adrianix360/Proyecto_mecanica_del_solido_2/07_graficos_y_prediccion/README.md

# 07 · Gráficos y predicción con probetas 2018–2019

- `Grafico_1_tension_vs_ancho.png`: resistencia a tensión según el ancho de la barra.
- `Grafico_2_compresion_vs_longitud.png`: resistencia a compresión según la longitud del tubo.
- `Prediccion_colapso_2018-2019.pdf`: predicción de la carga de colapso con las probetas 2018–2019.

Los datos de origen están en `00_enunciado_y_referencias/datos_historicos_probetas`.
