adrianix360/Proyecto_mecanica_del_solido_2/06_revision_de_diseno/README.md

# 06 · Revisión técnica independiente (v01)

Auditoría del diseño hecha antes de cortar las piezas: geometría, fuerzas internas, planos, capacidades de los miembros y verificaciones de las vigas de piso.

- `INFORME_REVISION_v01.md`: veredicto, hallazgos clasificados por gravedad y consultas.
- `Verificacion_v01.xlsx`: hojas de verificación asociadas.

Las observaciones de esta revisión (por ejemplo, H-01 y H-05) se resolvieron en la versión v02 de los planos y del despiece.
