adrianix360/Proyecto_mecanica_del_solido_2/09_informe_final/README.md

# 09 · Informe final

**Pendiente.** Aquí se publicará el informe final: memoria del proceso constructivo, memoria del proceso de falla, análisis y comparación con la predicción, conclusiones y recomendaciones.
