adrianix360/Proyecto_mecanica_del_solido_2/00_enunciado_y_referencias/README.md

# 00 · Enunciado y referencias

Contexto que se tuvo a la mano para desarrollar el proyecto. **Nada de esta carpeta es obra del autor del repositorio ni está cubierto por su licencia**: pertenece a sus respectivos titulares y se incluye solo como contexto académico para quien consulte el trabajo. Si es titular de algún documento y quiere que se retire, escriba al autor (ver el README principal).

| Subcarpeta | Contenido | Origen |
|---|---|---|
| `enunciado/` | Enunciado del proyecto y presentación de la descripción del proyecto | Docente del curso IC-0610, Escuela de Ingeniería Civil, UCR |
| `referencias/` | Ressler, *Designing and Building File-Folder Bridges* (libro y presentación), Ressler, *The Waddell A Truss Bridge*, y el ejemplo 5 del tema 6 (cercha vertical) | S. J. Ressler; material del curso |
| `plano_base_semestre_anterior/` | Planos Warren A0 (láminas de montaje y despiece) de un semestre anterior, usados como punto de partida | Trabajo de un semestre anterior |
| `datos_historicos_probetas/` | Resultados de ensayos de probetas de cartón de 2018–2019, 2022 I, 2022 II y 2023 I (Excel y archivos `.lvm` de LabVIEW) | Ensayos de semestres anteriores del curso |

Notas sobre los datos históricos:

- Los archivos `.lvm` son registros crudos de la máquina de ensayo; algunos corresponden a pruebas repetidas o a respaldos (`backup*.lvm`) y no son utilizables como resultado de una probeta.
- El procesamiento aplicado a estos datos (promedios, exclusiones y curvas) está descrito en el informe de avance y en `07_graficos_y_prediccion`.
