adrianix360/Proyecto_mecanica_del_solido_2/08_falla_del_puente/README.md

# 08 · Falla del puente

**Pendiente.** Aquí se publicará el video de la prueba de carga, el registro fotográfico, la carga máxima alcanzada, el modo de falla y la comparación con la carga predicha (≈ 12,3 kgf).
