adrianix360/Proyecto_mecanica_del_solido_2/01_avance_escrito/README.md

# 01 · Informe de avance

[`Avance_Proyecto_Puente_Warren_IC-0610.pdf`](Avance_Proyecto_Puente_Warren_IC-0610.pdf): informe de avance del proyecto (24 páginas, octubre de 2026).

Contenido: introducción, descripción del proyecto, descripción y justificación de la geometría, propiedades de diseño de los miembros, cálculo de fuerzas internas (método de nodos y CSiBridge), predicción de la carga de colapso (≈ 12,3 kgf con FS = 1,75), referencias y anexos.

El informe fue elaborado en grupo. Esta es una **copia pública**: se omitieron de la portada los nombres, los carnés y el nombre de la docente, y se eliminaron los metadatos de autoría del archivo.
