adrianix360/Proyecto_mecanica_del_solido_2/00_enunciado_y_referencias/referencias/Tema_6_Ejemplo_5_cercha_vertical.pdf

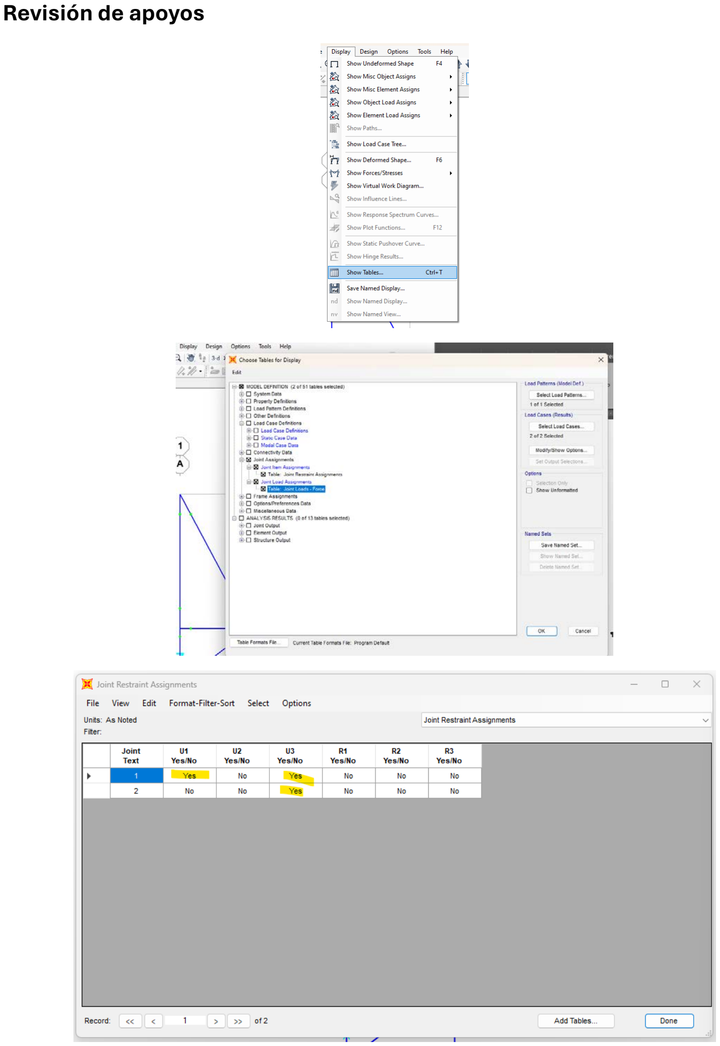
[picture p17: page 1]

Revisión de apoyos

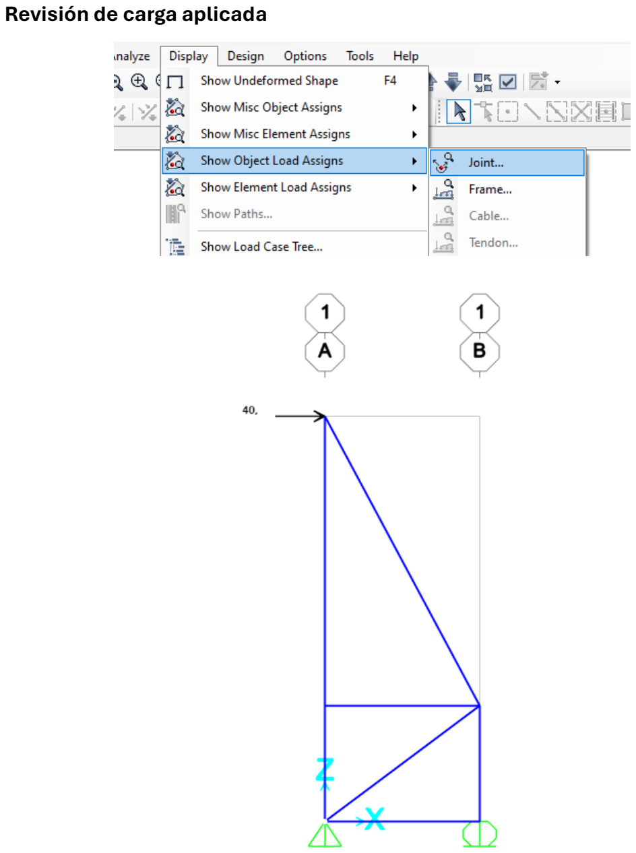
[picture p18: page 2]

Revisión de carga aplicada

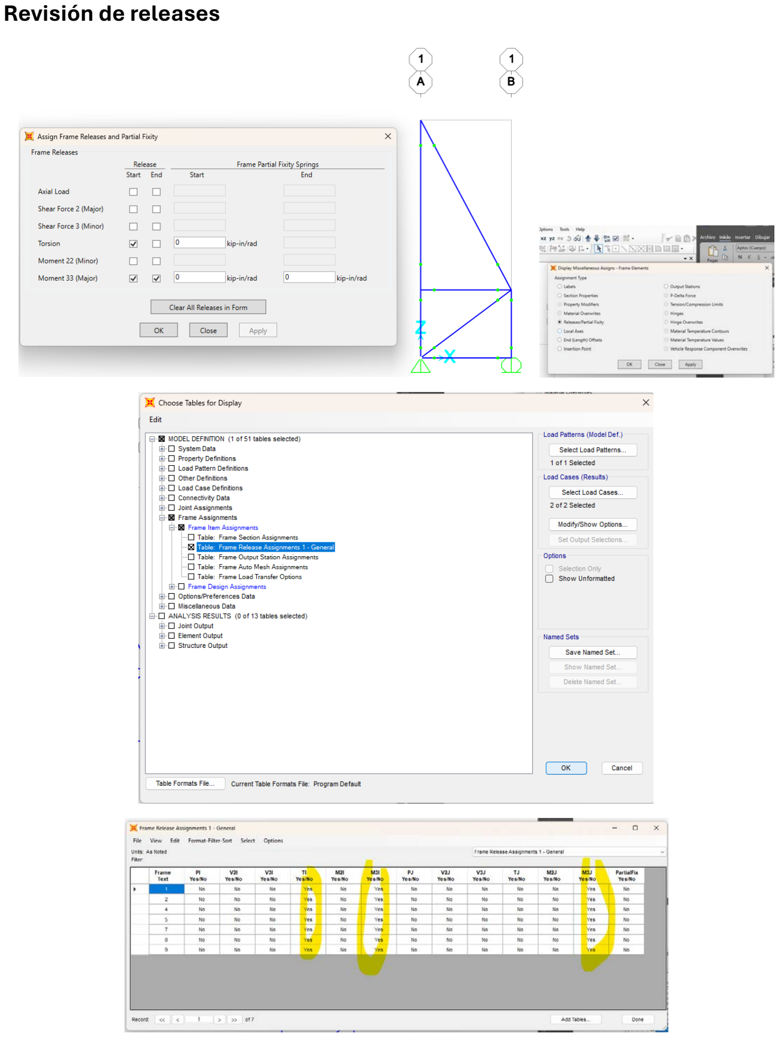
[picture p19: page 3]

Revisión de releases

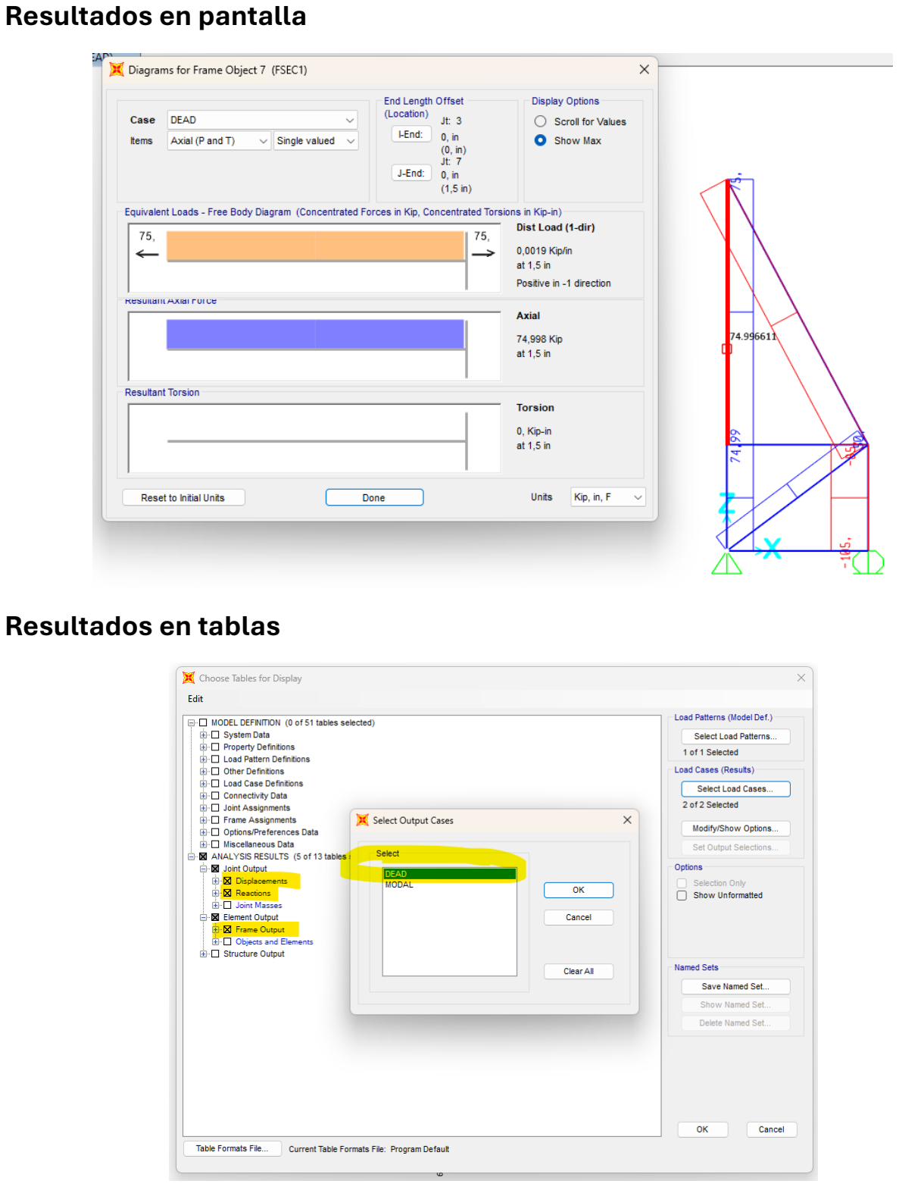
[picture p20: page 4]

Resultados en pantalla

Resultados en tablas

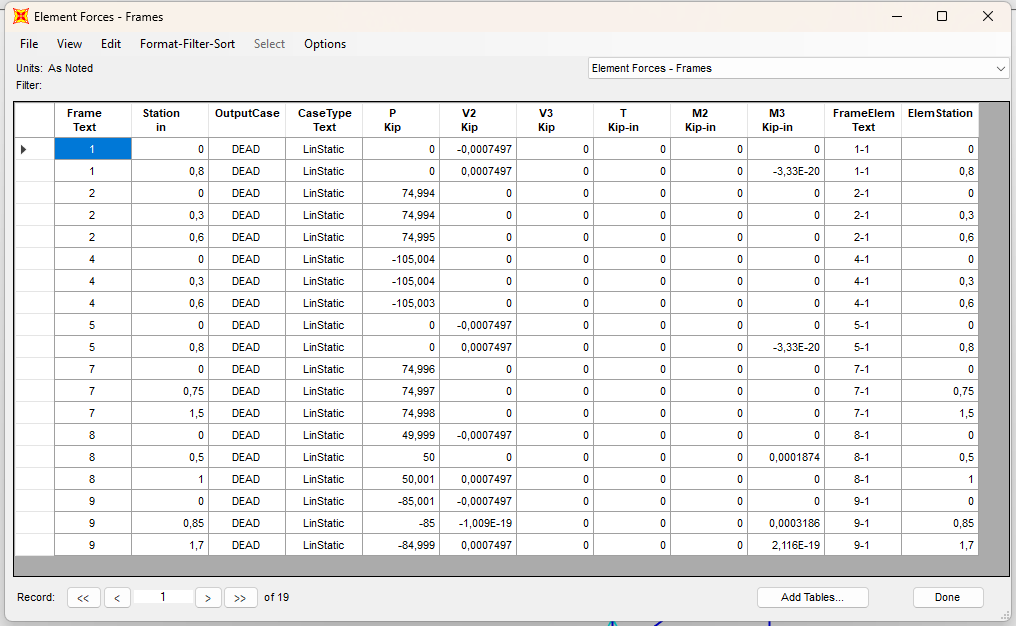
[picture p21: figure]
