adrianix360/Proyecto_mecanica_del_solido_2/04_despiece_corte_cameo/vista_previa/T08_v02.png

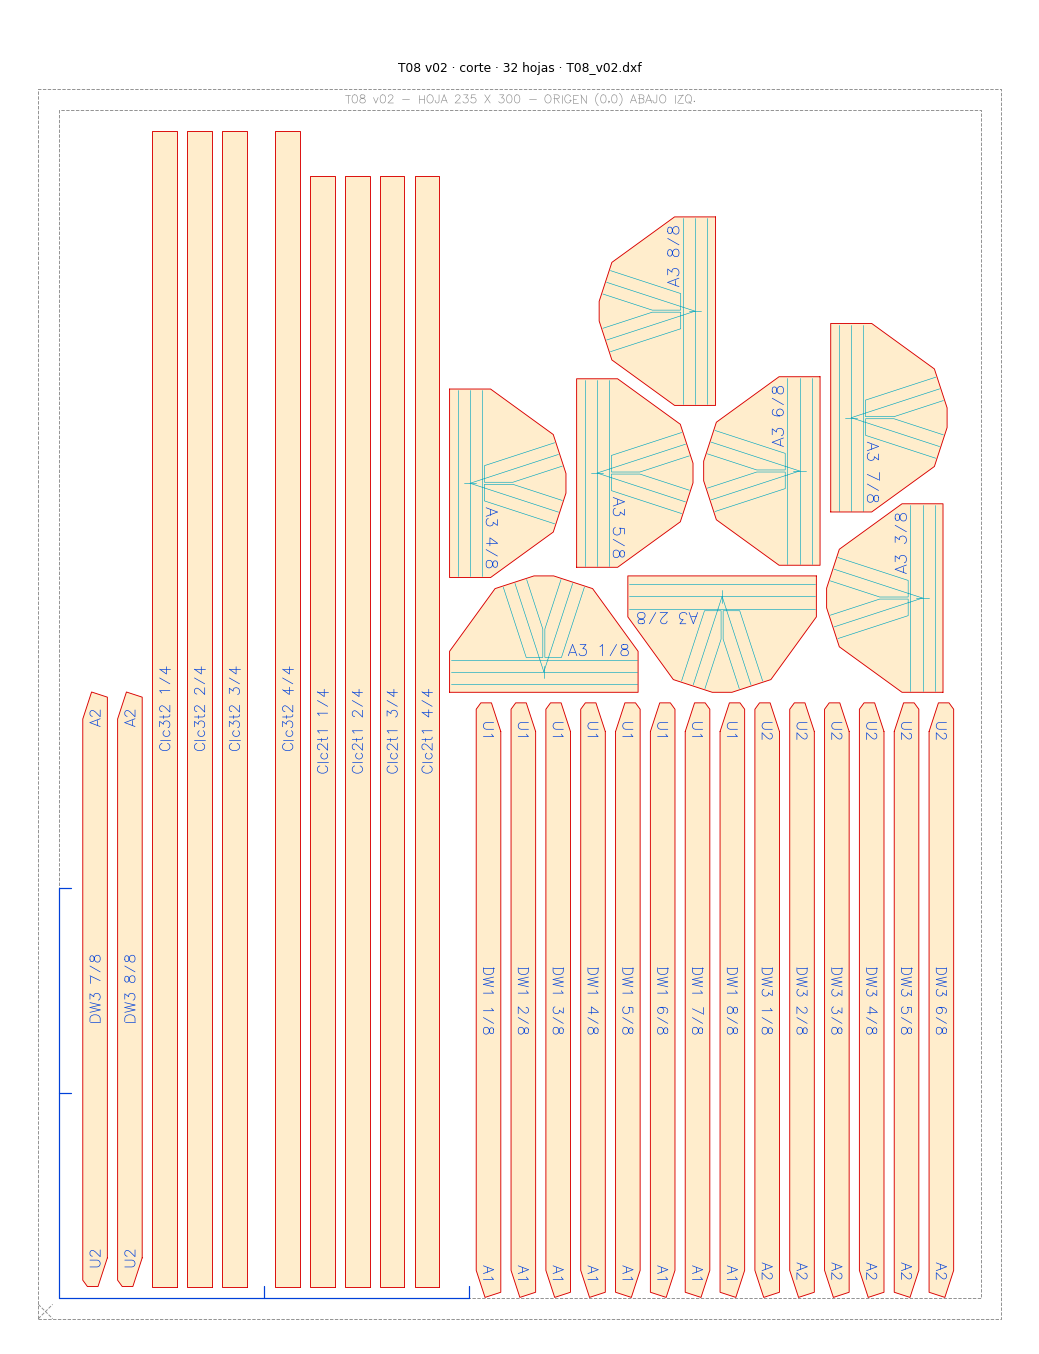
04_despiece_corte_cameo/vista_previa/T08_v02.png
