adrianix360/Proyecto_mecanica_del_solido_2/07_graficos_y_prediccion/Grafico_1_tension_vs_ancho.png

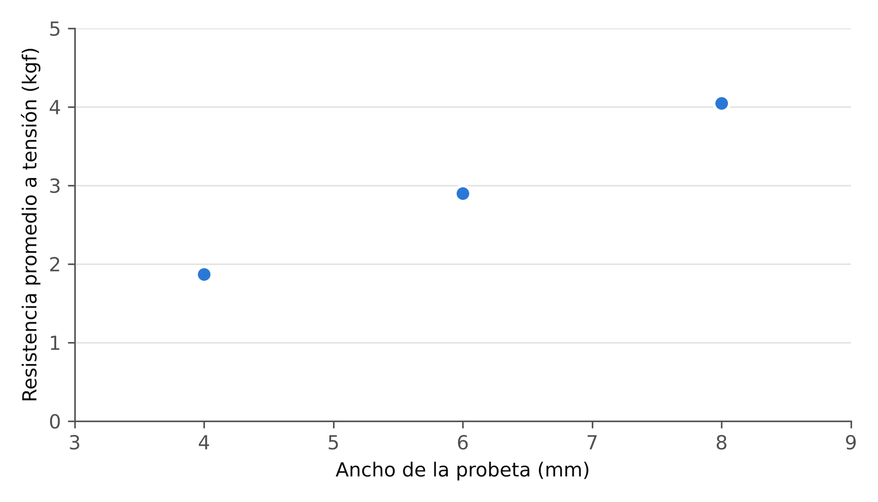
07_graficos_y_prediccion/Grafico_1_tension_vs_ancho.png
