adrianix360/Proyecto_mecanica_del_solido_2/07_graficos_y_prediccion/Grafico_2_compresion_vs_longitud.png

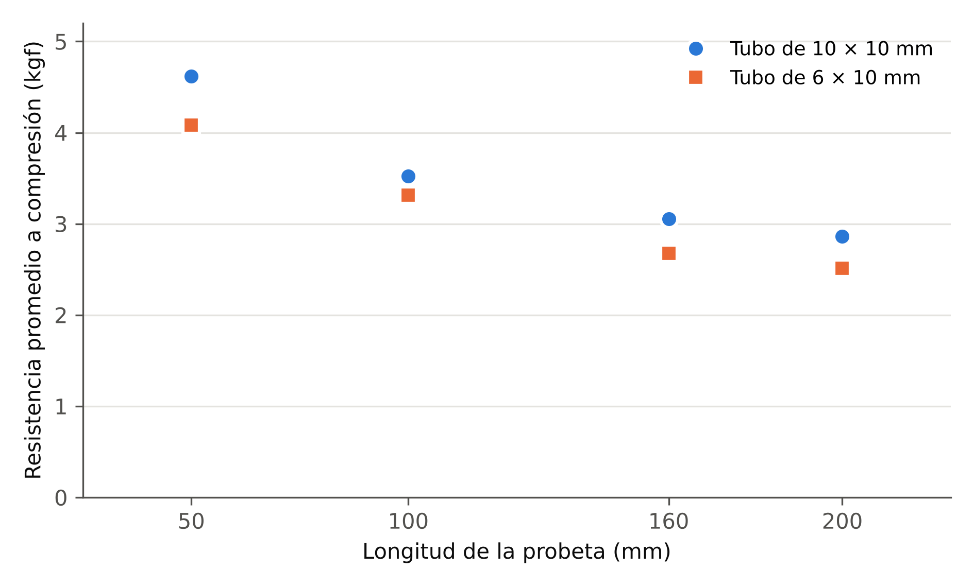
07_graficos_y_prediccion/Grafico_2_compresion_vs_longitud.png
