adrianix360/Proyecto_mecanica_del_solido_2/02_analisis_estructural/Especificacion_Puente_Warren.xlsx

Sheet: Resumen
Puente Warren IC-0610: resumen de la especificación
Todas las cifras de esta hoja salen de las otras hojas. Los supuestos (azul) están en la hoja Supuestos.
Resultado | Valor | Unidad | Nota
Carga de colapso predicha (miembros) | 21.52 | kgf | Mínimo sobre los 27 miembros × 2 armaduras
Miembro que rige | CS2 |  | Cuerda superior CS2 y CS5 en compresión; CI4, postes y diagonales a ≈1 % de distancia
Límite por viga de piso (capas dispuestas) | 23.69 | kgf | Estimación sin ensayos (κ de Supuestos)
Área total de cartón | 500895.7335 | mm²
Masa estimada | 101.9 | g | Gramaje y goma supuestos
Relación resistencia/peso | 211.1122629 | kgf/kg | P de colapso dividido entre la masa
Área de cartón por grupo
Grupo | Área (mm²) | % del total | Masa (g)
Cuerda inferior | 19728 | 3.9% | 4.0
Cuerda superior | 97152 | 19.4% | 19.8
Postes extremos | 53535.19402 | 10.7% | 10.9
Diagonales | 119872.2823 | 23.9% | 24.4
Cartelas | 100047.68 | 20.0% | 20.4
Vigas de piso | 72960 | 14.6% | 14.8
Puntales de techo | 18270 | 3.6% | 3.7
Arriostre de techo | 6246.642618 | 1.2% | 1.3
Pórticos | 2819.134619 | 0.6% | 0.6
Placas de techo | 10264.8 | 2.0% | 2.1
Control: suma de grupos − total | 0
Cumplimiento del enunciado
Dimensión | Valor (mm) | Cumple | Margen (mm)
Longitud exterior | 671.4 | Cumple | 21.4
Altura total con cartelas | 156.0 | Cumple | 4.0
Ancho exterior | 100.0 | Cumple | 10.0
Panel de cuerda inferior | 94.0 | Cumple | 4.0
Hojas: Supuestos · Nudos · Miembros · Cuerda_inferior · Secciones · Cartelas · Cartelas_vertices · Vigas_y_arriostres · Lista_de_corte · Sensibilidad
Advertencia: fuerzas y capas de Miembros son válidas solo para p = 94 y H = 144. Cambiar esas celdas actualiza coordenadas y longitudes, no el dimensionamiento.

Sheet: Supuestos
Supuestos y parámetros de diseño
Celdas en azul = entradas editables. Cambiar p o H actualiza coordenadas y longitudes, pero NO las fuerzas por miembro ni las capas (válidas para p = 94 y H = 144).
Parámetro | Valor | Unidad | Fuente / nota
Longitud de panel p (entre ejes de nudos inferiores) | 94 | mm | Decisión: colchón de 4 mm sobre el límite de 90 mm del enunciado
Altura H entre ejes de cuerdas | 144 | mm | Altura total con cartelas = H + 12 = 156 mm (límite 160 mm, colchón de 4 mm)
Ancho entre planos medios de las armaduras | 90 | mm | Plano base: 90 mm entre planos medios, 100 mm exterior
Sobresaliente longitudinal total con cartelas (largo total − 7p) | 13.4 | mm | Las cartelas de A0 y A7 sobresalen 6,7 mm de cada eje (hoja Cartelas_vertices)
Sobresaliente vertical con cartelas (altura total − H) | 12 | mm | Cartelas: +7 sobre el eje superior (mitad del tubo de 10 más 2 mm) y +5 bajo el eje inferior (mitad de la barra de 6 más 2 mm). Sale de Cartelas_vertices
Holgura de extremo de miembro en nodo e | 3 | mm | Supuesto: largo de corte = largo de eje − 2e. Poner 0 si el plano base no la descuenta
Traslape de empalme de tiras | 30 | mm | Supuesto: 2.4 veces lo requerido por cortante de goma (τ = 0.04 kgf/mm²); probar (P-06)
Anclaje de capas adicionales de la cuerda inferior | 30 | mm | Supuesto: cada capa se prolonga 30 mm más allá del nudo donde ya es necesaria
Largo máximo de una tira de cartón | 300 | mm | Supuesto: ancho útil de carpeta sin cruzar el doblez. Confirmar con una carpeta real
Eficiencia de laminación en compresión η | 0.85 | – | Supuesto propio; sin ensayos de tubos reforzados (ver Sensibilidad)
Gramaje de la carpeta | 185 | g/m² | Supuesto (rango 150–220). Pesar una carpeta para sustituirlo
Goma (porcentaje sobre el peso del cartón) | 0.1 | – | Supuesto
Resistencia de cortante de goma τ | 0.04 | kgf/mm² | Supuesto conservador (≈0.4 MPa); define traslapes de cartelas, validar con prueba de tracción de una unión
Factor κ de flexión de viga de piso | 0.5 | – | Supuesto por pandeo local del ala comprimida; sin ensayos. Ver hoja Vigas_y_arriostres
Ancho exterior del puente | 100 | mm | Plano base
Número de paneles | 7 | – | Única opción simétrica con 4 cargas equidistantes en nudos centrales
Resistencia a tensión de una capa (kgf), promedio ponderado de 2018–19, 2022 I y 2022 II
Ancho de barra (mm) | 4 | 6 | 8
Capacidad C1 (kgf) | 1.82 | 2.96 | 4.40
Nota: se excluye 2023 I (registros de tensión dudosos). n por ancho: 36, 42, 37.
Capacidad de un tubo de una capa según su longitud (kgf), promedio ponderado de los 4 semestres
Longitud (mm) | 50 | 100 | 160 | 200
Tubo 10×10 | 4.44 | 3.71 | 3.00 | 2.78
Tubo 6×10 | 3.75 | 3.45 | 2.59 | 2.49
Límites del enunciado (mm)
Dimensión | Mínimo | Máximo | Nota
Longitud total | 650 | 750 | 700 ± 50
Ancho | 90 | 110 | 100 ± 10
Altura | 140 | 160 | 150 ± 10
Panel de cuerda inferior | 90 | 110 | 100 ± 10

Sheet: Secciones
Catálogo de secciones y desarrollos para el plano de corte
Desarrollo = ancho de la hoja desplegada. Para n capas se laminan n hojas con goma antes de plegar; el desarrollo no cambia.
Código | Descripción | Desarrollo (mm) | Ancho en el plano (mm) | Marcas de pliegue desde un borde (mm) | Uso
B4 | Barra de 4 mm | 4 | 4 | — | Arriostres de techo y pórticos
B6 | Barra de 6 mm | 6 | 6 | — | Cuerda inferior y diagonales en tensión
T10x10 | Tubo 10×10 mm | 46 | 10 | 10 / 20 / 30 / 40; solapa de 6 mm (40→46) | Cuerda superior, postes extremos, diagonales en compresión
T6x10 | Tubo 6×10 mm (lado de 6 mm en el plano) | 38 | 6 | 10 / 16 / 26 / 32; solapa de 6 mm (32→38) | Diagonales centrales sin carga (DW6 y DW7)
T15x6 | Tubo 15×6 mm | 48 | 15 | 15 / 21 / 36 / 42; solapa de 6 mm (42→48); pestañas de 5 mm en cada extremo | Vigas de piso
T6x6 | Tubo 6×6 mm | 29 | 6 | 6 / 12 / 18 / 24; solapa de 5 mm (24→29) | Puntales de techo

Sheet: Nudos
Coordenadas de nudos (origen en el apoyo A0, eje x a lo largo del puente, eje y hacia arriba)
Medidas entre ejes de miembros, en mm. Las armaduras 1 y 2 son idénticas y están separadas por el ancho entre planos medios.
Nudo | x (mm) | y (mm) | Carga | Índice i | Observación
A0 | 0.00 | 0.00 |  | 0 | Apoyo fijo (pin)
A1 | 94.00 | 0.00 |  | 1
A2 | 188.00 | 0.00 | P/4 | 2 | Nudo cargado con P/4 (sobre su viga de piso)
A3 | 282.00 | 0.00 | P/4 | 3 | Nudo cargado con P/4 (sobre su viga de piso)
A4 | 376.00 | 0.00 | P/4 | 4 | Nudo cargado con P/4 (sobre su viga de piso)
A5 | 470.00 | 0.00 | P/4 | 5 | Nudo cargado con P/4 (sobre su viga de piso)
A6 | 564.00 | 0.00 |  | 6
A7 | 658.00 | 0.00 |  | 7 | Apoyo móvil (rodillo)
U1 | 47.00 | 144.00 |  | 1
U2 | 141.00 | 144.00 |  | 2
U3 | 235.00 | 144.00 |  | 3
U4 | 329.00 | 144.00 |  | 4
U5 | 423.00 | 144.00 |  | 5
U6 | 517.00 | 144.00 |  | 6
U7 | 611.00 | 144.00 |  | 7
Verificación contra los límites del enunciado
Dimensión | Valor (mm) | Mínimo | Máximo | Cumple | Margen al límite más cercano (mm)
Longitud exterior | 671.4 | 650 | 750 | Cumple | 21.4
Altura total con cartelas | 156.0 | 140 | 160 | Cumple | 4.0
Ancho exterior | 100.0 | 90 | 110 | Cumple | 10.0
Panel de cuerda inferior | 94.0 | 90 | 110 | Cumple | 4.0

Sheet: Miembros
Miembros de una armadura (27); el puente lleva dos idénticas
Fuerza por kgf aplicado a UNA armadura (tensión +). Calculada con un solver de rigidez en Python para p = 94 y H = 144; recalcular si cambia la geometría.
ID | Grupo | Nudo i | Nudo j | x i | y i | x j | y j | Largo de eje (mm) | Ángulo (°) | Fuerza por kgf | Estado | Sección | Ancho en plano (mm) | Capas n | Desarrollo por hoja (mm) | Largo de corte (mm) | C1 una capa (kgf) | Capacidad (kgf) | P límite puente (kgf) | Área de cartón por armadura (mm²) | Observación | Fila | Índice
CI1 | Cuerda inferior | A0 | A1 | 0.0 | 0.0 | 94.0 | 0.0 | 94.00 | 0.00 | +0.163 | Tensión | B6 | 6 | 1 | 6 | ver Cuerda_inferior | 2.96 | 2.96 | 36.36 | 0 | Capas continuas: ver Cuerda_inferior | 2 | 1
CI2 | Cuerda inferior | A1 | A2 | 94.0 | 0.0 | 188.0 | 0.0 | 94.00 | 0.00 | +0.490 | Tensión | B6 | 6 | 2 | 6 | ver Cuerda_inferior | 2.96 | 5.93 | 24.19 | 0 | Capas continuas: ver Cuerda_inferior | 2 | 1
CI3 | Cuerda inferior | A2 | A3 | 188.0 | 0.0 | 282.0 | 0.0 | 94.00 | 0.00 | +0.734 | Tensión | B6 | 6 | 3 | 6 | ver Cuerda_inferior | 2.96 | 8.89 | 24.22 | 0 | Capas continuas: ver Cuerda_inferior | 2 | 1
CI4 | Cuerda inferior | A3 | A4 | 282.0 | 0.0 | 376.0 | 0.0 | 94.00 | 0.00 | +0.816 | Tensión | B6 | 6 | 3 | 6 | ver Cuerda_inferior | 2.96 | 8.89 | 21.79 | 0 | Capas continuas: ver Cuerda_inferior | 2 | 1
CI5 | Cuerda inferior | A4 | A5 | 376.0 | 0.0 | 470.0 | 0.0 | 94.00 | 0.00 | +0.734 | Tensión | B6 | 6 | 3 | 6 | ver Cuerda_inferior | 2.96 | 8.89 | 24.22 | 0 | Capas continuas: ver Cuerda_inferior | 2 | 1
CI6 | Cuerda inferior | A5 | A6 | 470.0 | 0.0 | 564.0 | 0.0 | 94.00 | 0.00 | +0.490 | Tensión | B6 | 6 | 2 | 6 | ver Cuerda_inferior | 2.96 | 5.93 | 24.19 | 0 | Capas continuas: ver Cuerda_inferior | 2 | 1
CI7 | Cuerda inferior | A6 | A7 | 564.0 | 0.0 | 658.0 | 0.0 | 94.00 | 0.00 | +0.163 | Tensión | B6 | 6 | 1 | 6 | ver Cuerda_inferior | 2.96 | 2.96 | 36.36 | 0 | Capas continuas: ver Cuerda_inferior | 2 | 1
CS1 | Cuerda superior | U1 | U2 | 47.0 | 144.0 | 141.0 | 144.0 | 94.00 | 0.00 | -+0.326 | Compresión | T10x10 | 10 | 1 | 46 | 88.0 | 3.80 | 3.80 | 23.30 | 4048 |  | 1 | 1
CS2 | Cuerda superior | U2 | U3 | 141.0 | 144.0 | 235.0 | 144.0 | 94.00 | 0.00 | -+0.653 | Compresión | T10x10 | 10 | 2 | 46 | 88.0 | 3.80 | 7.03 | 21.52 | 8096 |  | 1 | 1
CS3 | Cuerda superior | U3 | U4 | 235.0 | 144.0 | 329.0 | 144.0 | 94.00 | 0.00 | -+0.816 | Compresión | T10x10 | 10 | 3 | 46 | 88.0 | 3.80 | 10.25 | 25.13 | 12144 |  | 1 | 1
CS4 | Cuerda superior | U4 | U5 | 329.0 | 144.0 | 423.0 | 144.0 | 94.00 | 0.00 | -+0.816 | Compresión | T10x10 | 10 | 3 | 46 | 88.0 | 3.80 | 10.25 | 25.13 | 12144 |  | 1 | 1
CS5 | Cuerda superior | U5 | U6 | 423.0 | 144.0 | 517.0 | 144.0 | 94.00 | 0.00 | -+0.653 | Compresión | T10x10 | 10 | 2 | 46 | 88.0 | 3.80 | 7.03 | 21.52 | 8096 |  | 1 | 1
CS6 | Cuerda superior | U6 | U7 | 517.0 | 144.0 | 611.0 | 144.0 | 94.00 | 0.00 | -+0.326 | Compresión | T10x10 | 10 | 1 | 46 | 88.0 | 3.80 | 3.80 | 23.30 | 4048 |  | 1 | 1
PE1 | Poste extremo | A0 | U1 | 0.0 | 0.0 | 47.0 | 144.0 | 151.48 | 71.92 | -+0.526 | Compresión | T10x10 | 10 | 2 | 46 | 145.5 | 3.10 | 5.73 | 21.80 | 13383.79851 |  | 1 | 2
PE2 | Poste extremo | A7 | U7 | 658.0 | 0.0 | 611.0 | 144.0 | 151.48 | 108.08 | -+0.526 | Compresión | T10x10 | 10 | 2 | 46 | 145.5 | 3.10 | 5.73 | 21.80 | 13383.79851 |  | 1 | 2
DW1 | Diagonal | U1 | A1 | 47.0 | 144.0 | 94.0 | 0.0 | 151.48 | -71.92 | +0.526 | Tensión | B6 | 6 | 2 | 6 | 145.5 | 2.96 | 5.93 | 22.53 | 1745.712849 |  | 2 | 2
DW2 | Diagonal | A1 | U2 | 94.0 | 0.0 | 141.0 | 144.0 | 151.48 | 71.92 | -+0.526 | Compresión | T10x10 | 10 | 2 | 46 | 145.5 | 3.10 | 5.73 | 21.80 | 13383.79851 |  | 1 | 2
DW3 | Diagonal | U2 | A2 | 141.0 | 144.0 | 188.0 | 0.0 | 151.48 | -71.92 | +0.526 | Tensión | B6 | 6 | 2 | 6 | 145.5 | 2.96 | 5.93 | 22.53 | 1745.712849 |  | 2 | 2
DW4 | Diagonal | A2 | U3 | 188.0 | 0.0 | 235.0 | 144.0 | 151.48 | 71.92 | -+0.263 | Compresión | T10x10 | 10 | 1 | 46 | 145.5 | 3.10 | 3.10 | 23.57 | 6691.899253 |  | 1 | 2
DW5 | Diagonal | U3 | A3 | 235.0 | 144.0 | 282.0 | 0.0 | 151.48 | -71.92 | +0.263 | Tensión | B6 | 6 | 1 | 6 | 145.5 | 2.96 | 2.96 | 22.53 | 872.8564243 |  | 2 | 2
DW6 | Diagonal | A3 | U4 | 282.0 | 0.0 | 329.0 | 144.0 | 151.48 | 71.92 | +0.000 | Sin carga (estabiliza) | T6x10 | 6 | 1 | 38 | 145.5 | 2.71 | 2.71 |  | 5528.090687 |  | 2 | 2
DW7 | Diagonal | U4 | A4 | 329.0 | 144.0 | 376.0 | 0.0 | 151.48 | -71.92 | +0.000 | Sin carga (estabiliza) | T6x10 | 6 | 1 | 38 | 145.5 | 2.71 | 2.71 |  | 5528.090687 |  | 2 | 2
DW8 | Diagonal | A4 | U5 | 376.0 | 0.0 | 423.0 | 144.0 | 151.48 | 71.92 | +0.263 | Tensión | B6 | 6 | 1 | 6 | 145.5 | 2.96 | 2.96 | 22.53 | 872.8564243 |  | 2 | 2
DW9 | Diagonal | U5 | A5 | 423.0 | 144.0 | 470.0 | 0.0 | 151.48 | -71.92 | -+0.263 | Compresión | T10x10 | 10 | 1 | 46 | 145.5 | 3.10 | 3.10 | 23.57 | 6691.899253 |  | 1 | 2
DW10 | Diagonal | A5 | U6 | 470.0 | 0.0 | 517.0 | 144.0 | 151.48 | 71.92 | +0.526 | Tensión | B6 | 6 | 2 | 6 | 145.5 | 2.96 | 5.93 | 22.53 | 1745.712849 |  | 2 | 2
DW11 | Diagonal | U6 | A6 | 517.0 | 144.0 | 564.0 | 0.0 | 151.48 | -71.92 | -+0.526 | Compresión | T10x10 | 10 | 2 | 46 | 145.5 | 3.10 | 5.73 | 21.80 | 13383.79851 |  | 1 | 2
DW12 | Diagonal | A6 | U7 | 564.0 | 0.0 | 611.0 | 144.0 | 151.48 | 71.92 | +0.526 | Tensión | B6 | 6 | 2 | 6 | 145.5 | 2.96 | 5.93 | 22.53 | 1745.712849 |  | 2 | 2
Resultado
P de colapso por miembros (kgf, puente) |  |  |  |  |  |  |  | 21.52
Miembro que rige |  |  |  |  |  |  |  | CS2
Capacidades: barras = n × C1(ancho); tubos = C1(largo, interpolado) × (1 + η × (n − 1)). Factor de seguridad 1.0.

Sheet: Cuerda_inferior
Cuerda inferior: tiras apiladas con traslapes escalonados (por armadura)
Cada capa es una serie de tiras de 6 mm pegadas entre sí en el plano medio, entre las cartelas. La capa k cubre los miembros que necesitan al menos k capas. Posiciones x medidas desde A0; válidas para p = 94.
Capa | Tira | Ancho (mm) | Desde x (mm) | Hasta x (mm) | Largo (mm) | Largo ≤ máximo | Inicio del traslape que cierra la tira (mm) | Miembro del traslape | Tiras en el puente
1 | 1 | 6 | 3.0 | 165.0 | 162.0 | Sí | 135.0 | CI2 | 2
1 | 2 | 6 | 135.0 | 430.0 | 295.0 | Sí | 400.0 | CI5 | 2
1 | 3 | 6 | 400.0 | 655.0 | 255.0 | Sí |  |  | 2
2 | 1 | 6 | 64.0 | 335.0 | 271.0 | Sí | 305.0 | CI4 | 2
2 | 2 | 6 | 305.0 | 594.0 | 289.0 | Sí |  |  | 2
3 | 1 | 6 | 158.0 | 248.0 | 90.0 | Sí | 218.0 | CI3 | 2
3 | 2 | 6 | 218.0 | 500.0 | 282.0 | Sí |  |  | 2
Tramo que cubre cada capa
Capa | Desde x (mm) | Hasta x (mm) |  |  |  |  | Descripción
1 | 3.0 | 655.0 |  |  |  |  | A0–A7 (CI1 a CI7)
2 | 64.0 | 594.0 |  |  |  |  | A1–A6 (CI2 a CI6) más anclaje de 30 mm
3 | 158.0 | 500.0 |  |  |  |  | A2–A5 (CI3 a CI5) más anclaje de 30 mm
Verificación de capas por miembro
Miembro | Capas según Miembros | Capas que aporta el apilado | Coincide
CI1 | 1 | 1 | Sí
CI2 | 2 | 2 | Sí
CI3 | 3 | 3 | Sí
CI4 | 3 | 3 | Sí
CI5 | 3 | 3 | Sí
CI6 | 2 | 2 | Sí
CI7 | 1 | 1 | Sí
Reglas de empalme
Cada traslape cae en un miembro distinto y a ≥ 50 mm de los traslapes de otras capas; todos quedan a ≥ 20 mm del eje de los nudos.
Traslape de 30 mm pegado en el plano medio; ninguna tira supera el largo máximo de Supuestos.
El traslape de la capa 2 cae en CI4: con tiras de hasta 300 mm, la capa 2 (530 mm) solo se divide en dos tiras y estas se unen en el centro. No hay otra posición posible.
El traslape de la capa 1 en CI2 y CI5 y el de la capa 3 en CI3 evitan que dos capas se empalmen en el mismo miembro.

Sheet: Cartelas_vertices
Vértices de las cartelas por nudo
Contorno = casco convexo de los traslapes de cada miembro (ancho del miembro + 2 mm por lado). x, y relativos al centro del nudo; x, y absolutos en el sistema de la hoja Nudos.
Nudo | Vértice | x relativo (mm) | y relativo (mm) | x absoluto (mm) | y absoluto (mm)
A0 | 1 | -6.7 | 2.2 | -6.7 | 2.2
A0 | 2 | 0.0 | -5.0 | 0.0 | -5.0
A0 | 3 | 23.0 | -5.0 | 23.0 | -5.0
A0 | 4 | 23.0 | 5.0 | 23.0 | 5.0
A0 | 5 | 13.8 | 19.7 | 13.8 | 19.7
A0 | 6 | 0.5 | 24.0 | 0.5 | 24.0
A1 | 1 | -23.0 | -5.0 | 71.0 | -5.0
A1 | 2 | 23.0 | -5.0 | 117.0 | -5.0
A1 | 3 | 23.0 | 5.0 | 117.0 | 5.0
A1 | 4 | 13.8 | 19.7 | 107.8 | 19.7
A1 | 5 | 0.5 | 24.0 | 94.5 | 24.0
A1 | 6 | -2.4 | 23.4 | 91.6 | 23.4
A1 | 7 | -11.9 | 20.3 | 82.1 | 20.3
A1 | 8 | -23.0 | 5.0 | 71.0 | 5.0
A2 | 1 | -23.0 | -5.0 | 165.0 | -5.0
A2 | 2 | 23.0 | -5.0 | 211.0 | -5.0
A2 | 3 | 23.0 | 5.0 | 211.0 | 5.0
A2 | 4 | 13.8 | 19.7 | 201.8 | 19.7
A2 | 5 | 0.5 | 24.0 | 188.5 | 24.0
A2 | 6 | -2.4 | 23.4 | 185.6 | 23.4
A2 | 7 | -11.9 | 20.3 | 176.1 | 20.3
A2 | 8 | -23.0 | 5.0 | 165.0 | 5.0
A3 | 1 | -23.0 | -5.0 | 259.0 | -5.0
A3 | 2 | 23.0 | -5.0 | 305.0 | -5.0
A3 | 3 | 23.0 | 5.0 | 305.0 | 5.0
A3 | 4 | 11.9 | 20.3 | 293.9 | 20.3
A3 | 5 | 2.4 | 23.4 | 284.4 | 23.4
A3 | 6 | -2.4 | 23.4 | 279.6 | 23.4
A3 | 7 | -11.9 | 20.3 | 270.1 | 20.3
A3 | 8 | -23.0 | 5.0 | 259.0 | 5.0
A4 | 1 | -23.0 | -5.0 | 353.0 | -5.0
A4 | 2 | 23.0 | -5.0 | 399.0 | -5.0
A4 | 3 | 23.0 | 5.0 | 399.0 | 5.0
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
U7 | 1 | -23.0 | -7.0 | 588.0 | 137.0
U7 | 2 | -11.9 | -20.3 | 599.1 | 123.7
U7 | 3 | -2.4 | -23.4 | 608.6 | 120.6
U7 | 4 | 0.5 | -24.0 | 611.5 | 120.0
U7 | 5 | 13.8 | -19.7 | 624.8 | 124.3
U7 | 6 | 6.7 | 2.2 | 617.7 | 146.2
U7 | 7 | 0.0 | 7.0 | 611.0 | 151.0
U7 | 8 | -23.0 | 7.0 | 588.0 | 151.0

Sheet: Cartelas
Cartelas por nudo (misma silueta en las 4 caras: 2 armaduras × 2 caras)
Capas por cara g según la fuerza máxima del nudo (regla provisional). Traslape medido desde el extremo del miembro.
Nudo | x nudo | y nudo | Capas por cara | Área de una hoja (mm²) | Hojas en el puente | Área total (mm²) | Traslape por miembro (mm) | Fuerza máx. de miembro (kgf)
A0 | 0.0 | 0.0 | 1 | 622.925 | 4 | 2491.7 | CI1 20; PE1 20 | 5.73
A1 | 94.0 | 0.0 | 1 | 1050.945 | 4 | 4203.78 | CI1 20; CI2 20; DW1 20; DW2 20 | 5.93
A2 | 188.0 | 0.0 | 2 | 1050.945 | 8 | 8407.56 | CI2 20; CI3 20; DW3 20; DW4 20 | 8.89
A3 | 282.0 | 0.0 | 2 | 1038.3 | 8 | 8306.4 | CI3 20; CI4 20; DW5 20; DW6 20 | 8.89
A4 | 376.0 | 0.0 | 2 | 1038.3 | 8 | 8306.4 | CI4 20; CI5 20; DW7 20; DW8 20 | 8.89
A5 | 470.0 | 0.0 | 2 | 1050.945 | 8 | 8407.56 | CI5 20; CI6 20; DW9 20; DW10 20 | 8.89
A6 | 564.0 | 0.0 | 1 | 1050.945 | 4 | 4203.78 | CI6 20; CI7 20; DW11 20; DW12 20 | 5.93
A7 | 658.0 | 0.0 | 1 | 622.925 | 4 | 2491.7 | CI7 20; PE2 20 | 5.73
U1 | 47.0 | 144.0 | 1 | 848.12 | 4 | 3392.48 | CS1 20; PE1 20; DW1 20 | 5.93
U2 | 141.0 | 144.0 | 2 | 1163.245 | 8 | 9305.96 | CS1 20; CS2 20; DW2 20; DW3 20 | 7.03
U3 | 235.0 | 144.0 | 2 | 1163.245 | 8 | 9305.96 | CS2 20; CS3 20; DW4 20; DW5 20 | 10.25
U4 | 329.0 | 144.0 | 2 | 1152.5 | 8 | 9220 | CS3 20; CS4 20; DW6 20; DW7 20 | 10.25
U5 | 423.0 | 144.0 | 2 | 1163.245 | 8 | 9305.96 | CS4 20; CS5 20; DW8 20; DW9 20 | 10.25
U6 | 517.0 | 144.0 | 2 | 1163.245 | 8 | 9305.96 | CS5 20; CS6 20; DW10 20; DW11 20 | 7.03
U7 | 611.0 | 144.0 | 1 | 848.12 | 4 | 3392.48 | CS6 20; PE2 20; DW12 20 | 5.93
Total de hojas de cartela y área |  |  |  |  | 96 | 100047.68

Sheet: Vigas_y_arriostres
Vigas de piso, puntales, arriostramiento y pórticos
Vigas de piso 15×6 (obligatorias): hoja base con pestañas de 5 mm y cubrejuntas centradas, laminadas antes de plegar.
Capacidad estimada de flexión de la viga de piso (supuesto; sin ensayos)
M1 una capa (kgf·mm) | 37.5 |  | Se calcula como 0.455 kgf/mm (resistencia por ancho en tensión, barra de 4 mm) × S/t = 165 mm² (tubo 15×6, pared delgada) × κ
M con n capas | 37.5 | 69.4 | 101.4 | 133.3
P límite del puente por viga (kgf) | 6.7 | 12.3 | 18.0 | 23.7
Fórmula: M = (P/4) × luz / 4 con luz = ancho entre planos medios; P límite = Mn / (luz/16).
Viga | x (mm) | Cargada | Hoja base: desarrollo × largo | Cubrejunta 1 (largo) | Cubrejunta 2 (largo) | Cubrejunta 3 (largo) | Hojas por viga | Área por viga (mm²) | Nota
VP0 | 0.0 | No | 48 × 100 | 0 | 0 | 0 | 1 | 4800 | Una capa
VP1 | 94.0 | No | 48 × 100 | 0 | 0 | 0 | 1 | 4800 | Una capa
VP2 | 188.0 | Sí | 48 × 100 | 85 | 60 | 35 | 4 | 13440 | Reforzada con cubrejuntas centradas
VP3 | 282.0 | Sí | 48 × 100 | 85 | 60 | 35 | 4 | 13440 | Reforzada con cubrejuntas centradas
VP4 | 376.0 | Sí | 48 × 100 | 85 | 60 | 35 | 4 | 13440 | Reforzada con cubrejuntas centradas
VP5 | 470.0 | Sí | 48 × 100 | 85 | 60 | 35 | 4 | 13440 | Reforzada con cubrejuntas centradas
VP6 | 564.0 | No | 48 × 100 | 0 | 0 | 0 | 1 | 4800 | Una capa
VP7 | 658.0 | No | 48 × 100 | 0 | 0 | 0 | 1 | 4800 | Una capa
Total vigas de piso (mm²) |  |  |  |  |  |  |  | 72960
Elemento | Cantidad | Sección | Desarrollo (mm) | Largo (mm) | Capas | Hojas | Área total (mm²) |  | Nota
Puntales de techo PS | 7 | T6x6 | 29 | 90.0 | 1 | 7 | 18270 |  | Entre planos medios, uno por nudo superior U1–U7
Arriostre de techo en X | 12 | B4 | 4 | 130.1 | 1 | 12 | 6246.642618 |  | Dos tiras por panel superior, 6 paneles
Pórticos de extremo en X | 4 | B4 | 4 | 176.2 | 1 | 4 | 2819.134619 |  | Dos X (una por extremo), en el plano inclinado del poste
Placas de techo GT | 14 | PLACA | 30 | 24.44 | 1 | 14 | 10264.8 |  | 30 × 24.44 mm, igual que el plano base

Sheet: Lista_de_corte
Lista de corte del puente completo (2 armaduras)
Largos en mm. Hojas = capas × piezas. Para tubos, cada hoja se corta del desarrollo indicado y se lamina antes de plegar.
Grupo | Pieza | Sección | Desarrollo / ancho (mm) | Largo (mm) | Capas por pieza | Piezas | Hojas totales | Área total (mm²) | Nota
Cuerda superior | CS1 | T10x10 | 46.0 | 88.0 | 1 | 2 | 2 | 8096 | Una pieza por armadura
Cuerda superior | CS2 | T10x10 | 46.0 | 88.0 | 2 | 2 | 4 | 16192 | Una pieza por armadura
Cuerda superior | CS3 | T10x10 | 46.0 | 88.0 | 3 | 2 | 6 | 24288 | Una pieza por armadura
Cuerda superior | CS4 | T10x10 | 46.0 | 88.0 | 3 | 2 | 6 | 24288 | Una pieza por armadura
Cuerda superior | CS5 | T10x10 | 46.0 | 88.0 | 2 | 2 | 4 | 16192 | Una pieza por armadura
Cuerda superior | CS6 | T10x10 | 46.0 | 88.0 | 1 | 2 | 2 | 8096 | Una pieza por armadura
Postes extremos | PE1 | T10x10 | 46.0 | 145.5 | 2 | 2 | 4 | 26767.59701 | Una pieza por armadura
Postes extremos | PE2 | T10x10 | 46.0 | 145.5 | 2 | 2 | 4 | 26767.59701 | Una pieza por armadura
Diagonales | DW1 | B6 | 6.0 | 145.5 | 2 | 2 | 4 | 3491.425697 | Una pieza por armadura
Diagonales | DW2 | T10x10 | 46.0 | 145.5 | 2 | 2 | 4 | 26767.59701 | Una pieza por armadura
Diagonales | DW3 | B6 | 6.0 | 145.5 | 2 | 2 | 4 | 3491.425697 | Una pieza por armadura
Diagonales | DW4 | T10x10 | 46.0 | 145.5 | 1 | 2 | 2 | 13383.79851 | Una pieza por armadura
Diagonales | DW5 | B6 | 6.0 | 145.5 | 1 | 2 | 2 | 1745.712849 | Una pieza por armadura
Diagonales | DW6 | T6x10 | 38.0 | 145.5 | 1 | 2 | 2 | 11056.18137 | Una pieza por armadura
Diagonales | DW7 | T6x10 | 38.0 | 145.5 | 1 | 2 | 2 | 11056.18137 | Una pieza por armadura
Diagonales | DW8 | B6 | 6.0 | 145.5 | 1 | 2 | 2 | 1745.712849 | Una pieza por armadura
Diagonales | DW9 | T10x10 | 46.0 | 145.5 | 1 | 2 | 2 | 13383.79851 | Una pieza por armadura
Diagonales | DW10 | B6 | 6.0 | 145.5 | 2 | 2 | 4 | 3491.425697 | Una pieza por armadura
Diagonales | DW11 | T10x10 | 46.0 | 145.5 | 2 | 2 | 4 | 26767.59701 | Una pieza por armadura
Diagonales | DW12 | B6 | 6.0 | 145.5 | 2 | 2 | 4 | 3491.425697 | Una pieza por armadura
Cuerda inferior | Capa 1 tira 1 | B6 | 6.0 | 162.0 | 1 | 2 | 2 | 1944 | Traslape de 30 mm; ver hoja Cuerda_inferior
Cuerda inferior | Capa 1 tira 2 | B6 | 6.0 | 295.0 | 1 | 2 | 2 | 3540 | Traslape de 30 mm; ver hoja Cuerda_inferior
Cuerda inferior | Capa 1 tira 3 | B6 | 6.0 | 255.0 | 1 | 2 | 2 | 3060 | Traslape de 30 mm; ver hoja Cuerda_inferior
Cuerda inferior | Capa 2 tira 1 | B6 | 6.0 | 271.0 | 1 | 2 | 2 | 3252 | Traslape de 30 mm; ver hoja Cuerda_inferior
Cuerda inferior | Capa 2 tira 2 | B6 | 6.0 | 289.0 | 1 | 2 | 2 | 3468 | Traslape de 30 mm; ver hoja Cuerda_inferior
Cuerda inferior | Capa 3 tira 1 | B6 | 6.0 | 90.0 | 1 | 2 | 2 | 1080 | Traslape de 30 mm; ver hoja Cuerda_inferior
Cuerda inferior | Capa 3 tira 2 | B6 | 6.0 | 282.0 | 1 | 2 | 2 | 3384 | Traslape de 30 mm; ver hoja Cuerda_inferior
Cartelas | Cartela A0 | Placa | polígono | ver vértices | 1 | 4 | 4 | 2491.7 | 4 caras × capas por cara
Cartelas | Cartela A1 | Placa | polígono | ver vértices | 1 | 4 | 4 | 4203.78 | 4 caras × capas por cara
Cartelas | Cartela A2 | Placa | polígono | ver vértices | 1 | 8 | 8 | 8407.56 | 4 caras × capas por cara
Cartelas | Cartela A3 | Placa | polígono | ver vértices | 1 | 8 | 8 | 8306.4 | 4 caras × capas por cara
Cartelas | Cartela A4 | Placa | polígono | ver vértices | 1 | 8 | 8 | 8306.4 | 4 caras × capas por cara
Cartelas | Cartela A5 | Placa | polígono | ver vértices | 1 | 8 | 8 | 8407.56 | 4 caras × capas por cara
Cartelas | Cartela A6 | Placa | polígono | ver vértices | 1 | 4 | 4 | 4203.78 | 4 caras × capas por cara
Cartelas | Cartela A7 | Placa | polígono | ver vértices | 1 | 4 | 4 | 2491.7 | 4 caras × capas por cara
Cartelas | Cartela U1 | Placa | polígono | ver vértices | 1 | 4 | 4 | 3392.48 | 4 caras × capas por cara
Cartelas | Cartela U2 | Placa | polígono | ver vértices | 1 | 8 | 8 | 9305.96 | 4 caras × capas por cara
Cartelas | Cartela U3 | Placa | polígono | ver vértices | 1 | 8 | 8 | 9305.96 | 4 caras × capas por cara
Cartelas | Cartela U4 | Placa | polígono | ver vértices | 1 | 8 | 8 | 9220 | 4 caras × capas por cara
Cartelas | Cartela U5 | Placa | polígono | ver vértices | 1 | 8 | 8 | 9305.96 | 4 caras × capas por cara
Cartelas | Cartela U6 | Placa | polígono | ver vértices | 1 | 8 | 8 | 9305.96 | 4 caras × capas por cara
Cartelas | Cartela U7 | Placa | polígono | ver vértices | 1 | 4 | 4 | 3392.48 | 4 caras × capas por cara
Vigas de piso | VP0 base | T15x6 | 48.0 | 100.0 | 1 | 1 | 1 | 4800
Vigas de piso | VP1 base | T15x6 | 48.0 | 100.0 | 1 | 1 | 1 | 4800
Vigas de piso | VP2 base | T15x6 | 48.0 | 100.0 | 1 | 1 | 1 | 4800
Vigas de piso | VP2 cubrejunta 1 | T15x6 | 48.0 | 85.0 | 1 | 1 | 1 | 4080 | Centrada sobre la base; laminar antes de plegar
Vigas de piso | VP2 cubrejunta 2 | T15x6 | 48.0 | 60.0 | 1 | 1 | 1 | 2880 | Centrada sobre la base; laminar antes de plegar
Vigas de piso | VP2 cubrejunta 3 | T15x6 | 48.0 | 35.0 | 1 | 1 | 1 | 1680 | Centrada sobre la base; laminar antes de plegar
Vigas de piso | VP3 base | T15x6 | 48.0 | 100.0 | 1 | 1 | 1 | 4800
Vigas de piso | VP3 cubrejunta 1 | T15x6 | 48.0 | 85.0 | 1 | 1 | 1 | 4080 | Centrada sobre la base; laminar antes de plegar
Vigas de piso | VP3 cubrejunta 2 | T15x6 | 48.0 | 60.0 | 1 | 1 | 1 | 2880 | Centrada sobre la base; laminar antes de plegar
Vigas de piso | VP3 cubrejunta 3 | T15x6 | 48.0 | 35.0 | 1 | 1 | 1 | 1680 | Centrada sobre la base; laminar antes de plegar
Vigas de piso | VP4 base | T15x6 | 48.0 | 100.0 | 1 | 1 | 1 | 4800
Vigas de piso | VP4 cubrejunta 1 | T15x6 | 48.0 | 85.0 | 1 | 1 | 1 | 4080 | Centrada sobre la base; laminar antes de plegar
Vigas de piso | VP4 cubrejunta 2 | T15x6 | 48.0 | 60.0 | 1 | 1 | 1 | 2880 | Centrada sobre la base; laminar antes de plegar
Vigas de piso | VP4 cubrejunta 3 | T15x6 | 48.0 | 35.0 | 1 | 1 | 1 | 1680 | Centrada sobre la base; laminar antes de plegar
Vigas de piso | VP5 base | T15x6 | 48.0 | 100.0 | 1 | 1 | 1 | 4800
Vigas de piso | VP5 cubrejunta 1 | T15x6 | 48.0 | 85.0 | 1 | 1 | 1 | 4080 | Centrada sobre la base; laminar antes de plegar
Vigas de piso | VP5 cubrejunta 2 | T15x6 | 48.0 | 60.0 | 1 | 1 | 1 | 2880 | Centrada sobre la base; laminar antes de plegar
Vigas de piso | VP5 cubrejunta 3 | T15x6 | 48.0 | 35.0 | 1 | 1 | 1 | 1680 | Centrada sobre la base; laminar antes de plegar
Vigas de piso | VP6 base | T15x6 | 48.0 | 100.0 | 1 | 1 | 1 | 4800
Vigas de piso | VP7 base | T15x6 | 48.0 | 100.0 | 1 | 1 | 1 | 4800
Puntales de techo | Puntales PS1–PS7 | T6x6 | 29.0 | 90.0 | 1 | 7 | 7 | 18270
Arriostre de techo | Tiras en X de techo | B4 | 4.0 | 130.1 | 1 | 12 | 12 | 6246.642618
Pórticos | Tiras en X de pórticos | B4 | 4.0 | 176.2 | 1 | 4 | 4 | 2819.134619
Placas de techo | Placas GT | PLACA | 30.0 | 24.4 | 1 | 14 | 14 | 10264.8
Área total de cartón (mm²) |  |  |  |  |  |  |  | 500895.7335

Sheet: Sensibilidad
Sensibilidad de la carga de colapso predicha (mismo diseño)
Calculada en Python con el modelo de Supuestos; valores fijos. Relación resistencia/peso = P / masa de Resumen.
Escenario | P colapso (kgf) | Rige | Resistencia/peso (kgf/kg) | Nota
η = 0.60 | 18.62 | CS2 | 182.6702952 | Laminación mala en compresión
η = 0.70 | 19.78 | CS5 | 194.0503995
η = 0.85 (base) | 21.53 | CS5 | 211.2186603 | Caso de diseño
η = 1.00 | 21.79 | CI4 | 213.7693734
Solo 2018-19 | 20.07 | CS5 | 196.8954256
Solo 2022 I | 21.71 | DW2 | 212.9845386
Solo 2022 II | 15.66 | CI4 | 153.6314083 | Semestre más débil: tensión 1.4–2.7 kgf
Dimensionamiento para distintas cargas objetivo (misma geometría; resultado de optimización en Python)
Carga objetivo (kgf) | P real (kgf) | Masa (g) | Resistencia/peso (kgf/kg) | Lectura
10 | 10.77 | 71.9 | 149.7913769 | Ligero
14 | 14.86 | 94.2 | 157.7494692
17 | 17.83 | 100.8 | 176.8849206 | Rige la cuerda inferior (tensión)
19 | 21.53 | 104.8 | 205.4389313 | Elegido: máximo local de resistencia/peso (rige la cuerda superior en compresión)
23 | 24.21 | 140.8 | 171.9460227 | Más masa y menor relación
28 | 29.05 | 141.2 | 205.7365439 | Relación parecida a la de 19, con piezas de 3–4 capas y poca confianza
Masas de esta tabla usan vigas de piso con 4 capas completas y cartelas de la regla provisional; la masa de Resumen usa cubrejuntas escalonadas.
