adrianix360/Proyecto_mecanica_del_solido_2/04_despiece_corte_cameo/dxf/T04_v02.dxf

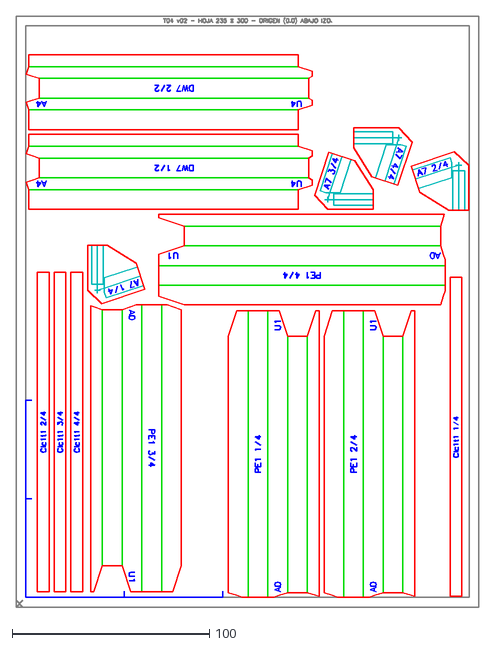
[picture p40: CAD file, 2026-11-03]
04_despiece_corte_cameo/dxf/T04_v02.dxf
235.0 x 300.0
