adrianix360/Proyecto_mecanica_del_solido_2/(list of files, cad)

Other CAD files:
03_planos_de_montaje/dxf/WA-04_v02.dxf
03_planos_de_montaje/dxf/WA-03_v02.dxf
03_planos_de_montaje/dxf/WA-05_v02.dxf
03_planos_de_montaje/dxf/WA-01_v02.dxf
03_planos_de_montaje/dxf/WA-02_v02.dxf
