adrianix360/Proyecto_mecanica_del_solido_2/03_planos_de_montaje/pdf/WA-02_v02.pdf

# WARREN - DESPIECE PARA CAMEO (1 de 2) - TAPETES A 1:1

## 01 LEYENDA (colores del DXF de la Cameo)

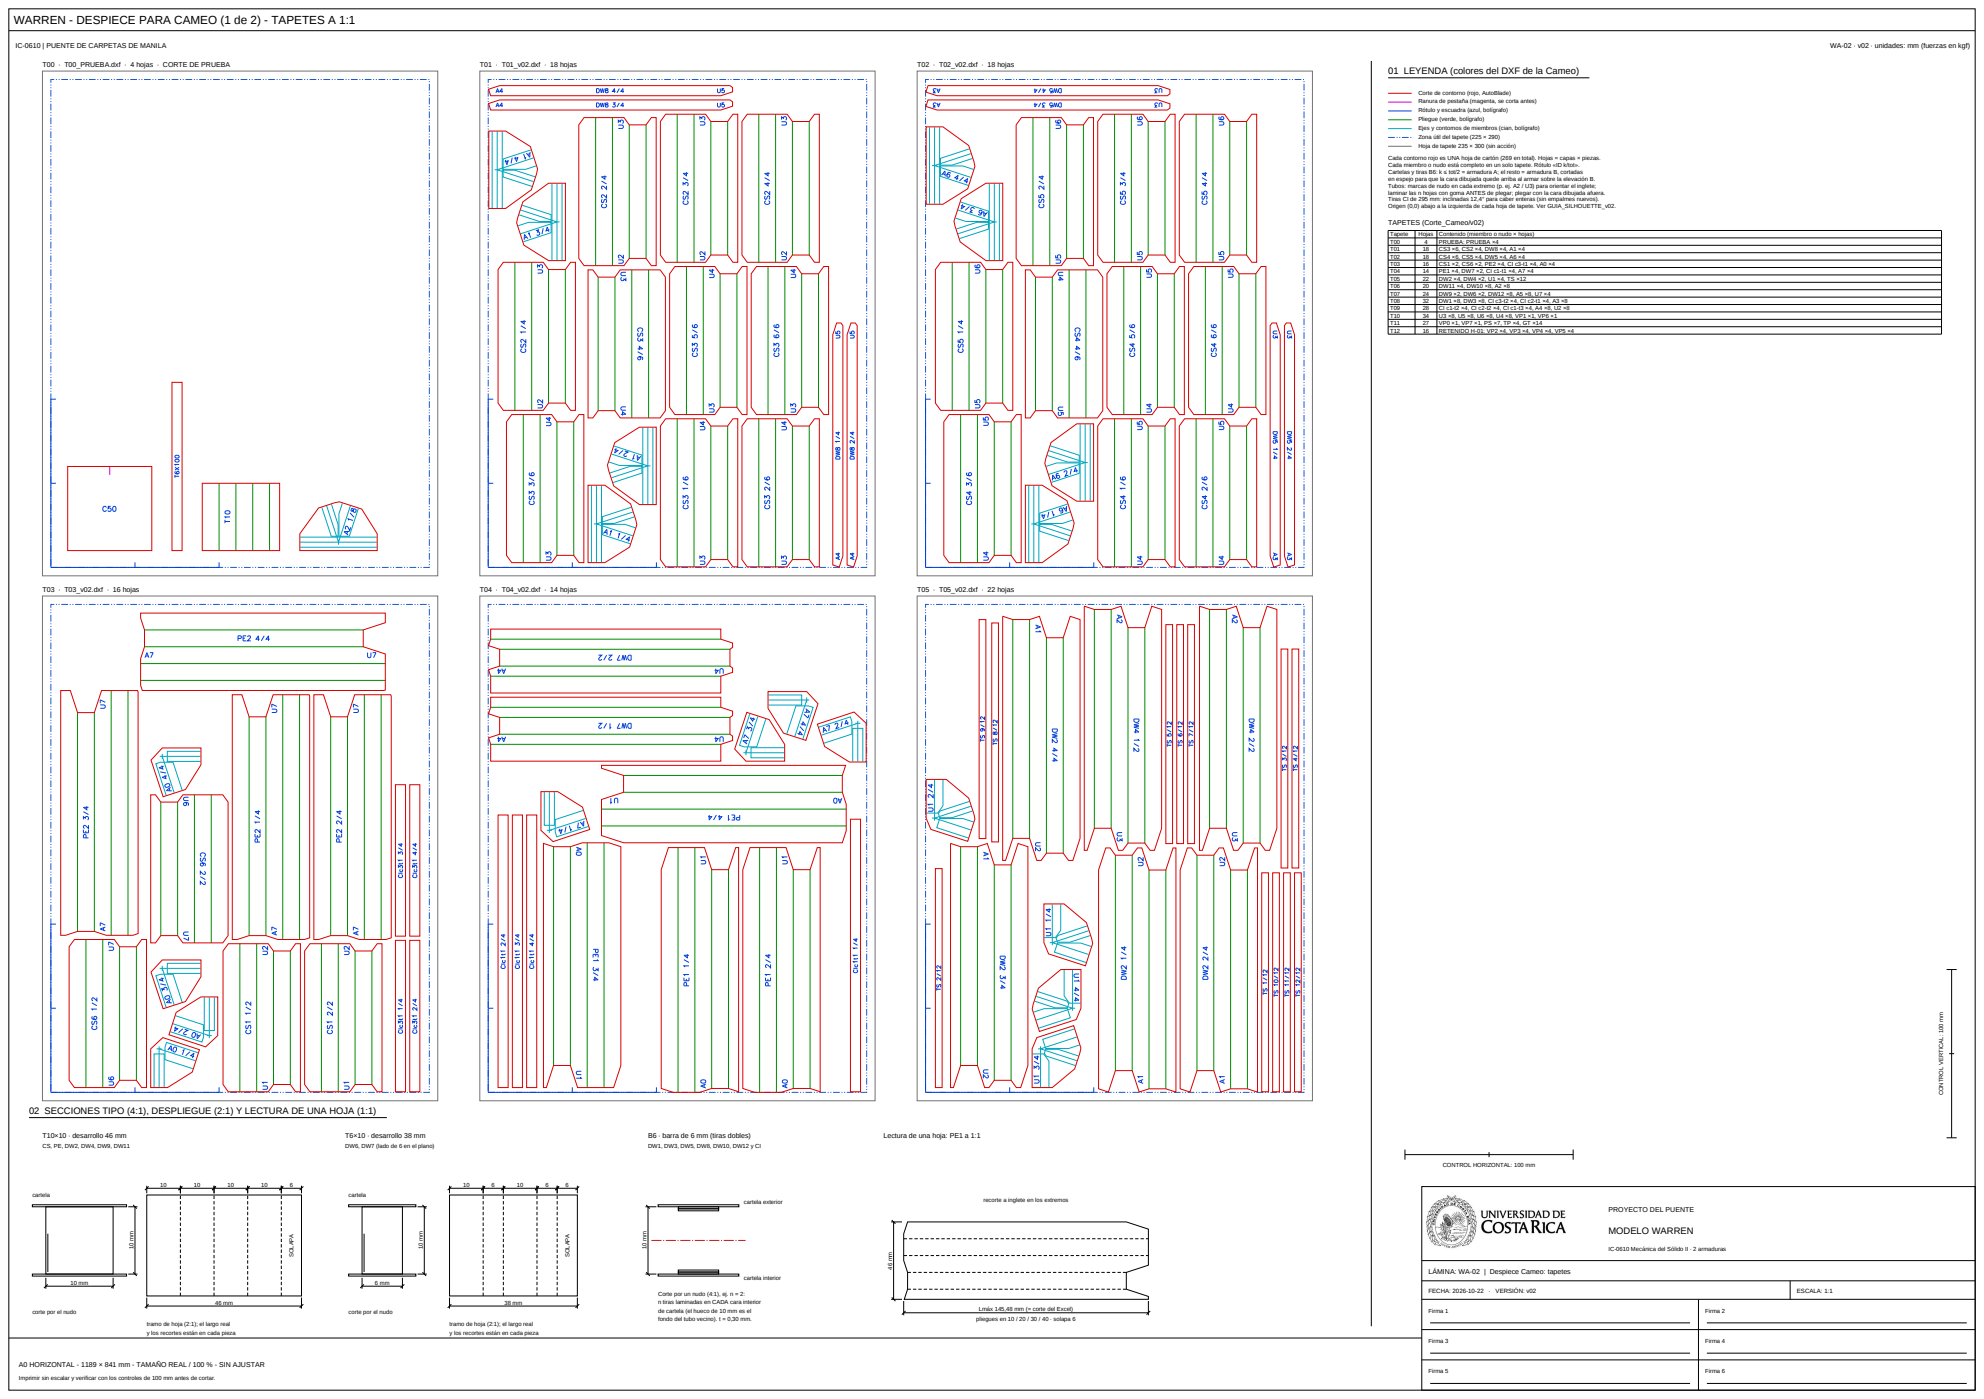
[picture p51: page 1]
IC-0610 | PUENTE DE CARPETAS DE MANILA; WA-02 · v02 · unidades: mm (fuerzas en kgf); MODELO WARREN; FECHA: 2026-10-22 · VERSIÓN: v02; ESCALA: 1:1; Firma 1; Firma 2; Firma 3; Firma 4; Firma 5; Firma 6; T00 · T00_PRUEBA.dxf · 4 hojas · CORTE DE PRUEBA; T01 · T01_v02.dxf · 18 hojas; T02 · T02_v02.dxf · 18 hojas; T03 · T03_v02.dxf · 16 hojas; T04 · T04_v02.dxf · 14 hojas; T05 · T05_v02.dxf · 22 hojas; T10×10 · desarrollo 46 mm; cartela; SOLAPA; T6×10 · desarrollo 38 mm; cartela exterior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

Corte de contorno (rojo, AutoBlade)
Ranura de pestaña (magenta, se corta antes)
Rótulo y escuadra (azul, bolígrafo)
Pliegue (verde, bolígrafo)
Ejes y contornos de miembros (cian, bolígrafo)
Zona útil del tapete (225 × 290)
Hoja de tapete 235 × 300 (sin acción)

Cada contorno rojo es UNA hoja de cartón (269 en total). Hojas = capas × piezas.
Cada miembro o nudo está completo en un solo tapete. Rótulo «ID k/tot».
Cartelas y tiras B6: k ≤ tot/2 = armadura A; el resto = armadura B, cortadas
en espejo para que la cara dibujada quede arriba al armar sobre la elevación B.
Tubos: marcas de nudo en cada extremo (p. ej. A2 / U3) para orientar el inglete;
laminar las n hojas con goma ANTES de plegar; plegar con la cara dibujada afuera.
Tiras CI de 295 mm: inclinadas 12,4° para caber enteras (sin empalmes nuevos).
Origen (0,0) abajo a la izquierda de cada hoja de tapete. Ver GUIA_SILHOUETTE_v02.

Tapete | Hojas | Contenido (miembro o nudo × hojas)
T00 | 4 | PRUEBA: PRUEBA ×4
T01 | 18 | CS3 ×6, CS2 ×4, DW8 ×4, A1 ×4
T02 | 18 | CS4 ×6, CS5 ×4, DW5 ×4, A6 ×4
T03 | 16 | CS1 ×2, CS6 ×2, PE2 ×4, CI c3-t1 ×4, A0 ×4
T04 | 14 | PE1 ×4, DW7 ×2, CI c1-t1 ×4, A7 ×4
T05 | 22 | DW2 ×4, DW4 ×2, U1 ×4, TS ×12
T06 | 20 | DW11 ×4, DW10 ×8, A2 ×8
T07 | 24 | DW9 ×2, DW6 ×2, DW12 ×8, A5 ×8, U7 ×4
T08 | 32 | DW1 ×8, DW3 ×8, CI c3-t2 ×4, CI c2-t1 ×4, A3 ×8
T09 | 28 | CI c1-t2 ×4, CI c2-t2 ×4, CI c1-t3 ×4, A4 ×8, U2 ×8
T10 | 34 | U3 ×8, U5 ×8, U6 ×8, U4 ×8, VP1 ×1, VP6 ×1
T11 | 27 | VP0 ×1, VP7 ×1, PS ×7, TP ×4, GT ×14
T12 | 16 | RETENIDO H-01: VP2 ×4, VP3 ×4, VP4 ×4, VP5 ×4

CONTROL VERTICAL: 100 mm

02 SECCIONES TIPO (4:1), DESPLIEGUE (2:1) Y LECTURA DE UNA HOJA (1:1)

B6 · barra de 6 mm (tiras dobles)

Lectura de una hoja: PE1 a 1:1

DW6, DW7 (lado de 6 en el plano)

CONTROL HORIZONTAL: 100 mm

recorte a inglete en los extremos

PROYECTO DEL PUENTE

IC-0610 Mecánica del Sólido II · 2 armaduras

LÁMINA: WA-02 | Despiece Cameo: tapetes

Corte por un nudo (4:1), ej. n = 2:
n tiras laminadas en CADA cara interior
de cartela (el hueco de 10 mm es el
fondo del tubo vecino). t = 0,30 mm.

Lmáx 145,48 mm (= corte del Excel)
pliegues en 10 / 20 / 30 / 40 · solapa 6

corte por el nudo

tramo de hoja (2:1); el largo real
y los recortes están en cada pieza

A0 HORIZONTAL - 1189 × 841 mm - TAMAÑO REAL / 100 % - SIN AJUSTAR

Imprimir sin escalar y verificar con los controles de 100 mm antes de cortar.
