adrianix360/Proyecto_mecanica_del_solido_2/05_guia_montaje_3d/README.md

# 05 · Guía de montaje 3D

La guía interactiva está publicada en **https://adrianix360.github.io/Proyecto_mecanica_del_solido_2/** y su archivo es [`../docs/index.html`](../docs/index.html).

- `QA_guia_v02.md`: informe de verificación (15 de 15 comprobaciones de consistencia y pruebas automáticas de navegador).
- `capturas/`: imágenes de pantalla de las distintas secciones.
