adrianix360/Proyecto_mecanica_del_solido_2/03_planos_de_montaje/vista_previa/WA-03_v02.png

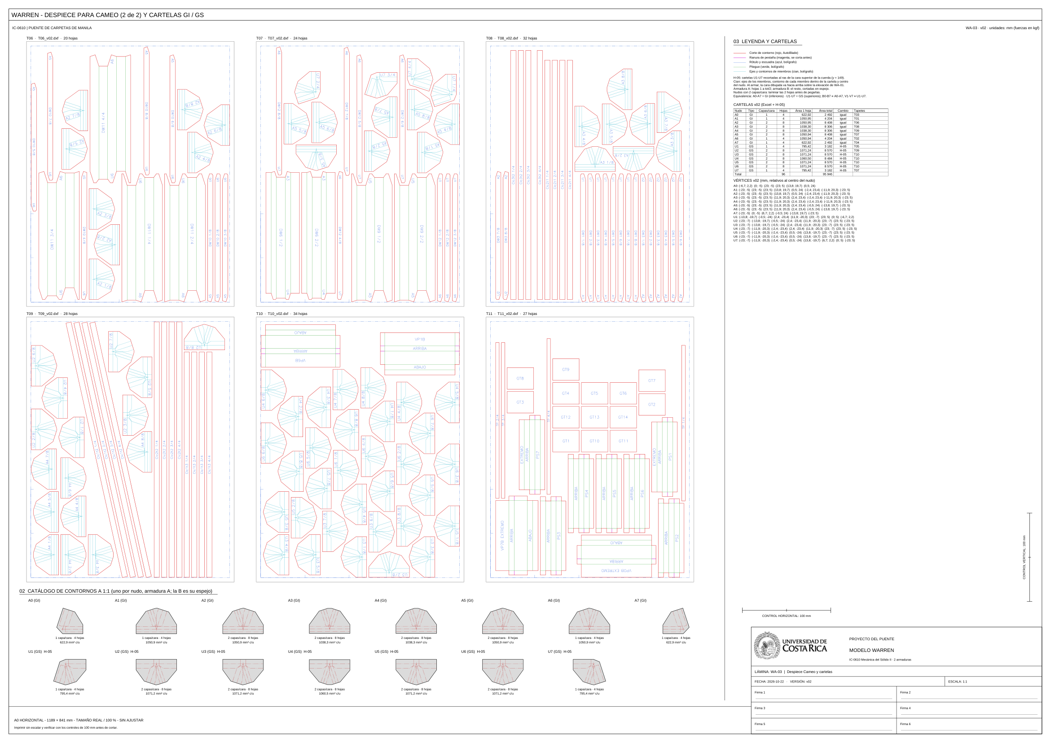
03_planos_de_montaje/vista_previa/WA-03_v02.png
