adrianix360/Proyecto_mecanica_del_solido_2/05_guia_montaje_3d/capturas/02_mis_bolsas.png

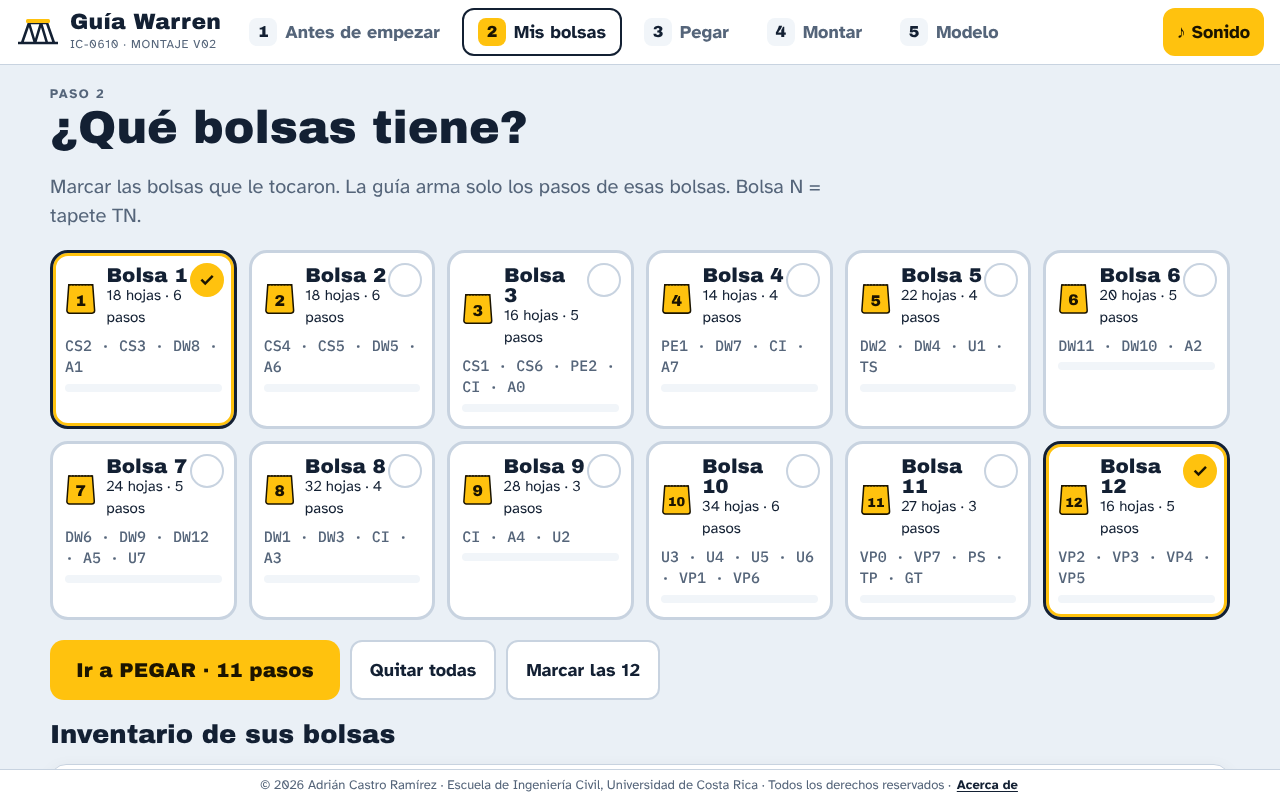
05_guia_montaje_3d/capturas/02_mis_bolsas.png
