adrianix360/Proyecto_mecanica_del_solido_2/05_guia_montaje_3d/capturas/15_pegar_revisar_bolsa5.png

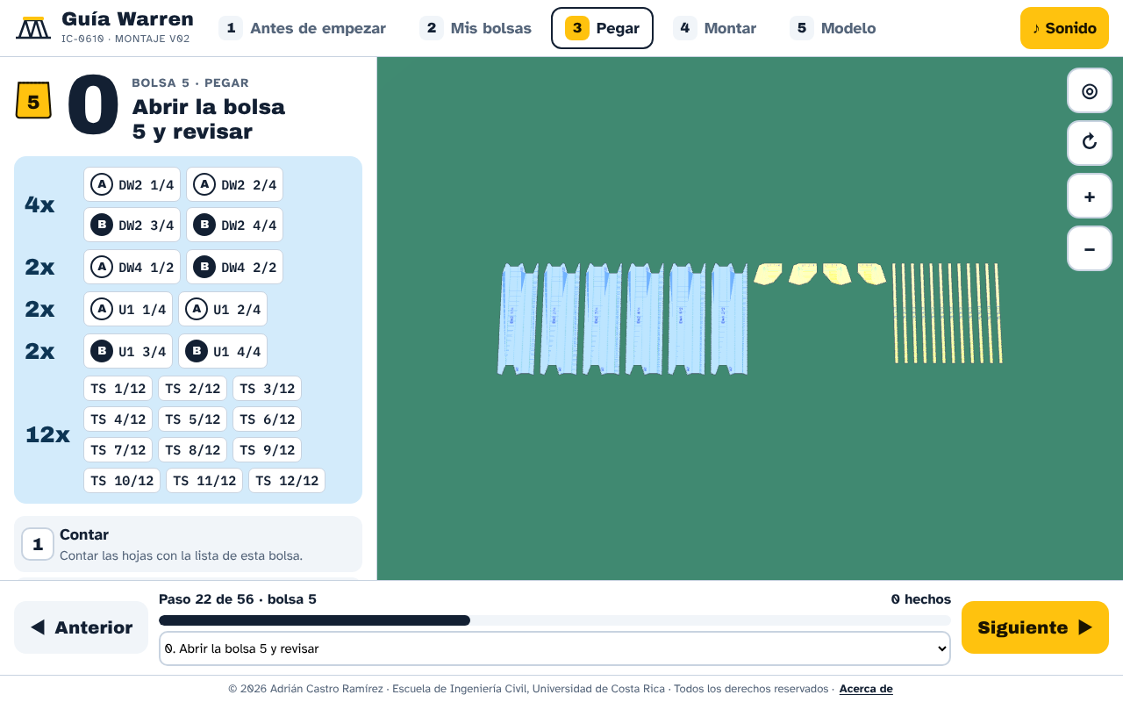
05_guia_montaje_3d/capturas/15_pegar_revisar_bolsa5.png
