adrianix360/Proyecto_mecanica_del_solido_2/05_guia_montaje_3d/capturas/24_montar_M15_volteo.png

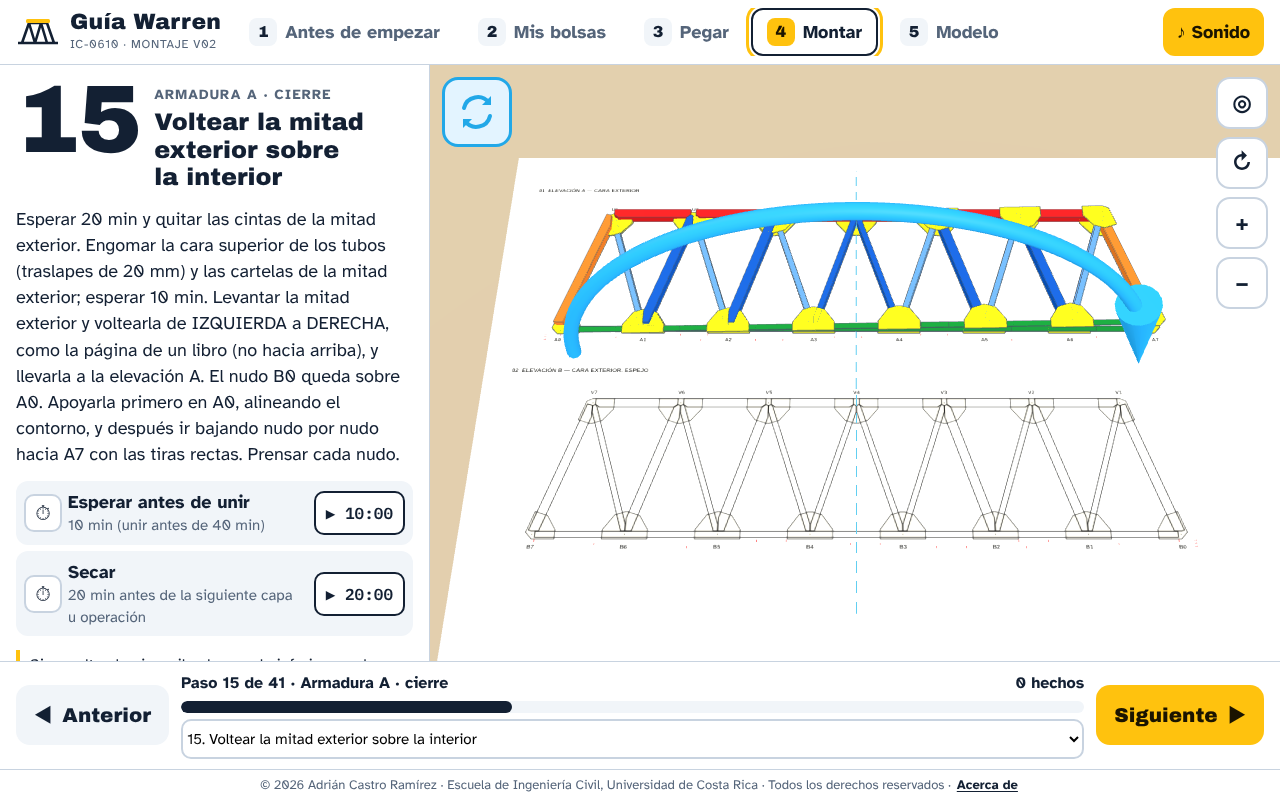
05_guia_montaje_3d/capturas/24_montar_M15_volteo.png
