adrianix360/Proyecto_mecanica_del_solido_2/05_guia_montaje_3d/capturas/32_montar_M41_final.png

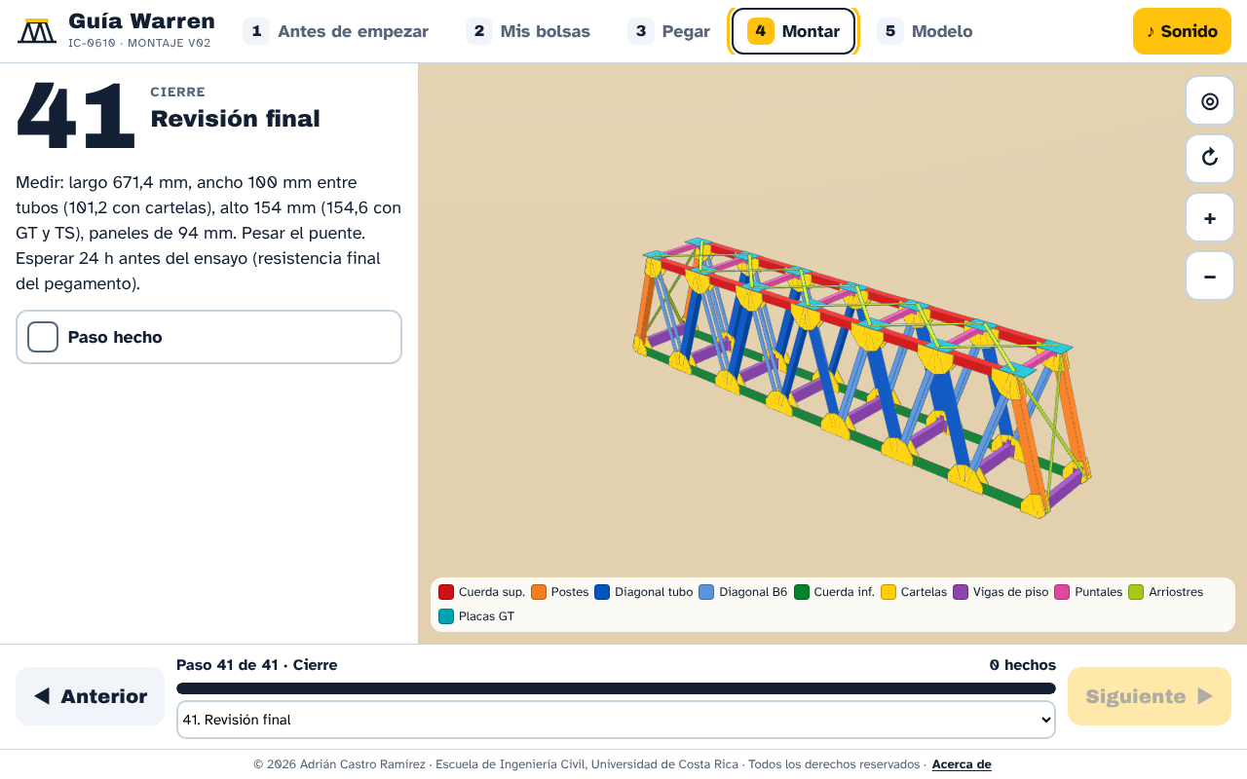
05_guia_montaje_3d/capturas/32_montar_M41_final.png
