adrianix360/Proyecto_mecanica_del_solido_2/05_guia_montaje_3d/capturas/58_telefono_modelo_ficha.png

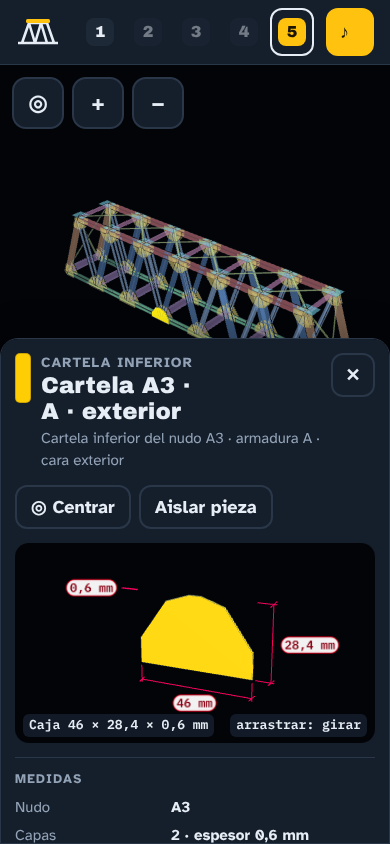
05_guia_montaje_3d/capturas/58_telefono_modelo_ficha.png
