adrianix360/Proyecto_mecanica_del_solido_2/06_revision_de_diseno/Verificacion_v01.xlsx

Sheet: Leeme
Verificación independiente del diseño del puente Warren (IC-0610) - revisión v01, 20-oct-2026
Revisor: Claude (instancia independiente del autor). Solo reporta; no modifica archivos originales.
Fuentes: Especificacion_Puente_Warren.xlsx (mtime 2026-10-19 18:38), enunciado 2026 I, datos de probetas (Datos/), Planos_montaje/v01, Claude Doc, diagrama de montaje y Cronograma.
Convención de colores: azul = dato de entrada (copiado de una fuente o de una salida de script, con su origen); negro = fórmula; verde = enlace a otra hoja.
Los valores de entrada que vienen de cálculos propios salen de los scripts en Revision_diseno/v01/scripts (r01 a r10), con sus salidas en /salidas.
Hojas: Requisitos · Hallazgos · Conocidos · Consultas · Parametros · Fuerzas · Capacidades · P_miembros · Verif_locales · MonteCarlo · Fuentes · Planos_QA · Probetas

Sheet: Requisitos
Requisitos del enunciado (2026 I - Proyecto del Puente IC-0610) vs diseño
ID | Requisito (cita literal) | Dato del diseño | Estado | Margen | Evidencia
REQ-01 | «Los estudiantes podrán construir un puente utilizando cualquiera de los tipos de armadura que se describen en la página 1-4 de la Referencia» (§3.4) | Warren trapezoidal sin montantes (Ressler p. 1-4: «Warren») | Cumple | — | Excel Resumen; WA-01
REQ-02 | «…modelo de puente tipo armadura elaborado con cartón de carpetas de manila para archivo y goma blanca» (§1) | Carpeta de manila + goma para madera/blanca en todas las uniones y laminados | Cumple | — | WA-02 leyenda; WA-05 secuencia
REQ-03 | «Se recomienda limitarse a los materiales listados» (§3.2: carpetas, tijera, martillo, alfileres, regla, cuchilla, bolígrafo, papel mantequilla, tabla, goma para madera, prensas) | WA-02 pide «marcar con punzón»; MEMORIA §4.3 cita «cemento de contacto» (Ressler) | Cumple con observación | — | WA-02 leyenda; MEMORIA línea 108 (ver H-14)
REQ-04 | «Longitud: 700 ± 50 mm» (§3.4) | 671,4 mm total con cartelas (658 entre ejes de apoyo) | Cumple | 21,4 mm al mínimo (8 mm si se mide entre apoyos) | Excel Nudos!B23; r07 dimensiones
REQ-05 | «Ancho: 100 ± 10 mm» (§3.4) | 100 mm entre caras exteriores de tubos; 101,2 mm con cartelas de 2 capas | Cumple | 8,8 mm al máximo | Excel Supuestos!B18; r07
REQ-06 | «Altura: 150 ± 10 mm» (§3.4) | 156 mm con cartelas; 156,6 con GT y TS; 144 entre ejes de cuerdas | Cumple | 3,4 mm al máximo (156,6); 4 mm al mínimo si se mide entre ejes | Excel Nudos!B24; WA-01 vista 05
REQ-07 | «Paneles de la cuerda inferior: 100 mm ± 10 mm de longitud» (§3.4) | p = 94 mm, fijado por la plantilla 1:1 (no por medición en obra) | Cumple con margen menor a 5 mm | 4 mm al mínimo | Excel Supuestos!B4
REQ-08 | «Vigas de piso: secciones tipo tubo de 15 mm × 6 mm (vigas transversales a nivel de cuerda inferior…)» (§3.4) | 8 VP T15×6, cara inferior en y = −3 (al ras de la cuerda inferior) | Cumple | — | Excel Secciones; WA-04; WA-05 det. 04
REQ-09 | «La condición de carga… se describe en la siguiente figura» (Figura 2: cuatro cargas P/4) | P/4 en VP2–VP5 (A2–A5). Ensayo real (dato de Adrián): tabla apoyada en las 4 vigas y cargada al centro | Cumple el esquema; el modelo de reparto no | — | Excel Nudos D7:D10; ver H-01
REQ-10 | «Los y las estudiantes deben buscar predecir la carga P de colapso» (§3.4) | P = 21,5 kgf (media de ensayos, FS = 1) | Cumple (calidad en duda) | — | Excel Resumen!B5; ver H-03
REQ-11 | «Se recomienda enfáticamente la confección de las uniones entre elementos tal como se describe en los ejemplos de la referencia» (§3.4) | Cartelas en las dos caras de cada nudo (96 hojas) | Cumple | — | Excel Cartelas; WA-03
REQ-12 | «…la inclusión de elementos estabilizadores para cargas fuera del plano tales como diafragmas u otros refuerzos» (§3.4) | 7 puntales PS, 12 tiras TS en X, 2 pórticos TP, 14 placas GT | Cumple con observación | — | WA-01 vistas 04-05; ver H-05
REQ-13 | «La capacidad de los elementos… podrá estimarse a partir de los datos recopilados en el laboratorio y de los datos obtenidos en semestres anteriores» (§3.4) | Medias ponderadas de 2018-19, 2022 I, 2022 II y 2023 I | Cumple con observación | — | Excel Supuestos B22:E29; ver H-04
REQ-14 | «Los elementos en tensión y en compresión… consistirán respectivamente de secciones tipo barra y tipo cajón» (§3.3) | Tensión: barras B6; compresión: tubos T10×10/T6×10; DW6-DW7 (fuerza 0) en cajón | Cumple | — | Excel Miembros M5:M31
REQ-15 | «Cálculo de las fuerzas internas… Mediante cálculos manuales y software sugeridos en clase» (§3.5, nota ***) | Solver Python; SAP2000 (A-08) y verificación manual (A-09) pendientes | No verificable | — | Cronograma A-08, A-09
REQ-16 | «El trabajo se hará en grupos de 4 o 5 estudiantes» (§3.1) | Grupo de 6 (Cronograma D-11) | No cumple (administrativo) | 1 integrante | Cronograma D-11; ver H-15
REQ-17 | «Calidad constructiva del puente (10pts)» (§3.5) | Depende de la fabricación | No verificable | — | —
REQ-18 | «(10 %) Si la diferencia entre la resistencia calculada y la experimental es menor a 20%» (§3.5) | Probabilidad estimada de quedar dentro de ±20 % con 21,5 kgf: 0–24 % | En riesgo | — | r06_montecarlo; ver H-03

Sheet: Hallazgos
Hallazgos de la revisión (ordenados por severidad)
ID | Severidad | Confianza | Dónde | Qué dice | Qué debería decir y por qué | Evidencia numérica | Impacto | Corrección sugerida (no aplicada)
H-01 | Alta | Probable | Excel Vigas_y_arriostres!B4:E6 y Resumen!B7; documento §Elementos transversales; WA-04 | El límite de la viga de piso (23,69 kgf) supone P/4 puntual en el centro de cada una de las 4 vigas y luz de 90 mm. | Con el método real de carga (tabla apoyada en VP2-VP5 y cargada al centro), la tabla es mucho más rígida que el puente: al flexionarse la armadura, la tabla se queda apoyada en VP2 y VP5, que reciben cada una P/2. | Solver propio con tabla rígida (r08): reacciones A2 = A5 = 0,575, A3 = A4 = −0,075 (despegue). Viga con 4 capas (M = 133,26 kgf·mm): carga puntual P/2 → P_lím = 8·M/L = 11,8 kgf (L = 90) o 13,5 kgf (L = 78,8). Repartida en un ancho de tabla b (con L = 78,8): P_lím = 4·M/(L/2 − b/4) = 18,1 (b = 40), 21,9 (b = 60), 24,3 kgf (b = 70). | La viga de piso VP2/VP5 puede pasar a regir entre 12 y 24 kgf, según el ancho de la tabla. Los miembros que rigen la armadura (CS2/5, PE, DW1-3, DW10-12) no cambian su fuerza: CS3/CS4 y CI4 bajan 26 %. Pegado de las pestañas de VP2/VP5: cortante P/4 = 5,4 kgf frente a 7,2 kgf (uso 0,75). | Pedir a la profesora el ancho, el espesor y la longitud de la tabla (C-08). Rehacer el chequeo de vigas con P/2 en VP2 y VP5, carga repartida en el ancho real. Reforzar VP2 y VP5 (más capas en el centro o cubrejuntas más largas) hasta que su P_lím ≥ 1,2 × P de la armadura. Comprobar en P-06 una viga reforzada a flexión.
H-02 | Alta | Confirmado (geometría) / Probable (falla) | Excel Cartelas_vertices A0 y A7 (y = −5); WA-05 det. 03; WA-01 | El puente apoya en placas planas (dato de Adrián: unos 7 cm a cada lado). Los puntos más bajos son los cantos de las cartelas A0/A7 (y = −5); la cuerda inferior y VP0 quedan 2 mm más arriba (y = −3). | La reacción entra por un canto de cartón de 0,3 mm, sin respaldo en esos 2 mm, y su centro queda 11,5 mm hacia adentro del eje de A0. Ninguna fuente lo verifica ni lo detalla. | A P = 21,5: reacción por armadura 5,38 kgf sobre 2 × 0,3 × 23 = 13,8 mm² → 0,39 kgf/mm² (3,8 MPa), es decir 24 % de la resistencia a tensión por área de una tira (1,66 kgf/mm²). El aplastamiento de un canto suelto no está ensayado. Con una placa de 70 mm desde el extremo (borde ≈ x = 63), la cartela A1 (desde x = 71) queda a 7,7 mm de tocarla. | Riesgo de aplastamiento local o de rotación en el apoyo antes de la carga predicha. Si el puente se coloca 8 mm más adentro, la reacción se reparte entre A0 y A1 y cambian las fuerzas de PE y DW1-DW2. | Agregar un apoyo propio en cada extremo: un taco o zapata laminada bajo la cuerda inferior entre x ≈ −6,7 y 60, al nivel y = −5, o una viga de extremo en L como la AA' de Ressler (28 × 13 mm). Marcar en el plano la posición del puente sobre la placa. Confirmar con la profesora las placas y la condición fijo/móvil (C-09).
H-03 | Alta | Probable | Excel Resumen!B5 (21,52 kgf); documento §Predicción; Cronograma A-20 | La predicción usa la media de los ensayos y FS = 1, y el diseño está «balanceado»: con barras dobles, 10 miembros por armadura (20 en el puente) fallan entre 21,5 y 23,9 kgf; con la regla del Excel (n tiras) son 17 por armadura (hoja P_miembros, filas «dentro de +10 %»). | El puente falla en el miembro más débil de muchos con resistencia dispersa (CV ≈ 30-40 %), así que su colapso esperado queda claramente por debajo del valor calculado con medias. La rúbrica da 10 puntos solo si el error es < 20 %. | Montecarlo con remuestreo de 502 ensayos válidos (r06, η = 0,85): miembros independientes → mediana 12,4 kgf (P10 8,0; P90 13,8); correlación por semestre → mediana 15,1 kgf (P10 10,2; P90 22,3). Probabilidad de quedar dentro de ±20 % con 21,5: 0 % y 24 %. En el ejemplo del curso: predicción 5,06 y falla real 6,77 kgf (diseño no balanceado). | Error de predicción probable de 30-45 % (pierde 5 de 10 puntos) aunque el puente esté bien hecho. | En el Informe de Avance, presentar la predicción con corrección por eslabón débil (por ejemplo, la mediana del Montecarlo correlado, ≈ 15 kgf) y un rango, o calibrarla con ensayos propios (P-06). Mantener 21,5 kgf como «resistencia media de miembros» y no como predicción.
H-04 | Media | Confirmado | MEMORIA_PROYECTO_PUENTE.md §5.1-5.2; Excel Supuestos!B23:D23 y B28:E29 (medias ponderadas) | MEMORIA toma el máximo bruto de cada .lvm: cuenta t4-1 (2022 II) como 1,582 kgf y no descuenta la línea base en t6-1 (1,49 kgf), c10x10x6-2 (−1,50), C2-10-10-10-3 (−0,78), c6x10x20-2 (−0,88) ni C8-6-10-20-1 (−0,39). | t4-1 es una señal plana (1,5804 a 1,5821 kgf en todo el archivo): no hubo ensayo y debe excluirse. Los picos deben medirse respecto a la línea base. t6-1 y c6x10x20-2 son ambiguos y conviene excluirlos con su motivo (criterio D-04). | r01 (picos con tara) y r02 (re-cálculo): C1 de 6 mm = 2,985 kgf (Excel 2,963); de 8 mm = 4,216 (Excel 4,396); 10×10 de 100 mm = 3,747 (Excel 3,710); 10×10 de 160 mm = 3,032 (Excel 2,998). Con las capacidades re-calculadas, P = 21,78 kgf (rigen CS2/CS5). | Bajo en P (< 2 %), pero la sección «Propiedades de diseño de miembros» (9 puntos) y la lista de exclusiones D-04 quedarían con datos incorrectos. | Re-procesar los .lvm con tara (script r01) y excluir t4-1, t6-1 y c6x10x20-2 con su motivo. Actualizar las medias en Supuestos y en la MEMORIA, y citar el procedimiento en el informe.
H-05 | Alta | Confirmado (geometría) / Probable (efecto) | Excel Cartelas_vertices U1-U7 (y relativo = +7); WA-01 vista 04; WA-04 det. GT; WA-05 | En los nudos superiores, la cartela sobresale 2 mm por encima de la cara superior de la cuerda (y = 151 frente a 149). Por eso la GT queda en y = 151 y solo se apoya en los cantos de 0,3-0,6 mm de las cartelas y en la tapa del puntal. | El arriostre de techo (TS → GT → armadura) es lo que justifica tomar la cuerda superior como arriostrada en cada nudo (L = 94 fuera del plano). La unión GT-cuerda debe pegarse en una cara, no en cantos. | Área de pegado GT-armadura: unos 2 × 30 × 0,6 = 36 mm² de canto más ≈ 80 mm² de tapa de PS (6 × 13,2), frente a 30 × 10 = 300 mm² si la GT apoyara en la cara de la cuerda. Si las cartelas U se recortan al ras (y rel. = +5), la altura total pasa a 154 mm (154,6 con GT y TS), todavía dentro de 140-160. | Arriostramiento fuera del plano poco confiable: puede provocar pandeo lateral de la cuerda superior (no modelado) antes de 21,5 kgf. | Recortar las cartelas U1-U7 al ras de la cara superior de la cuerda (cambiar +7 por +5 en Cartelas_vertices). Pegar la GT sobre la cuerda y el puntal, y regenerar WA-01, WA-03 y WA-04. Revisar con el grupo si la altura de 154 sigue siendo la deseada (D-19).
H-06 | Media | Probable | WA-02 (tubos de 2 y 3 capas: CS2-CS5, PE, DW2, DW11); Excel Secciones (desarrollo único 46/38 mm) | Todas las capas de un tubo se cortan con el mismo desarrollo (46 mm) y las mismas marcas, se laminan planas y luego se pliegan. | Al plegar un laminado de 0,6-0,9 mm, cada capa exterior necesita más desarrollo que la interior (≈ +4 × π/2 × t ≈ +1,9 mm por capa con t = 0,30). Con capas iguales, las interiores se arrugan en las esquinas, la solapa se acorta y la sección exterior pasa de 10 mm. El factor η = 0,85 supone un laminado sano. | CS3/CS4: 3 capas = 0,9 mm de pared en un tubo de 10 mm. Ningún ensayo de los datos históricos tiene más de 1 capa. | Riesgo de piezas mal plegadas y de menor capacidad en los miembros que rigen (CS2/CS5). | Antes de cortar en serie, fabricar en P-06 un CS3 de 3 capas y un PE de 2 capas. Si se arrugan, usar desarrollos por capa (46 / 47,9 / 49,8 mm, de adentro hacia afuera) o tubos anidados. Medir su sección y ensayarlos si es posible.
H-07 | Media | Confirmado | Documento «Especificación final del puente Warren» (Claude Doc): §Cuerda inferior, §Elementos transversales, §Decisiones por confirmar | Dice que las tiras de la cuerda inferior van «apiladas y pegadas entre sí en el plano medio, entre las cartelas», que la VP sale de una «hoja base de 48 × 100 mm», que el PS mide «29 × 90… entre los planos medios», que la capacidad de las barras es C = n × C1 y que siguen «por confirmar» la tira máxima, la posición de la VP y las GT. | Los planos v01 usan barras dobles (n tiras en cada cara interior de cartela), VP de 88,8/89,4 mm y PS de 88,8/89,4 mm con pestañas, extremos a inglete y GT ubicadas (D-16 a D-19). | Comparación entre fuentes (hoja «Fuentes» de Verificacion_v01.xlsx). | Quien corte o redacte con el documento obtendrá piezas o textos distintos de los planos. | Actualizar el documento con D-14 a D-19 o marcarlo como «superado por Planos_montaje v01» en las secciones afectadas.
H-08 | Media | Confirmado | Cronograma §5, P-06 («solape de 24 mm»), y §9, R-09 | La prueba de fabricación P-06 propone ensayar un empalme de la cuerda inferior con solape de 24 mm (del plano base, tiras de 4 mm). | El diseño usa tiras de 6 mm con traslape de 30 mm, laminadas en pilas por cara. Además, el documento recomienda ensayar tubos de 2-3 capas, un nudo con cartela y una viga de piso reforzada, y esos ensayos no están en el Cronograma. | Excel Supuestos!B10 = 30; Cuerda_inferior; documento §Ensayos recomendados. | P-06 validaría un detalle que no se va a construir y dejaría sin probar los supuestos que rigen (η, τ, κ). | Reescribir P-06: empalme de tiras de 6 mm con traslape de 30 mm, CS3 de 3 capas a compresión, nudo con cartela a tracción, VP2 reforzada a flexión y apoyo A0 (H-02).
H-09 | Media | Confirmado | Planos v01 (WA-02, WA-04) frente a Excel Miembros!O5:O31, Lista_de_corte y Resumen | Las barras dobles suman 37 184 mm² (≈ 7,6 g) sin aumentar P: rige la compresión (21,5-21,8 kgf) y las barras en tensión pasan a P ≥ 43 kgf. | Es una decisión discutible (Observación): el grupo prioriza el bono de resistencia/peso (D-05). La alternativa es poner n tiras en total, repartidas entre las dos caras (⌈n/2⌉ y ⌊n/2⌋), o una sola tira por cara en los miembros de n = 1, con P de tensión ≈ 22 kgf (igual que el Excel). | Masa 101,9 → 105,5 g; resistencia/peso 211 → 204 (con P = 21,5). | −3,5 % en la relación resistencia/peso, sin ganancia de resistencia. | Decidirlo en grupo. Si se mantiene, documentar que la cuerda inferior queda con reserva ≥ 2×.
H-10 | Baja | Confirmado | Excel Cartelas!I4:I18 («Fuerza máx. de miembro»), D4:D18; documento §Cartelas (regla g) | La columna «Fuerza máx. de miembro (kgf)» contiene las capacidades de los miembros (Miembros!S), no fuerzas. Las capas por cara (D) están escritas a mano y la regla g = ⌈1,25·F/(2·0,49·8)⌉ no explica sus constantes. | Rotular «Capacidad máx. de miembro que llega al nudo (kgf)» y calcular g con una fórmula enlazada a S y a τ, para que se actualice si cambian las capas. | Por ejemplo, U3: 10,25 kgf = Miembros!S14 (capacidad de CS3). | Confusión al redactar; las cartelas no se actualizan solas. | Corregir el rótulo y enlazar D con una fórmula. Documentar el origen de 0,49 y de 8.
H-11 | Baja | Confirmado | Excel Vigas_y_arriostres!B6:E6 (luz = Supuestos!B6 = 90) | El límite de la viga usa la luz entre planos medios (90 mm) y una carga puntual. | La luz libre de los planos es 78,8 mm; con la misma hipótesis de carga, P_lím = 27,1 kgf (+14 %). Queda superado por H-01. | r07 viga_piso. | Conservador; sin efecto si se corrige H-01. | Usar la luz libre y la carga real (H-01).
H-12 | Baja | Confirmado | Excel Miembros!R5:R31 (interpolación con la columna I = largo de eje) | La capacidad a compresión se interpola con el largo de eje (94 / 151,48 mm). | La longitud libre entre cartelas es menor (≈ 48 / 105 mm) y los extremos están restringidos por las cartelas, así que el criterio es conservador. Conviene declararlo en el informe. | Cartelas de 46 mm de ancho en x y 20 mm de traslape por miembro. | Ninguno en seguridad; explica parte de la diferencia con un ensayo real. | Documentarlo como supuesto en «Propiedades de diseño».
H-13 | Baja | Confirmado | Artefacto «Diagrama de montaje del puente Warren» y Planos_montaje/Manual de montaje.pdf (impresión del diagrama; título de metadatos «Datos de falla de probetas - Claude») | Dibuja VP de 100 mm centrada en el eje inferior, PS de 90, barras B6 × n en el plano medio y miembros sin inglete; dice que las GT no se dibujan y lista como pendientes temas ya decididos. | Adrián confirmó que el grupo no lo usará para construir (solo referencia). Aun así, está guardado dentro de Planos_montaje. | Comparación entre fuentes. | Bajo (por confirmación del usuario). | Mover el manual a una subcarpeta «referencia_superada» o marcarlo como «no usar para cortar»; actualizar el título de sus metadatos.
H-14 | Baja | Confirmado | WA-02 leyenda («marcar con punzón»); MEMORIA §4.3 («cola con cemento de contacto») | Se mencionan un punzón y cemento de contacto, que no están en la lista de materiales recomendados del enunciado (§3.2). | Usar alfiler o bolígrafo sin tinta para marcar pliegues y goma para madera en todas las uniones. La lista del enunciado es una recomendación. | Enunciado §3.2. | Ninguno estructural; evita observaciones de la profesora. | Cambiar «punzón» por «alfiler o bolígrafo sin tinta» en WA-02 y aclarar en la MEMORIA que se usa solo goma.
H-15 | Media | Por verificar | Cronograma D-11 (grupo de 6); enunciado §3.1 y §3.3 | El grupo tiene 6 integrantes. | El enunciado dice «El trabajo se hará en grupos de 4 o 5 estudiantes» y «La conformación de los grupos… de entre cuatro y cinco integrantes, se realizará en clase». Si la profesora lo autorizó en clase, no hay problema, pero no hay registro. | Cita literal del enunciado. | Administrativo; no afecta el diseño. | Confirmar por escrito con la profesora (C-11) y anotarlo como decisión en el Cronograma.
H-16 | Baja | Confirmado | Cronograma §1 (panel de estado y «Próxima acción») y D-09 | Todas las fases figuran al 0 % y la próxima acción es «F0 y F1 hoy lunes 19 oct». D-09 dice que el dibujo se hace en AutoCAD, pero los planos v01 se generan con Python a DXF/PDF. | Actualizar el panel y aclarar D-09 (los DXF se abren en AutoCAD). | Cronograma v0.3. | Ninguno técnico. | Actualizar en la próxima sesión de planeamiento.
Conteo
Crítica
Alta
Media
Baja

Sheet: Conocidos
Puntos ya conocidos por el autor: confirmación e impacto
Ítem | Punto | Confirmación (evidencia) | Impacto
(a) | Área Excel 500 896 mm² frente a 518 666 mm² del plano; masa 101,9 frente a 105,5 g | Confirmado: Lista_de_corte!I72 = 500 895,73; planos 518 666 (QA_v01). Diferencia +17 771 mm² (+3,5 %, +3,6 g) = barras dobles +37 184 − ingletes 12 989 − VP/PS más cortas 6 424 mm² (QA_v01 cuadre). | Media: la masa y la relación resistencia/peso del informe (211) bajan a 204. No cambia P.
(b) | Tira máxima de 300 mm en Supuestos y 320 mm en los planos | Confirmado: Supuestos!B12 = 300; la pieza más larga de los planos mide 295,0 mm (r04). | Ninguno: todas las tiras cumplen ambos límites.
(c) | Sensibilidad dice 21,53 kgf/CS5 y Resumen 21,52/CS2 | Confirmado: valor fijo en Sensibilidad!B6 (21,53, rige CS5 en C6) frente a la fórmula Resumen!B5 (21,519). CS2 y CS5 son simétricos. | Ninguno (redondeo).
(d) | El empalme de la capa 2 cae en CI4 | Confirmado: Cuerda_inferior capa 2, traslape 305-335 en CI4. | Bajo ahora: con barras dobles cada tira lleva 1,46 kgf a P = 21,5 y el traslape resiste 7,2 kgf (uso 0,20). Con la tabla rígida (H-01), CI4 baja 26 %.
(e) | El Cronograma aún describe H = 140, panel de 100 y cargas a 200/300/400/500 (D-06, D-13, S-04, S-06) | Confirmado en Cronograma §3.1-3.2 y en el Anexo B. D-14 a D-19 ya registran la geometría nueva, pero D-06 no se corrigió. | Media para el informe (Descripción de la geometría): riesgo de citar cotas viejas.
(f) | η, κ, τ y t son supuestos sin ensayo | Confirmado. Sensibilidad del Excel: η = 0,60 → 18,6 kgf. κ no rige si se corrige H-01. τ: los usos de pegado calculados son ≤ 0,72 con τ = 0,04. t solo afecta luces libres (±0,1 mm) y la masa. | Alta en conjunto con H-03 y H-06: la predicción descansa en η sin ningún ensayo de tubos laminados.

Sheet: Consultas
Consultas propuestas a la profesora (las envía solo Adrián)
ID | Consulta
C-08 | Dimensiones (ancho, largo y espesor) y material de la tabla de carga que se apoya en las 4 vigas de piso. ¿Se apoya directamente sobre las vigas o con algún elemento que reparta la carga? ¿Se permite nivelar o calzar las vigas?
C-09 | Placas de apoyo: largo exacto (¿70 mm?), ancho, y si un extremo es fijo y el otro móvil. ¿Se permite un taco o zapata de cartón en los extremos de la cuerda inferior?
C-10 | ¿Cómo se miden la longitud (total o entre apoyos) y la altura (total con cartelas y techo o entre ejes)? Relacionado con S-06 y D-19.
C-11 | Confirmar que el grupo de 6 integrantes está autorizado (el enunciado indica grupos de 4 o 5).
Orden
1 | H-01 (vigas de piso con el método de carga real): enviar C-08 y redimensionar VP2/VP5 antes de cortar las vigas.
2 | H-02 (apoyos): diseñar el taco o zapata de extremo y marcar la posición sobre la placa; enviar C-09.
3 | H-05 (GT sin apoyo en la cuerda): recortar las cartelas U al ras y regenerar WA-01, WA-03 y WA-04 como v02.
4 | H-03 y H-04 (predicción y datos) para el Informe de Avance del viernes: re-procesar ensayos y presentar la predicción con su rango.
5 | H-06 y H-08 (P-06): probar un CS3 de 3 capas, el empalme de 30 mm, el nudo, la VP reforzada y el apoyo antes del corte en serie.
6 | Actualizar el Excel (conocido (a) y H-10/H-11), el documento (H-07) y el Cronograma (H-08, H-16, conocido (e)) y luego regenerar los planos v02.
7 | Se puede cortar ya, sin esperar: tubos CS, PE y DW (tras la prueba de H-06), tiras CI y DW B6, PS, TS, TP y GT. No cortar todavía: VP2-VP5 (H-01), cartelas U1-U7 (H-05) ni piezas de apoyo (H-02).

Sheet: Parametros
Parámetros de entrada (azul) con su origen
Parámetro | Valor | Unidad | Origen
P de colapso del Excel | 21.51915467 | kgf | Excel Resumen!B5
η (eficiencia de capas en compresión) | 0.85 | — | Excel Supuestos!B13
τ (cortante de goma) | 0.04 | kgf/mm² | Excel Supuestos!B16
t (espesor de hoja, sin medir) | 0.3 | mm | Planos v01 PARAM t_hoja (Adrián: aún no medido)
M de viga de piso con 4 capas | 133.258125 | kgf·mm | Excel Vigas_y_arriostres!E5
Luz de viga en el Excel | 90 | mm | Excel Supuestos!B6
Luz libre de viga en los planos | 78.8 | mm | Planos v01 WA-04 (VP2-VP5)
Traslape miembro-cartela | 20 | mm | Excel Cartelas!H (20 mm)
Factor de inglete (peor caso) | 0.82 | — | QA_v01 aviso (DW4 en A2)
Largo del canto de apoyo (cartela A0) | 23 | mm | Excel Cartelas_vertices A0 (x 0 a 23 en y = −5)
Capas por cara en A0 | 1 | — | Excel Cartelas!D4
Capas por cara en U3 | 2 | — | Excel Cartelas!D13
Alto de la sección de cartela U3 en x = 0 | 30.899 | mm | Excel Cartelas_vertices U3 (de −24 a +7)
Resistencia a tensión de una tira de 6 mm (media propia) | 2.984563415 | kgf | r02_capacidades.json
Área de cartón Excel | 500895.7335 | mm² | Excel Lista_de_corte!I72
Área de cartón planos v01 | 518666 | mm² | Planos_montaje/v01/QA_v01.json
Gramaje (supuesto) | 185 | g/m² | Excel Supuestos!B14
Goma (fracción del peso) | 0.1 | — | Excel Supuestos!B15

Sheet: Capacidades
Capacidades de una capa: re-cálculo propio (r02) vs Excel
Ensayo | n | Media propia (kgf) | Desv. est. | CV | Excel (kgf) | Diferencia | Origen Excel
Tensión 4 mm | 35 | 1.826 | 0.625 |  | 1.819 |  | Supuestos!B23
Tensión 6 mm | 41 | 2.985 | 1.148 |  | 2.963 |  | Supuestos!C23
Tensión 8 mm | 40 | 4.216 | 1.787 |  | 4.396 |  | Supuestos!D23
Tubo 10x10 × 50 mm | 37 | 4.542 | 1.571 |  | 4.442 |  | Supuestos!B28
Tubo 10x10 × 100 mm | 54 | 3.747 | 1.234 |  | 3.710 |  | Supuestos!C28
Tubo 10x10 × 160 mm | 52 | 3.032 | 1.139 |  | 2.998 |  | Supuestos!D28
Tubo 10x10 × 200 mm | 53 | 2.792 | 0.983 |  | 2.779 |  | Supuestos!E28
Tubo 6x10 × 50 mm | 40 | 3.880 | 1.444 |  | 3.754 |  | Supuestos!B29
Tubo 6x10 × 100 mm | 50 | 3.490 | 1.207 |  | 3.451 |  | Supuestos!C29
Tubo 6x10 × 160 mm | 49 | 2.593 | 0.983 |  | 2.593 |  | Supuestos!D29
Tubo 6x10 × 200 mm | 51 | 2.536 | 0.987 |  | 2.492 |  | Supuestos!E29

Sheet: Fuerzas
Fuerzas por kgf aplicado a UNA armadura (P/4 en A2-A5): solver propio (r03) vs Excel
ID | Nudo i | Nudo j | Largo de eje (mm) | F propia | F Excel | Diferencia | ¿Coincide (≤0,001)?
CI1 | A0 | A1 | 94.000 | 0.1632 | 0.163
CI2 | A1 | A2 | 94.000 | 0.4896 | 0.490
CI3 | A2 | A3 | 94.000 | 0.7344 | 0.734
CI4 | A3 | A4 | 94.000 | 0.8160 | 0.816
CI5 | A4 | A5 | 94.000 | 0.7344 | 0.734
CI6 | A5 | A6 | 94.000 | 0.4896 | 0.490
CI7 | A6 | A7 | 94.000 | 0.1632 | 0.163
CS1 | U1 | U2 | 94.000 | -0.3264 | -0.326
CS2 | U2 | U3 | 94.000 | -0.6528 | -0.653
CS3 | U3 | U4 | 94.000 | -0.8160 | -0.816
CS4 | U4 | U5 | 94.000 | -0.8160 | -0.816
CS5 | U5 | U6 | 94.000 | -0.6528 | -0.653
CS6 | U6 | U7 | 94.000 | -0.3264 | -0.326
PE1 | A0 | U1 | 151.476 | -0.5260 | -0.526
PE2 | A7 | U7 | 151.476 | -0.5260 | -0.526
DW1 | U1 | A1 | 151.476 | 0.5260 | 0.526
DW2 | A1 | U2 | 151.476 | -0.5260 | -0.526
DW3 | U2 | A2 | 151.476 | 0.5260 | 0.526
DW4 | A2 | U3 | 151.476 | -0.2630 | -0.263
DW5 | U3 | A3 | 151.476 | 0.2630 | 0.263
DW6 | A3 | U4 | 151.476 | 0.0000 | 0.000
DW7 | U4 | A4 | 151.476 | 0.0000 | 0.000
DW8 | A4 | U5 | 151.476 | 0.2630 | 0.263
DW9 | U5 | A5 | 151.476 | -0.2630 | -0.263
DW10 | A5 | U6 | 151.476 | 0.5260 | 0.526
DW11 | U6 | A6 | 151.476 | -0.5260 | -0.526
DW12 | A6 | U7 | 151.476 | 0.5260 | 0.526
Isostaticidad: m + r = 2j |  |  | 27 | 3 | 15
Reacciones (por kgf en una armadura) |  |  | A0 | 0.5 | A7 | 0.5
Coincidencias

Sheet: P_miembros
P de colapso del puente por miembro = 2 × capacidad / |F| (capacidades propias)
ID | Sección | Capas n | Largo (mm) | F | C1 (kgf) | Cap. regla Excel (n) | Cap. planos (barras dobles) | P regla Excel | P planos | P Excel (Miembros!T)
CI1 | B6 | 1 |  |  |  |  |  |  |  | 36.36
CI2 | B6 | 2 |  |  |  |  |  |  |  | 24.19
CI3 | B6 | 3 |  |  |  |  |  |  |  | 24.22
CI4 | B6 | 3 |  |  |  |  |  |  |  | 21.79
CI5 | B6 | 3 |  |  |  |  |  |  |  | 24.22
CI6 | B6 | 2 |  |  |  |  |  |  |  | 24.19
CI7 | B6 | 1 |  |  |  |  |  |  |  | 36.36
CS1 | T10x10 | 1 |  |  |  |  |  |  |  | 23.30
CS2 | T10x10 | 2 |  |  |  |  |  |  |  | 21.52
CS3 | T10x10 | 3 |  |  |  |  |  |  |  | 25.13
CS4 | T10x10 | 3 |  |  |  |  |  |  |  | 25.13
CS5 | T10x10 | 2 |  |  |  |  |  |  |  | 21.52
CS6 | T10x10 | 1 |  |  |  |  |  |  |  | 23.30
PE1 | T10x10 | 2 |  |  |  |  |  |  |  | 21.80
PE2 | T10x10 | 2 |  |  |  |  |  |  |  | 21.80
DW1 | B6 | 2 |  |  |  |  |  |  |  | 22.53
DW2 | T10x10 | 2 |  |  |  |  |  |  |  | 21.80
DW3 | B6 | 2 |  |  |  |  |  |  |  | 22.53
DW4 | T10x10 | 1 |  |  |  |  |  |  |  | 23.57
DW5 | B6 | 1 |  |  |  |  |  |  |  | 22.53
DW6 | T6x10 | 1
DW7 | T6x10 | 1
DW8 | B6 | 1 |  |  |  |  |  |  |  | 22.53
DW9 | T10x10 | 1 |  |  |  |  |  |  |  | 23.57
DW10 | B6 | 2 |  |  |  |  |  |  |  | 22.53
DW11 | T10x10 | 2 |  |  |  |  |  |  |  | 21.80
DW12 | B6 | 2 |  |  |  |  |  |  |  | 22.53
Mínimo
Rige
Miembros dentro de +10 % del mínimo (planos, por armadura)
Miembros dentro de +10 % del mínimo (regla Excel, por armadura)

Sheet: Verif_locales
Verificaciones locales a la carga predicha (fórmulas)
Verificación | Valor | Unidad | Fórmula / nota
APOYO (H-02)
Reacción por armadura a P |  | kgf | P/2 por armadura, mitad en cada apoyo
Área de canto (2 caras × g × t × largo) |  | mm² | Cartela A0, canto inferior en y = −5
Esfuerzo de aplastamiento en el canto |  | kgf/mm²
Resistencia a tensión por área de una tira de 6 mm |  | kgf/mm² | Referencia: no hay ensayo de aplastamiento de canto
Razón aplastamiento / tensión |  | —
PEGADO MIEMBRO-CARTELA (traslape 20 mm, dos caras)
CS3: uso = F / (τ · 2 · 10 · 20 · factor de inglete) |  | — | F = |F| × P/2; ancho en el plano 10 mm
CS2: uso = F / (τ · 2 · 10 · 20 · factor de inglete) |  | — | F = |F| × P/2; ancho en el plano 10 mm
PE1: uso = F / (τ · 2 · 10 · 20 · factor de inglete) |  | — | F = |F| × P/2; ancho en el plano 10 mm
DW2: uso = F / (τ · 2 · 10 · 20 · factor de inglete) |  | — | F = |F| × P/2; ancho en el plano 10 mm
DW1: uso = F / (τ · 2 · 6 · 20 · factor de inglete) |  | — | F = |F| × P/2; ancho en el plano 6 mm
CARTELA U3 (la cuerda superior es discontinua en cada nudo)
Fuerza de CS3 a P |  | kgf
Área de cartelas en x = 0 (2 caras × g × t × alto) |  | mm²
Esfuerzo medio / resistencia a tensión de referencia |  | — | Compresión del cartón no ensayada
VIGAS DE PISO CON TABLA RÍGIDA (H-01)
Reparto en A2 (fracción de la carga de una armadura), tabla rígida | 0.575 | — | r08: resultado del solver (A3 y A4 negativos → despegan)
P_lím Excel: P/4 puntual, L = 90 |  | kgf | igual a Excel Resumen!B7
P_lím: P/2 puntual en VP2, L = 90 |  | kgf | La tabla se apoya solo en VP2 y VP5
P_lím: P/2 puntual en VP2, L = 78,8 |  | kgf
P_lím: P/2 repartida en ancho de tabla b = 40 mm, L = 78,8 |  | kgf | M = (P/4)(L/2 − b/4)
P_lím: P/2 repartida en ancho de tabla b = 60 mm, L = 78,8 |  | kgf | M = (P/4)(L/2 − b/4)
P_lím: P/2 repartida en ancho de tabla b = 70 mm, L = 78,8 |  | kgf | M = (P/4)(L/2 − b/4)
Pegado de pestañas de VP2: uso con P/2 (cortante P/4 por extremo) |  | — | Pestañas: superior 6×5 y dos laterales 15×5
EMPALME DE CUERDA INFERIOR EN CI4
Fuerza por tira (3+3 tiras) a P |  | kgf
Uso del traslape de 30 mm (6 × 30 × τ) |  | —
MASA Y RELACIÓN
Masa Excel |  | g
Masa planos v01 |  | g
Resistencia/peso Excel |  | kgf/kg
Resistencia/peso con masa de planos |  | kgf/kg

Sheet: MonteCarlo
Eslabón más débil: P de colapso simulado (r06, 4000 realizaciones, η = 0,85)
Modelo | Media | Mediana | P10 | P90 | Prob. |error| < 20 % con P del Excel | Error de la mediana vs P del Excel | Miembro que rige más veces
Miembros independientes | 11.36 | 12.36 | 8.00 | 13.82 | 0% |  | DW11 658, PE2 588, DW2 571, PE1 569
Correlación por semestre | 15.16 | 15.12 | 10.22 | 22.35 | 24.4% |  | DW11 1164, DW2 640, PE2 456, CS5 329
Remuestreo de los ensayos válidos (hoja Probetas). Barras: modelo de haz frágil (Daniels); tubos: C1 × (1 + η(n−1)). Una armadura falla con su miembro más débil; el puente, con la primera.

Sheet: Fuentes
Comparación entre fuentes (cualquier diferencia es un hallazgo o un punto conocido)
Dato | Excel | Documento (Claude Doc) | Diagrama (artefacto) | Planos v01 | Cronograma / Proyecto | ¿Coinciden? | Ref.
Panel p (mm) | 94 | 94 | 94 | 94 | 100 (D-13, A-06) | No | (e)
Altura H entre ejes (mm) | 144 | 144 | 144 | 144 | 140 (D-13, S-04) | No | (e)
Posición de cargas (x, mm) | 188/282/376/470 | A2-A5 | A2-A5 | A2-A5 | 200/300/400/500 (D-06) | No | (e)
Tira máxima (mm) | 300 | 300 | 300 | 320 | 320 (D-15) | No | (b)
Cuerda inferior: ubicación de tiras | plano medio (texto) | plano medio | plano medio | n tiras en cada cara interior | barras dobles (D-17) | No | H-07
Capacidad de barras | n × C1 | n × C1 | — | 2n × C1 (implícito) | D-17 | No | H-07/(a)
Viga de piso: hoja base (mm) | 48 × 100 | 48 × 100 | 100, centrada en el eje | 48 × 88,8 / 89,4 | D-18 | No | H-07, H-13
Viga de piso: altura | — | — | centrada en y = 0 | y = −3 a +12 | D-18 | No | H-13
Puntal PS (mm) | 29 × 90 | 29 × 90 | 90 | 29 × 88,8 / 89,4 | D-18 | No | H-07
Extremos de miembros | rectos (eje − 6) | rectos | rectos | inglete (Lmáx = eje − 6) | D-16 | No | H-07
Placas GT | 14 de 30 × 24,44 | 14, sin ubicar | sin ubicar | 2 por nudo U, en y = 151 | D-18 | No | H-05
Área de cartón (mm²) | 500896 | 500896 | — | 518666 | 518 666 (bitácora) | No | (a)
Masa (g) | 101.9 | 102 | — | 105.5 | ≈105,5 | No | (a)
P de colapso (kgf) | 21.52 | 21.5 | — | — | — | Sí | —
Sensibilidad η = 0,85 | 21,53 / CS5 | 21,5 / CS5 | — | — | — | No | (c)
Hojas de cartela | 96 | 96 | — | 96 | — | Sí | —
Altura total (mm) | 156 | 156 | 156 | 156 (156,6 con GT y TS) | 156 (D-19) | Sí | —
Largo total (mm) | 671.4 | 671.4 | 671.4 | 671.4 | — | Sí | —
Traslape de empalme CI (mm) | 30 | 30 | 30 | 30 | 24 (P-06) | No | H-08
Filas que no coinciden

Sheet: Planos_QA
Verificación independiente de los planos v01 (r04 DXF, r05 PDF-DXF)
Lámina | Hojas de carpeta | Piezas en zona útil | Fuera de zona | Solapes | Lado máx. (mm) | Área piezas (mm²) | Texto mín. (mm) | Página (mm) | Controles 100 mm | Vértices DXF en PDF
WA-01 | 0 | 0 | 0 | 0 | 0 | 0 | 2.5 | 1189.0 × 841.0 | 100.0, 100.0 | 0 de 0
WA-02 | 4 | 77 | 0 | 0 | 145.476 | 238805.7 | 2.5 | 1189.0 × 841.0 | 100.0, 100.0 | 1879 de 1879
WA-03 | 3 | 125 | 0 | 0 | 145.071 | 155013.8 | 2.5 | 1189.0 × 841.0 | 100.0, 100.0 | 1232 de 1232
WA-04 | 2 | 67 | 0 | 0 | 295 | 124847 | 2.5 | 1189.0 × 841.0 | 100.0, 100.0 | 494 de 494
WA-05 | 0 | 0 | 0 | 0 | 0 | 0 | 2.5 | 1189.0 × 841.0 | 100.0, 100.0, 100.0, 100.0 | 0 de 0
Total
Esperado (Excel + decisiones v01): 48 hojas de tubo + 40 tiras DW + 28 tiras CI + 96 cartelas + 20 VP/cubrejuntas + 7 PS + 12 TS + 4 TP + 14 GT = 269

Sheet: Probetas
Ensayos históricos re-leídos por el revisor (r02_probetas_todas.csv)
Semestre | Tipo | Ancho / sección | Largo (mm) | kgf | Fuente | Nota | Usado | Motivo
2019 II - G52 | T | 4 | 200 | 1.25 | 2019 II - G52!B4 |  | True
2019 II - G52 | T | 6 | 200 | 2 | 2019 II - G52!C4 |  | True
2019 II - G52 | T | 8 | 200 | 6.6 | 2019 II - G52!D4 |  | True
2019 II - G52 | C | 6x10 | 200 | 3.1 | 2019 II - G52!E4 |  | True
2019 II - G52 | C | 10x10 | 200 | 2.4 | 2019 II - G52!G4 |  | True
2019 II - G52 | C | 6x10 | 160 | 2.3 | 2019 II - G52!I4 |  | True
2019 II - G52 | C | 10x10 | 160 | 1.7 | 2019 II - G52!K4 |  | True
2019 II - G52 | C | 6x10 | 100 | 4.25 | 2019 II - G52!M4 |  | True
2019 II - G52 | C | 10x10 | 100 | 2.9 | 2019 II - G52!O4 |  | True
2019 II - G52 | C | 6x10 | 50 | 3 | 2019 II - G52!Q4 |  | True
2019 II - G52 | C | 10x10 | 50 | 2.8 | 2019 II - G52!S4 |  | True
2019 II - G52 | C | 6x10 | 200 | 3.1 | 2019 II - G52!E5 |  | True
2019 II - G52 | C | 10x10 | 200 | 2.8 | 2019 II - G52!G5 |  | True
2019 II - G52 | C | 6x10 | 160 | 1.9 | 2019 II - G52!I5 |  | True
2019 II - G52 | C | 10x10 | 160 | 2.9 | 2019 II - G52!K5 |  | True
2019 II - G52 | C | 6x10 | 100 | 3.8 | 2019 II - G52!M5 |  | True
2019 II - G52 | C | 10x10 | 100 | 2.8 | 2019 II - G52!O5 |  | True
2019 II - G52 | C | 6x10 | 50 | 3.6 | 2019 II - G52!Q5 |  | True
2019 II - G52 | C | 10x10 | 50 | 4.3 | 2019 II - G52!S5 |  | True
2019 II - G52 | T | 4 | 200 | 1.4 | 2019 II - G52!B6 |  | True
2019 II - G52 | T | 6 | 200 | 1.95 | 2019 II - G52!C6 |  | True
2019 II - G52 | T | 8 | 200 | 2.6 | 2019 II - G52!D6 |  | True
2019 II - G52 | C | 6x10 | 200 | 4.25 | 2019 II - G52!E6 |  | True
2019 II - G52 | C | 10x10 | 200 | 2.6 | 2019 II - G52!G6 |  | True
2019 II - G52 | C | 6x10 | 160 | 1.7 | 2019 II - G52!I6 |  | True
2019 II - G52 | C | 10x10 | 160 | 2.1 | 2019 II - G52!K6 |  | True
2019 II - G52 | C | 6x10 | 100 | 3.1 | 2019 II - G52!M6 |  | True
2019 II - G52 | C | 10x10 | 100 | 3.2 | 2019 II - G52!O6 |  | True
2019 II - G52 | C | 6x10 | 50 | 3.6 | 2019 II - G52!Q6 |  | True
2019 II - G52 | C | 10x10 | 50 | 4.1 | 2019 II - G52!S6 |  | True
2019 II - G52 | C | 6x10 | 200 | 3.4 | 2019 II - G52!E7 |  | True
2019 II - G52 | C | 10x10 | 200 | 3.1 | 2019 II - G52!G7 |  | True
2019 II - G52 | C | 6x10 | 160 | 2.2 | 2019 II - G52!I7 |  | True
2019 II - G52 | C | 10x10 | 160 | 2.1 | 2019 II - G52!K7 |  | True
2019 II - G52 | C | 6x10 | 100 | 3.2 | 2019 II - G52!M7 |  | True
2019 II - G52 | C | 10x10 | 100 | 2.2 | 2019 II - G52!O7 |  | True
2019 II - G52 | C | 6x10 | 50 | 3.4 | 2019 II - G52!Q7 |  | True
2019 II - G52 | C | 10x10 | 50 | 2.8 | 2019 II - G52!S7 |  | True
2019 II - G52 | T | 4 | 200 | 2 | 2019 II - G52!B8 |  | True
2019 II - G52 | T | 6 | 200 | 2.8 | 2019 II - G52!C8 |  | True
2019 II - G52 | T | 8 | 200 | 6.45 | 2019 II - G52!D8 |  | True
2019 II - G52 | C | 6x10 | 200 | 3 | 2019 II - G52!E8 |  | True
2019 II - G52 | C | 10x10 | 200 | 3.3 | 2019 II - G52!G8 |  | True
2019 II - G52 | C | 6x10 | 160 | 5 | 2019 II - G52!I8 |  | True
2019 II - G52 | C | 10x10 | 160 | 5.5 | 2019 II - G52!K8 |  | True
2019 II - G52 | C | 6x10 | 100 | 5.25 | 2019 II - G52!M8 |  | True
2019 II - G52 | C | 10x10 | 100 | 4.3 | 2019 II - G52!O8 |  | True
2019 II - G52 | C | 6x10 | 50 | 6 | 2019 II - G52!Q8 |  | True
2019 II - G52 | C | 10x10 | 50 | 6.25 | 2019 II - G52!S8 |  | True
2019 II - G52 | C | 6x10 | 200 | 2.55 | 2019 II - G52!E9 |  | True
2019 II - G52 | C | 10x10 | 200 | 2.75 | 2019 II - G52!G9 |  | True
2019 II - G52 | C | 6x10 | 160 | 3.6 | 2019 II - G52!I9 |  | True
2019 II - G52 | C | 10x10 | 160 | 3.7 | 2019 II - G52!K9 |  | True
2019 II - G52 | C | 6x10 | 100 | 4.2 | 2019 II - G52!M9 |  | True
2019 II - G52 | C | 10x10 | 100 | 5.5 | 2019 II - G52!O9 |  | True
2019 II - G52 | C | 6x10 | 50 | 5.4 | 2019 II - G52!Q9 |  | True
2019 II - G52 | C | 10x10 | 50 | 4 | 2019 II - G52!S9 |  | True
2019 II - G52 | T | 4 | 200 | 2 | 2019 II - G52!B10 |  | True
2019 II - G52 | T | 6 | 200 | 3.3 | 2019 II - G52!C10 |  | True
2019 II - G52 | T | 8 | 200 | 3.4 | 2019 II - G52!D10 |  | True
2019 II - G52 | C | 6x10 | 200 | 4.3 | 2019 II - G52!E10 |  | True
2019 II - G52 | C | 10x10 | 200 | 6 | 2019 II - G52!G10 |  | True
2019 II - G52 | C | 6x10 | 160 | 4 | 2019 II - G52!I10 |  | True
2019 II - G52 | C | 10x10 | 160 | 4.25 | 2019 II - G52!K10 |  | True
2019 II - G52 | C | 6x10 | 100 | 4.3 | 2019 II - G52!M10 |  | True
2019 II - G52 | C | 10x10 | 100 | 2.8 | 2019 II - G52!O10 |  | True
2019 II - G52 | C | 6x10 | 50 | 5 | 2019 II - G52!Q10 |  | True
2019 II - G52 | C | 10x10 | 50 | 7.25 | 2019 II - G52!S10 |  | True
2019 II - G52 | C | 6x10 | 200 | 5 | 2019 II - G52!E11 |  | True
2019 II - G52 | C | 10x10 | 200 | 5.8 | 2019 II - G52!G11 |  | True
2019 II - G52 | C | 6x10 | 160 | 4.25 | 2019 II - G52!I11 |  | True
2019 II - G52 | C | 10x10 | 160 | 5.5 | 2019 II - G52!K11 |  | True
2019 II - G52 | C | 6x10 | 100 | 4.25 | 2019 II - G52!M11 |  | True
2019 II - G52 | C | 10x10 | 100 | 4.25 | 2019 II - G52!O11 |  | True
2019 II - G52 | C | 6x10 | 50 | 4.75 | 2019 II - G52!Q11 |  | True
2019 II - G52 | C | 10x10 | 50 | 6.5 | 2019 II - G52!S11 |  | True
2019 II - G52 | T | 4 | 200 | 1.6 | 2019 II - G52!B12 |  | True
2019 II - G52 | T | 6 | 200 | 1.95 | 2019 II - G52!C12 |  | True
2019 II - G52 | T | 8 | 200 | 3.1 | 2019 II - G52!D12 |  | True
2019 II - G52 | C | 6x10 | 200 | 3.1 | 2019 II - G52!E12 |  | True
2019 II - G52 | C | 10x10 | 200 | 3.3 | 2019 II - G52!G12 |  | True
2019 II - G52 | C | 6x10 | 160 | 2.5 | 2019 II - G52!I12 |  | True
2019 II - G52 | C | 10x10 | 160 | 3.6 | 2019 II - G52!K12 |  | True
2019 II - G52 | C | 6x10 | 100 | 2.5 | 2019 II - G52!M12 |  | True
2019 II - G52 | C | 10x10 | 100 | 3 | 2019 II - G52!O12 |  | True
2019 II - G52 | C | 6x10 | 50 | 2.2 | 2019 II - G52!Q12 |  | True
2019 II - G52 | C | 10x10 | 50 | 3.5 | 2019 II - G52!S12 |  | True
2019 II - G52 | C | 6x10 | 200 | 2.5 | 2019 II - G52!E13 |  | True
2019 II - G52 | C | 10x10 | 200 | 2.3 | 2019 II - G52!G13 |  | True
2019 II - G52 | C | 6x10 | 160 | 2.6 | 2019 II - G52!I13 |  | True
2019 II - G52 | C | 10x10 | 160 | 3.5 | 2019 II - G52!K13 |  | True
2019 II - G52 | C | 6x10 | 100 | 2.5 | 2019 II - G52!M13 |  | True
2019 II - G52 | C | 10x10 | 100 | 2.4 | 2019 II - G52!O13 |  | True
2019 II - G52 | C | 6x10 | 50 | 3.6 | 2019 II - G52!Q13 |  | True
2019 II - G52 | C | 10x10 | 50 | 4 | 2019 II - G52!S13 |  | True
2019 I - G51 | T | 4 | 200 | 1.1 | 2019 I - G51!B4 |  | True
2019 I - G51 | T | 6 | 200 | 1.8 | 2019 I - G51!C4 |  | True
2019 I - G51 | T | 8 | 200 | 2.4 | 2019 I - G51!D4 |  | True
2019 I - G51 | C | 6x10 | 200 | 2.17 | 2019 I - G51!E4 | b | True
2019 I - G51 | C | 10x10 | 200 | 2.5 | 2019 I - G51!G4 | c | True
2019 I - G51 | C | 6x10 | 160 | 2 | 2019 I - G51!I4 | c | True
2019 I - G51 | C | 10x10 | 160 | 1.8 | 2019 I - G51!K4 | c | True
2019 I - G51 | C | 6x10 | 100 | 3.1 | 2019 I - G51!M4 |  | True
2019 I - G51 | C | 10x10 | 100 | 2.6 | 2019 I - G51!O4 | a | True
2019 I - G51 | C | 6x10 | 200 | 2.21 | 2019 I - G51!E5 | c | True
2019 I - G51 | C | 10x10 | 200 | 2.89 | 2019 I - G51!G5 | c | True
2019 I - G51 | C | 6x10 | 160 | 2.5 | 2019 I - G51!I5 | b | True
2019 I - G51 | C | 10x10 | 160 | 2.6 | 2019 I - G51!K5 | c | True
2019 I - G51 | C | 6x10 | 100 | 3 | 2019 I - G51!M5 |  | True
2019 I - G51 | C | 10x10 | 100 | 2.6 | 2019 I - G51!O5 | a | True
2019 I - G51 | T | 4 | 200 | 2.9 | 2019 I - G51!B6 |  | True
2019 I - G51 | T | 6 | 200 | 2.4 | 2019 I - G51!C6 |  | True
2019 I - G51 | T | 8 | 200 | 5.4 | 2019 I - G51!D6 |  | True
2019 I - G51 | C | 6x10 | 200 | 1.68 | 2019 I - G51!E6 | c | True
2019 I - G51 | C | 10x10 | 200 | 2 | 2019 I - G51!G6 | c | True
2019 I - G51 | C | 6x10 | 160 | 2.2 | 2019 I - G51!I6 |  | True
2019 I - G51 | C | 10x10 | 160 | 2.6 | 2019 I - G51!K6 | c | True
2019 I - G51 | C | 6x10 | 100 | 3.4 | 2019 I - G51!M6 |  | True
2019 I - G51 | C | 10x10 | 100 | 2.7 | 2019 I - G51!O6 | a | True
2019 I - G51 | C | 6x10 | 200 | 2.26 | 2019 I - G51!E7 | c | True
2019 I - G51 | C | 10x10 | 200 | 2.07 | 2019 I - G51!G7 | c | True
2019 I - G51 | C | 6x10 | 160 | 2.6 | 2019 I - G51!I7 |  | True
2019 I - G51 | C | 10x10 | 160 | 2.3 | 2019 I - G51!K7 | c | True
2019 I - G51 | C | 6x10 | 100 | 2.6 | 2019 I - G51!M7 |  | True
2019 I - G51 | C | 10x10 | 100 | 3 | 2019 I - G51!O7 | d | True
2019 I - G51 | T | 4 | 200 | 2.9 | 2019 I - G51!B8 |  | True
2019 I - G51 | T | 6 | 200 | 5 | 2019 I - G51!C8 |  | True
2019 I - G51 | T | 8 | 200 | 2.1 | 2019 I - G51!D8 |  | True
2019 I - G51 | C | 6x10 | 200 | 1.9 | 2019 I - G51!E8 | c | True
2019 I - G51 | C | 10x10 | 200 | 2.1 | 2019 I - G51!G8 | c | True
2019 I - G51 | C | 6x10 | 160 | 5 | 2019 I - G51!I8 | c | True
2019 I - G51 | C | 10x10 | 160 | 2.4 | 2019 I - G51!K8 | c | True
2019 I - G51 | C | 6x10 | 100 | 1.8 | 2019 I - G51!M8 |  | True
2019 I - G51 | C | 10x10 | 100 | 3.4 | 2019 I - G51!O8 | a | True
2019 I - G51 | C | 6x10 | 200 | 1.5 | 2019 I - G51!E9 | c | True
2019 I - G51 | C | 10x10 | 200 | 1.6 | 2019 I - G51!G9 | c | True
2019 I - G51 | C | 6x10 | 160 | 3.8 | 2019 I - G51!I9 | c | True
2019 I - G51 | C | 10x10 | 160 | 2 | 2019 I - G51!K9 | c | True
2019 I - G51 | C | 6x10 | 100 | 2 | 2019 I - G51!M9 |  | True
2019 I - G51 | C | 10x10 | 100 | 2.4 | 2019 I - G51!O9 | b | True
2019 I - G51 | T | 4 | 200 | 1.1 | 2019 I - G51!B10 |  | True
2019 I - G51 | T | 6 | 200 | 1.5 | 2019 I - G51!C10 |  | True
2019 I - G51 | T | 8 | 200 | 2 | 2019 I - G51!D10 |  | True
2019 I - G51 | C | 6x10 | 200 | 1.85 | 2019 I - G51!E10 | b | True
2019 I - G51 | C | 10x10 | 200 | 2.2 | 2019 I - G51!G10 | c | True
2019 I - G51 | C | 6x10 | 160 | 1.9 | 2019 I - G51!I10 | b | True
2019 I - G51 | C | 10x10 | 160 | 2 | 2019 I - G51!K10 | c | True
2019 I - G51 | C | 6x10 | 100 | 3 | 2019 I - G51!M10 |  | True
2019 I - G51 | C | 10x10 | 100 | 2.6 | 2019 I - G51!O10 |  | True
2019 I - G51 | C | 6x10 | 200 | 1.65 | 2019 I - G51!E11 | b | True
2019 I - G51 | C | 10x10 | 200 | 1.6 | 2019 I - G51!G11 | b | True
2019 I - G51 | C | 6x10 | 160 | 1.5 | 2019 I - G51!I11 | b | True
2019 I - G51 | C | 10x10 | 160 | 1.7 | 2019 I - G51!K11 | c | True
2019 I - G51 | C | 6x10 | 100 | 2.15 | 2019 I - G51!M11 |  | True
2019 I - G51 | C | 10x10 | 100 | 2.4 | 2019 I - G51!O11 |  | True
2019 I - G51 | T | 4 | 200 | 1 | 2019 I - G51!B12 |  | True
2019 I - G51 | T | 6 | 200 | 1.7 | 2019 I - G51!C12 |  | True
2019 I - G51 | T | 8 | 200 | 2.2 | 2019 I - G51!D12 |  | True
2019 I - G51 | C | 6x10 | 200 | 1.2 | 2019 I - G51!E12 | b | True
2019 I - G51 | C | 10x10 | 200 | 1.3 | 2019 I - G51!G12 | b | True
2019 I - G51 | C | 6x10 | 160 | 1.3 | 2019 I - G51!I12 | b | True
2019 I - G51 | C | 10x10 | 160 | 1.1 | 2019 I - G51!K12 | b | True
2019 I - G51 | C | 6x10 | 100 | 2.8 | 2019 I - G51!M12 |  | True
2019 I - G51 | C | 10x10 | 100 | 2.3 | 2019 I - G51!O12 |  | True
2019 I - G51 | C | 6x10 | 200 | 1 | 2019 I - G51!E13 | b | True
2019 I - G51 | C | 10x10 | 200 | 1.8 | 2019 I - G51!G13 | b | True
2019 I - G51 | C | 6x10 | 160 | 2.6 | 2019 I - G51!I13 | b | True
2019 I - G51 | C | 10x10 | 160 | 1.3 | 2019 I - G51!K13 | b | True
2019 I - G51 | C | 6x10 | 100 | 1.8 | 2019 I - G51!M13 |  | True
2019 I - G51 | C | 10x10 | 100 | 2 | 2019 I - G51!O13 |  | True
2018 II - G51 | T | 4 | 200 | 2.1 | 2018 II - G51!B4 |  | True
2018 II - G51 | T | 6 | 200 | 1.8 | 2018 II - G51!C4 |  | True
2018 II - G51 | T | 8 | 200 | 4.2 | 2018 II - G51!D4 |  | True
2018 II - G51 | C | 6x10 | 200 | 1.7 | 2018 II - G51!E4 | b | True
2018 II - G51 | C | 10x10 | 200 | 4.3 | 2018 II - G51!G4 | c | True
2018 II - G51 | C | 6x10 | 160 | 1.8 | 2018 II - G51!I4 | b | True
2018 II - G51 | C | 10x10 | 160 | 2.4 | 2018 II - G51!K4 | a | True
2018 II - G51 | C | 6x10 | 100 | 2.3 | 2018 II - G51!M4 | b | True
2018 II - G51 | C | 10x10 | 100 | 3.2 | 2018 II - G51!O4 | a | True
2018 II - G51 | C | 6x10 | 50 | 2.4 | 2018 II - G51!Q4 | a | True
2018 II - G51 | C | 10x10 | 50 | 3.6 | 2018 II - G51!S4 | a | True
2018 II - G51 | C | 6x10 | 200 | 1.7 | 2018 II - G51!E5 | b | True
2018 II - G51 | C | 10x10 | 200 | 3.1 | 2018 II - G51!G5 | a | True
2018 II - G51 | C | 6x10 | 160 | 2.2 | 2018 II - G51!I5 | b | True
2018 II - G51 | C | 10x10 | 160 | 2.2 | 2018 II - G51!K5 | b | True
2018 II - G51 | C | 6x10 | 100 | 2.4 | 2018 II - G51!M5 | b | True
2018 II - G51 | C | 10x10 | 100 | 3.7 | 2018 II - G51!O5 | a | True
2018 II - G51 | C | 6x10 | 50 | 2.4 | 2018 II - G51!Q5 | a | True
2018 II - G51 | C | 10x10 | 50 | 2.9 | 2018 II - G51!S5 | a | True
2018 II - G51 | T | 4 | 200 | 2.1 | 2018 II - G51!B6 |  | True
2018 II - G51 | T | 6 | 200 | 3 | 2018 II - G51!C6 |  | True
2018 II - G51 | T | 8 | 200 | 4.6 | 2018 II - G51!D6 |  | True
2018 II - G51 | C | 6x10 | 200 | 1.4 | 2018 II - G51!E6 |  | True
2018 II - G51 | C | 10x10 | 200 | 1.8 | 2018 II - G51!G6 | b | True
2018 II - G51 | C | 6x10 | 160 | 1.9 | 2018 II - G51!I6 | b | True
2018 II - G51 | C | 10x10 | 160 | 2.8 | 2018 II - G51!K6 | b | True
2018 II - G51 | C | 6x10 | 100 | 2.5 | 2018 II - G51!M6 | c | True
2018 II - G51 | C | 10x10 | 100 | 4 | 2018 II - G51!O6 | a | True
2018 II - G51 | C | 6x10 | 50 | 2.9 | 2018 II - G51!Q6 | a | True
2018 II - G51 | C | 10x10 | 50 | 3 | 2018 II - G51!S6 | c | True
2018 II - G51 | C | 6x10 | 200 | 3 | 2018 II - G51!E7 | b | True
2018 II - G51 | C | 10x10 | 200 | 1.9 | 2018 II - G51!G7 | b | True
2018 II - G51 | C | 6x10 | 160 | 1.9 | 2018 II - G51!I7 | b | True
2018 II - G51 | C | 10x10 | 160 | 2.9 | 2018 II - G51!K7 | b | True
2018 II - G51 | C | 6x10 | 100 | 2.5 | 2018 II - G51!M7 | c | True
2018 II - G51 | C | 10x10 | 100 | 2.3 | 2018 II - G51!O7 | d | True
2018 II - G51 | C | 6x10 | 50 | 2.7 | 2018 II - G51!Q7 | a | True
2018 II - G51 | C | 10x10 | 50 | 2.5 | 2018 II - G51!S7 | a | True
2018 II - G51 | T | 4 | 200 | 0.8 | 2018 II - G51!B8 |  | True
2018 II - G51 | T | 6 | 200 | 1.4 | 2018 II - G51!C8 |  | True
2018 II - G51 | T | 8 | 200 | 4.2 | 2018 II - G51!D8 |  | True
2018 II - G51 | C | 6x10 | 200 | 1.25 | 2018 II - G51!E8 | b | True
2018 II - G51 | C | 10x10 | 200 | 2.3 | 2018 II - G51!G8 | c | True
2018 II - G51 | C | 6x10 | 160 | 2.2 | 2018 II - G51!I8 | b | True
2018 II - G51 | C | 10x10 | 160 | 2.6 | 2018 II - G51!K8 | b | True
2018 II - G51 | C | 6x10 | 100 | 2.5 | 2018 II - G51!M8 | a | True
2018 II - G51 | C | 10x10 | 100 | 2.4 | 2018 II - G51!O8 | a | True
2018 II - G51 | C | 6x10 | 50 | 2.3 | 2018 II - G51!Q8 | a | True
2018 II - G51 | C | 10x10 | 50 | 3.4 | 2018 II - G51!S8 | c | True
2018 II - G51 | T | 4 | 200 | 0.94 | 2018 II - G51!B9 |  | True
2018 II - G51 | T | 6 | 200 | 1.4 | 2018 II - G51!C9 |  | True
2018 II - G51 | C | 6x10 | 200 | 1.5 | 2018 II - G51!E9 | b | True
2018 II - G51 | C | 10x10 | 200 | 2.8 | 2018 II - G51!G9 | b | True
2018 II - G51 | C | 6x10 | 160 | 1.8 | 2018 II - G51!I9 | a | True
2018 II - G51 | C | 10x10 | 160 | 2.2 | 2018 II - G51!K9 | b | True
2018 II - G51 | C | 6x10 | 100 | 1.7 | 2018 II - G51!M9 | a | True
2018 II - G51 | C | 10x10 | 100 | 2.1 | 2018 II - G51!O9 | b | True
2018 II - G51 | C | 6x10 | 50 | 3.2 | 2018 II - G51!Q9 | a | True
2018 II - G51 | C | 10x10 | 50 | 2 | 2018 II - G51!S9 | a | True
2018 II - G52 | T | 4 | 200 | 1.45 | 2018 II - G52!B4 |  | True
2018 II - G52 | T | 6 | 200 | 2.35 | 2018 II - G52!C4 |  | True
2018 II - G52 | T | 8 | 200 | 3 | 2018 II - G52!D4 |  | True
2018 II - G52 | C | 6x10 | 200 | 3.3 | 2018 II - G52!E4 | b | True
2018 II - G52 | C | 10x10 | 200 | 2.9 | 2018 II - G52!G4 | b | True
2018 II - G52 | C | 6x10 | 160 | 4.4 | 2018 II - G52!I4 |  | True
2018 II - G52 | C | 10x10 | 160 | 5.2 | 2018 II - G52!K4 |  | True
2018 II - G52 | C | 6x10 | 100 | 3.3 | 2018 II - G52!M4 | c | True
2018 II - G52 | C | 10x10 | 100 | 4.8 | 2018 II - G52!O4 | c | True
2018 II - G52 | C | 6x10 | 50 | 4.7 | 2018 II - G52!Q4 |  | True
2018 II - G52 | C | 10x10 | 50 | 3.4 | 2018 II - G52!S4 |  | True
2018 II - G52 | C | 6x10 | 200 | 1.8 | 2018 II - G52!E5 | b | True
2018 II - G52 | C | 10x10 | 200 | 3.2 | 2018 II - G52!G5 | b | True
2018 II - G52 | C | 6x10 | 160 | 2.6 | 2018 II - G52!I5 |  | True
2018 II - G52 | C | 10x10 | 160 | 4.2 | 2018 II - G52!K5 |  | True
2018 II - G52 | C | 6x10 | 100 | 4.4 | 2018 II - G52!M5 | c | True
2018 II - G52 | C | 10x10 | 100 | 3.8 | 2018 II - G52!O5 | c | True
2018 II - G52 | C | 6x10 | 50 | 3.8 | 2018 II - G52!Q5 |  | True
2018 II - G52 | C | 10x10 | 50 | 4.1 | 2018 II - G52!S5 |  | True
2018 II - G52 | C | 10x10 | 100 | 3.3 | 2018 II - G52!O6 | c | True
2018 II - G52 | T | 4 | 200 | 2.6 | 2018 II - G52!B7 |  | True
2018 II - G52 | T | 6 | 200 | 4.2 | 2018 II - G52!C7 |  | True
2018 II - G52 | T | 8 | 200 | 5.6 | 2018 II - G52!D7 |  | True
2018 II - G52 | C | 6x10 | 200 | 2.2 | 2018 II - G52!E7 | b | True
2018 II - G52 | C | 10x10 | 200 | 4 | 2018 II - G52!G7 | b | True
2018 II - G52 | C | 6x10 | 160 | 2.8 | 2018 II - G52!I7 | c | True
2018 II - G52 | C | 10x10 | 160 | 3.6 | 2018 II - G52!K7 | c | True
2018 II - G52 | C | 6x10 | 100 | 3.4 | 2018 II - G52!M7 | c | True
2018 II - G52 | C | 10x10 | 100 | 4 | 2018 II - G52!O7 | c | True
2018 II - G52 | C | 6x10 | 50 | 3.5 | 2018 II - G52!Q7 | c | True
2018 II - G52 | C | 10x10 | 50 | 4.2 | 2018 II - G52!S7 | c | True
2018 II - G52 | C | 6x10 | 200 | 2.1 | 2018 II - G52!E8 | b | True
2018 II - G52 | C | 10x10 | 200 | 3.5 | 2018 II - G52!G8 | c | True
2018 II - G52 | C | 6x10 | 160 | 2.3 | 2018 II - G52!I8 | b | True
2018 II - G52 | C | 10x10 | 160 | 3.4 | 2018 II - G52!K8 | b | True
2018 II - G52 | C | 6x10 | 100 | 2.5 | 2018 II - G52!M8 | c | True
2018 II - G52 | C | 10x10 | 100 | 3.8 | 2018 II - G52!O8 | c | True
2018 II - G52 | C | 6x10 | 50 | 3.1 | 2018 II - G52!Q8 | c | True
2018 II - G52 | C | 10x10 | 50 | 4.4 | 2018 II - G52!S8 | b | True
2018 II - G52 | T | 4 | 200 | 1.2 | 2018 II - G52!B9 |  | True
2018 II - G52 | T | 6 | 200 | 2.2 | 2018 II - G52!C9 |  | True
2018 II - G52 | T | 8 | 200 | 3 | 2018 II - G52!D9 |  | True
2018 II - G52 | C | 6x10 | 200 | 2.1 | 2018 II - G52!E9 | b | True
2018 II - G52 | C | 10x10 | 200 | 2.2 | 2018 II - G52!G9 | b | True
2018 II - G52 | C | 6x10 | 160 | 3 | 2018 II - G52!I9 | b | True
2018 II - G52 | C | 10x10 | 160 | 2.8 | 2018 II - G52!K9 | b | True
2018 II - G52 | C | 6x10 | 100 | 3.7 | 2018 II - G52!M9 | c | True
2018 II - G52 | C | 10x10 | 100 | 4.2 | 2018 II - G52!O9 | c | True
2018 II - G52 | C | 6x10 | 50 | 2.3 | 2018 II - G52!Q9 | c | True
2018 II - G52 | C | 10x10 | 50 | 3.2 | 2018 II - G52!S9 | c | True
2018 II - G52 | C | 6x10 | 200 | 2.5 | 2018 II - G52!E10 | b | True
2018 II - G52 | C | 10x10 | 200 | 3.4 | 2018 II - G52!G10 | b | True
2018 II - G52 | C | 6x10 | 160 | 3 | 2018 II - G52!I10 | b | True
2018 II - G52 | C | 10x10 | 160 | 2.5 | 2018 II - G52!K10 | c | True
2018 II - G52 | C | 6x10 | 100 | 4 | 2018 II - G52!M10 | c | True
2018 II - G52 | C | 10x10 | 100 | 3.8 | 2018 II - G52!O10 | c | True
2018 II - G52 | C | 6x10 | 50 | 2.6 | 2018 II - G52!Q10 | c | True
2018 II - G52 | C | 10x10 | 50 | 3 | 2018 II - G52!S10 | c | True
2018 I - G51 | T | 4 | 200 | 2.2 | 2018 I - G51!B4 |  | True
2018 I - G51 | T | 6 | 200 | 2.8 | 2018 I - G51!C4 |  | True
2018 I - G51 | T | 8 | 200 | 4.25 | 2018 I - G51!D4 |  | True
2018 I - G51 | C | 6x10 | 200 | 2.6 | 2018 I - G51!E4 |  | True
2018 I - G51 | C | 10x10 | 200 | 3.8 | 2018 I - G51!G4 |  | True
2018 I - G51 | C | 6x10 | 160 | 2.6 | 2018 I - G51!I4 |  | True
2018 I - G51 | C | 10x10 | 160 | 4.5 | 2018 I - G51!K4 |  | True
2018 I - G51 | C | 6x10 | 100 | 4.7 | 2018 I - G51!M4 |  | True
2018 I - G51 | C | 10x10 | 100 | 4.6 | 2018 I - G51!O4 |  | True
2018 I - G51 | C | 6x10 | 50 | 6.5 | 2018 I - G51!Q4 |  | True
2018 I - G51 | C | 10x10 | 50 | 7 | 2018 I - G51!S4 |  | True
2018 I - G51 | T | 4 | 200 | 2.1 | 2018 I - G51!B5 |  | True
2018 I - G51 | T | 6 | 200 | 3.1 | 2018 I - G51!C5 |  | True
2018 I - G51 | T | 8 | 200 | 3.9 | 2018 I - G51!D5 |  | True
2018 I - G51 | C | 6x10 | 200 | 2.8 | 2018 I - G51!E5 |  | True
2018 I - G51 | C | 10x10 | 200 | 3.2 | 2018 I - G51!G5 |  | True
2018 I - G51 | C | 6x10 | 160 | 1.9 | 2018 I - G51!I5 |  | True
2018 I - G51 | C | 10x10 | 160 | 5 | 2018 I - G51!K5 |  | True
2018 I - G51 | C | 6x10 | 100 | 4.5 | 2018 I - G51!M5 |  | True
2018 I - G51 | C | 10x10 | 100 | 6.2 | 2018 I - G51!O5 |  | True
2018 I - G51 | C | 6x10 | 50 | 7.6 | 2018 I - G51!Q5 |  | True
2018 I - G51 | C | 10x10 | 50 | 7.4 | 2018 I - G51!S5 |  | True
2018 I - G51 | T | 6 | 200 | 3.1 | 2018 I - G51!C6 |  | True
2018 I - G51 | T | 8 | 200 | 3.9 | 2018 I - G51!D6 |  | True
2018 I - G51 | T | 4 | 200 | 2.3 | 2018 I - G51!B7 |  | True
2018 I - G51 | T | 6 | 200 | 3.9 | 2018 I - G51!C7 |  | True
2018 I - G51 | T | 8 | 200 | 4.7 | 2018 I - G51!D7 |  | True
2018 I - G51 | C | 6x10 | 200 | 3.9 | 2018 I - G51!E7 |  | True
2018 I - G51 | C | 10x10 | 200 | 2.2 | 2018 I - G51!G7 |  | True
2018 I - G51 | C | 6x10 | 160 | 4.1 | 2018 I - G51!I7 |  | True
2018 I - G51 | C | 10x10 | 160 | 4 | 2018 I - G51!K7 |  | True
2018 I - G51 | C | 6x10 | 100 | 4.75 | 2018 I - G51!M7 |  | True
2018 I - G51 | C | 10x10 | 100 | 5.5 | 2018 I - G51!O7 |  | True
2018 I - G51 | C | 6x10 | 50 | 6.125 | 2018 I - G51!Q7 |  | True
2018 I - G51 | C | 10x10 | 50 | 6.25 | 2018 I - G51!S7 |  | True
2018 I - G51 | T | 4 | 200 | 2.7 | 2018 I - G51!B8 |  | True
2018 I - G51 | T | 6 | 200 | 4.2 | 2018 I - G51!C8 |  | True
2018 I - G51 | T | 8 | 200 | 5.6 | 2018 I - G51!D8 |  | True
2018 I - G51 | C | 6x10 | 200 | 3.9 | 2018 I - G51!E8 |  | True
2018 I - G51 | C | 10x10 | 200 | 2.9 | 2018 I - G51!G8 |  | True
2018 I - G51 | C | 6x10 | 160 | 4 | 2018 I - G51!I8 |  | True
2018 I - G51 | C | 10x10 | 160 | 3.6 | 2018 I - G51!K8 |  | True
2018 I - G51 | C | 6x10 | 100 | 5.1 | 2018 I - G51!M8 |  | True
2018 I - G51 | C | 10x10 | 100 | 6.5 | 2018 I - G51!O8 |  | True
2018 I - G51 | C | 6x10 | 50 | 6 | 2018 I - G51!Q8 |  | True
2018 I - G51 | C | 10x10 | 50 | 6.7 | 2018 I - G51!S8 |  | True
2018 I - G51 | T | 4 | 200 | 2.5 | 2018 I - G51!B9 |  | True
2018 I - G51 | T | 6 | 200 | 6.4 | 2018 I - G51!C9 |  | True
2018 I - G51 | T | 8 | 200 | 8 | 2018 I - G51!D9 |  | True
2018 I - G51 | C | 6x10 | 200 | 2 | 2018 I - G51!E9 |  | True
2018 I - G51 | C | 10x10 | 200 | 2.9 | 2018 I - G51!G9 |  | True
2018 I - G51 | C | 6x10 | 160 | 2 | 2018 I - G51!I9 |  | True
2018 I - G51 | C | 10x10 | 160 | 2.2 | 2018 I - G51!K9 |  | True
2018 I - G51 | C | 6x10 | 100 | 3.4 | 2018 I - G51!M9 |  | True
2018 I - G51 | C | 10x10 | 100 | 3.4 | 2018 I - G51!O9 |  | True
2018 I - G51 | C | 6x10 | 50 | 3.6 | 2018 I - G51!Q9 |  | True
2018 I - G51 | C | 10x10 | 50 | 5.25 | 2018 I - G51!S9 |  | True
2018 I - G51 | T | 4 | 200 | 2.8 | 2018 I - G51!B10 |  | True
2018 I - G51 | T | 6 | 200 | 5.3 | 2018 I - G51!C10 |  | True
2018 I - G51 | T | 8 | 200 | 8 | 2018 I - G51!D10 |  | True
2018 I - G51 | C | 6x10 | 200 | 2.6 | 2018 I - G51!E10 |  | True
2018 I - G51 | C | 10x10 | 200 | 3.3 | 2018 I - G51!G10 |  | True
2018 I - G51 | C | 6x10 | 160 | 1.6 | 2018 I - G51!I10 |  | True
2018 I - G51 | C | 10x10 | 160 | 3.2 | 2018 I - G51!K10 |  | True
2018 I - G51 | C | 6x10 | 100 | 2.6 | 2018 I - G51!M10 |  | True
2018 I - G51 | C | 10x10 | 100 | 2.6 | 2018 I - G51!O10 |  | True
2018 I - G51 | C | 6x10 | 50 | 3.55 | 2018 I - G51!Q10 |  | True
2018 I - G51 | C | 10x10 | 50 | 6 | 2018 I - G51!S10 |  | True
2018 I - G51 | T | 8 | 200 | 1 | 2018 I - G51!D12 |  | True
2018 I - G51 | C | 6x10 | 200 | 2.7 | 2018 I - G51!E12 |  | True
2018 I - G51 | C | 10x10 | 200 | 3.5 | 2018 I - G51!G12 |  | True
2018 I - G51 | C | 6x10 | 160 | 2.25 | 2018 I - G51!I12 |  | True
2018 I - G51 | C | 10x10 | 160 | 4.75 | 2018 I - G51!K12 |  | True
2018 I - G51 | C | 6x10 | 100 | 4.6 | 2018 I - G51!M12 |  | True
2018 I - G51 | C | 10x10 | 100 | 5.4 | 2018 I - G51!O12 |  | True
2018 I - G51 | C | 6x10 | 50 | 7.05 | 2018 I - G51!Q12 |  | True
2018 I - G51 | C | 10x10 | 50 | 7.2 | 2018 I - G51!S12 |  | True
2018 I - G51 | T | 8 | 200 | 2 | 2018 I - G51!D13 |  | True
2018 I - G51 | C | 6x10 | 200 | 3.9 | 2018 I - G51!E13 |  | True
2018 I - G51 | C | 10x10 | 200 | 2.55 | 2018 I - G51!G13 |  | True
2018 I - G51 | C | 6x10 | 160 | 4.05 | 2018 I - G51!I13 |  | True
2018 I - G51 | C | 10x10 | 160 | 3.8 | 2018 I - G51!K13 |  | True
2018 I - G51 | C | 6x10 | 100 | 4.925 | 2018 I - G51!M13 |  | True
2018 I - G51 | C | 10x10 | 100 | 6 | 2018 I - G51!O13 |  | True
2018 I - G51 | C | 6x10 | 50 | 6.0625 | 2018 I - G51!Q13 |  | True
2018 I - G51 | C | 10x10 | 50 | 6.475 | 2018 I - G51!S13 |  | True
2018 I - G51 | T | 8 | 200 | 3 | 2018 I - G51!D14 |  | True
2018 I - G51 | C | 6x10 | 200 | 2.3 | 2018 I - G51!E14 |  | True
2018 I - G51 | C | 10x10 | 200 | 3.1 | 2018 I - G51!G14 |  | True
2018 I - G51 | C | 6x10 | 160 | 1.8 | 2018 I - G51!I14 |  | True
2018 I - G51 | C | 10x10 | 160 | 2.7 | 2018 I - G51!K14 |  | True
2018 I - G51 | C | 6x10 | 100 | 3 | 2018 I - G51!M14 |  | True
2018 I - G51 | C | 10x10 | 100 | 3 | 2018 I - G51!O14 |  | True
2018 I - G51 | C | 6x10 | 50 | 3.575 | 2018 I - G51!Q14 |  | True
2018 I - G51 | C | 10x10 | 50 | 5.625 | 2018 I - G51!S14 |  | True
2022 I | T | 4 | 200 | 2.14 | 2022 I Tensión!B3 |  | True
2022 I | T | 6 | 200 | 3.831 | 2022 I Tensión!E3 |  | True
2022 I | T | 8 | 200 | 4.615 | 2022 I Tensión!H3 |  | True
2022 I | T | 4 | 200 | 2.55 | 2022 I Tensión!B4 |  | True
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
2022 II | T | 4 | 200 | 0.0006 | t4-1.lvm | bruto 1.582; base 1.5816 | False | señal sin ensayo (pico neto < 0,1 kgf)
2022 II | T | 4 | 200 | 1.3622 | t4-2.lvm | bruto 1.363; base 0.0009 | True
2022 II | T | 4 | 200 | 1.3221 | t4-3.lvm | bruto 1.317; base -0.0051 | True
2022 II | T | 6 | 200 | 0.5298 | t6-1.lvm | bruto 2.015; base 1.4858 | False | línea base corrida (1,49 kgf) y luego negativa: pico no confiable
2022 II | T | 6 | 200 | 2.2101 | t6-2.lvm | bruto 2.215; base 0.005 | True
2022 II | T | 6 | 200 | 2.153 | t6-3.lvm | bruto 2.164; base 0.0114 | True
2022 II | T | 8 | 200 | 2.8887 | t8-1.lvm | bruto 2.894; base 0.0053 | True
2022 II | T | 8 | 200 | 2.4116 | t8-2.lvm | bruto 2.469; base 0.0573 | True
2022 II | T | 8 | 200 | 2.6935 | t8-3.lvm | bruto 2.696; base 0.003 | True
2023 I | C | 10x10 | 100 | 6.1026 | C2-10-10-10-1.lvm | bruto 6.084; base 0.0183 | True
2023 I | C | 10x10 | 100 | 4.9396 | C2-10-10-10-2.lvm | bruto 5.031; base -0.0913 | True
2023 I | C | 10x10 | 100 | 3.8449 | C2-10-10-10-3.lvm | bruto 4.626; base -0.7808 | True | válido con tara (línea base corrida)
2023 I | C | 10x10 | 160 | 5.0721 | C3-10-10-16-2.lvm | bruto 5.218; base -0.1463 | True
2023 I | C | 10x10 | 160 | 4.7639 | C3-10-10-16-3.lvm | bruto 4.749; base 0.0149 | True
2023 I | C | 10x10 | 200 | 3.6773 | C4-10-10-20-1.lvm | bruto 3.672; base 0.0047 | True
2023 I | C | 10x10 | 200 | 3.5535 | C4-10-10-20-2.lvm | bruto 3.554; base -0.0003 | True
2023 I | C | 10x10 | 200 | 4.2098 | C4-10-10-20-3.lvm | bruto 4.275; base -0.0656 | True
2023 I | C | 6x10 | 200 | 3.4169 | C8-6-10-20-1.lvm | bruto 3.804; base -0.3875 | True | válido con tara (línea base corrida)
2023 I | C | 6x10 | 200 | 3.4301 | C8-6-10-20-2.lvm | bruto 3.419; base 0.0112 | True
2023 I | T | 4 | 200 | 0.2982 | T1-20-4-2.lvm | bruto 0.378; base 0.0793 (2023 I tensión: excluida) | False | 2023 I tensión excluida (igual que el autor: registros dudosos)
2023 I | T | 4 | 200 | 2.1923 | T1-20-4-2v2.lvm | bruto 2.201; base 0.0087 (2023 I tensión: excluida) | False | 2023 I tensión excluida (igual que el autor: registros dudosos)
2023 I | T | 4 | 200 | 2.2983 | T1-20-4-3.lvm | bruto 2.308; base 0.0093 (2023 I tensión: excluida) | False | 2023 I tensión excluida (igual que el autor: registros dudosos)
2023 I | T | 4 | 200 | 1.6076 | T1-20-4.lvm | bruto 1.605; base -0.0025 (2023 I tensión: excluida) | False | 2023 I tensión excluida (igual que el autor: registros dudosos)
2023 I | T | 4 | 200 | 1.5371 | T1-20-4.v2lvm | bruto 1.547; base 0.01 (2023 I tensión: excluida) | False | 2023 I tensión excluida (igual que el autor: registros dudosos)
2023 I | T | 6 | 200 | 1.4455 | T2-20-6-1.lvm | bruto 1.454; base 0.0088 (2023 I tensión: excluida) | False | 2023 I tensión excluida (igual que el autor: registros dudosos)
2023 I | T | 6 | 200 | 1.1498 | T2-20-6-2.lvm | bruto 1.169; base 0.0193 (2023 I tensión: excluida) | False | 2023 I tensión excluida (igual que el autor: registros dudosos)
2023 I | T | 6 | 200 | 2.6237 | T2-20-6-2v2.lvm | bruto 2.681; base 0.0572 (2023 I tensión: excluida) | False | 2023 I tensión excluida (igual que el autor: registros dudosos)
2023 I | T | 6 | 200 | 4.1166 | T2-20-6-3-V2.lvm | bruto 4.125; base 0.009 (2023 I tensión: excluida) | False | 2023 I tensión excluida (igual que el autor: registros dudosos)
2023 I | T | 6 | 200 | 3.0439 | T2-20-6-3-V3.lvm | bruto 3.049; base 0.0047 (2023 I tensión: excluida) | False | 2023 I tensión excluida (igual que el autor: registros dudosos)
2023 I | T | 6 | 200 | 0.0189 | T2-20-6-3.lvm | bruto 0.028; base 0.0091 (2023 I tensión: excluida) | False | 2023 I tensión excluida (igual que el autor: registros dudosos)
2023 I | T | 8 | 200 | 0.5175 | T3-20-8-1 V2.lvm | bruto 0.521; base 0.0035 (2023 I tensión: excluida) | False | 2023 I tensión excluida (igual que el autor: registros dudosos)
2023 I | T | 8 | 200 | 1.1549 | T3-20-8-1 V3.lvm | bruto 1.163; base 0.0083 (2023 I tensión: excluida) | False | 2023 I tensión excluida (igual que el autor: registros dudosos)
2023 I | T | 8 | 200 | 0.868 | T3-20-8-1.lvm | bruto 0.875; base 0.0068 (2023 I tensión: excluida) | False | 2023 I tensión excluida (igual que el autor: registros dudosos)
2023 I | T | 8 | 200 | 0.7703 | T3-20-8-2 V2.lvm | bruto 0.780; base 0.0102 (2023 I tensión: excluida) | False | 2023 I tensión excluida (igual que el autor: registros dudosos)
2023 I | T | 8 | 200 | 0.5999 | T3-20-8-2.lvm | bruto 0.636; base 0.0358 (2023 I tensión: excluida) | False | 2023 I tensión excluida (igual que el autor: registros dudosos)
