adrianix360/Proyecto_mecanica_del_solido_2/00_enunciado_y_referencias/datos_historicos_probetas/2018-2019_Resultados_probetas.xlsx

Sheet: 2019 II - G52
Resumen de falla de elementos
Grupo | 4 mm (tensión) | 6 mm (tensión) | 8 mm (tensión) | 200x 6 x 10 mm | 200 x 10 x 10 mm | 160 x 6 x 10 mm | 160 x 10 x 10 mm | 100 x 6 x 10 mm | 100 x 10 x 10 mm | 50 x 6 x 10 mm | 50 x 10 x 10 mm
1 | 1.2 | 2.0 | 6.6 | 3.1 | 2.4 | 2.3 | 1.7 | 4.2 | 2.9 | 3.0 | 2.8
 |  |  |  | 3.1 | 2.8 | 1.9 | 2.9 | 3.8 | 2.8 | 3.6 | 4.3
2 | 1.4 | 1.9 | 2.6 | 4.2 | 2.6 | 1.7 | 2.1 | 3.1 | 3.2 | 3.6 | 4.1
 |  |  |  | 3.4 | 3.1 | 2.2 | 2.1 | 3.2 | 2.2 | 3.4 | 2.8
3 | 2.0 | 2.8 | 6.5 | 3.0 | 3.3 | 5.0 | 5.5 | 5.2 | 4.3 | 6.0 | 6.2
 |  |  |  | 2.5 | 2.8 | 3.6 | 3.7 | 4.2 | 5.5 | 5.4 | 4.0
4 | 2 | 3.3 | 3.4 | 4.3 | 6.0 | 4.0 | 4.2 | 4.3 | 2.8 | 5.0 | 7.2
 |  |  |  | 5.0 | 5.8 | 4.2 | 5.5 | 4.2 | 4.2 | 4.8 | 6.5
5 | 1.6 | 1.95 | 3.1 | 3.1 | 3.3 | 2.5 | 3.6 | 2.5 | 3.0 | 2.2 | 3.5
 |  |  |  | 2.5 | 2.3 | 2.6 | 3.5 | 2.5 | 2.4 | 3.6 | 4.0
a | aplastamiento
b | pandeo
c | compresión
d | torsión
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
