adrianix360/Proyecto_mecanica_del_solido_2/00_enunciado_y_referencias/datos_historicos_probetas/2022-I_Resultados_probetas.xlsx

Sheet: Tensión
Prueba en tensión | kgf | Prueba en tensión | kgf | Prueba en tensión | kgf
T-3-1-4-1 | 2.14 | T-3-1-6-1 | 3.831 | T-3-1-8-1 | 4.615
T-3-1-4-2 | 2.55 | T-3-1-6-2 | 3.772 | T-3-1-8-2 | 5.421
T-3-1-4-3 |  | T-3-1-6-3* | 3.241 | T-3-1-8-3 | 5.625
T-1-4-4-1 | 1.26 | T-2-2-6-1 | 3.218 | T-1-3-8-1 | 4.083
T-1-4-4-2 | 1.586 | T-2-2-6-2 | 2.73 | T-1-3-8-2 | 4.445
T-1-4-4-3 | 1.228 | T-2-2-6-3 | 3.175 | T-1-3-8-3
T-1-1-4-1 | 1.683 | T-1-4-6-1 | 3.278 | T-1-1-8-1 | 8.152
T-1-1-4-2 | 1.915 | T-1-4-6-2 | 2.298 | T-1-1-8-2 | 7.548
T-1-1-4-3 |  | T-1-4-6-3 | 3.017 | T-1-1-8-3 | 3.334
T-1-3-4-1 | 1.197 | T-1-1-6-1 | 3.027 | T-1-4-8-1 | 4.03
T-1-3-4-2 | 2.591 | T-1-1-6-2 | 5.658 | T-1-4-8-2 | 4.1
T-1-3-4-3 | 2.049 | T-1-1-6-3 | 3.083 | T-1-4-8-3 | 4.096
 |  | T-1-3-6-1 | 2.036
 |  | T-1-3-6-2 | 2.947
 |  | T-1-3-6-3 | 3.143
Prueba-Grupo de matricula-Grupo de trabajo-Ancho nominal-Muestra
3-1 Zhuohang
1-4 Osvaldo
1-3 Felipe
1-1 Daniel
2-2 Kimberly
2-1 Lesly
*Espécimen con defecto

Sheet: Compresión
Prueba en Compresión | kgf | Prueba en Compresión | kgf | Prueba en Compresión | kgf
C-1-3-1-1 | 3.487 | C-1-1-2-1 | 4.731 | C-1-1-3-1 | 2.08
C-1-3-1-2 | 3.594 | C-1-1-2-2 | 5.774 | C-1-1-3-2 | 2.178
C-1-3-1-3 | 6.239 | C-1-1-2-3 | 4.852 | C-1-1-3-3 | 3.371
 |  | C-1-3-2-1 | 5.744 | C-1-3-3-1 | 3.095
 |  | C-1-3-2-2 | 2.962 | C-1-3-3-2 | 3.761
 |  | C-1-3-2-3 | 3.349 | C-1-3-3-3 | 2.579
Prueba en Compresión | kgf | Prueba en Compresión | kgf | Prueba en Compresión | kgf
C-3-1-4-1 | 0.625 | C-1-1-5-1 | 2.974 | C-2-1-6-1 | 2.756
C-3-1-4-2 | 1.646 | C-1-1-5-2 | 4.768 | C-2-1-6-2 | 5.074
C-3-1-4-3 | 1.625 | C-1-1-5-3 | 3.411 | C-2-1-6-3 | 4.238
C-1-1-4-1 | 2.778 | C-2-1-5-1 | 3.13 | C-1-1-6-1 | 6.502
C-1-1-4-2 | 2.872 | C-2-1-5-2 | 2.728 | C-1-1-6-2 | 4.989
C-1-1-4-3 | 2.977 | C-2-1-5-3 | 2.62 | C-1-1-6-3 | 7.109
Prueba en Compresión | kgf | Prueba en Compresión | kgf
C-1-1-7-1 | 3.606 | C-3-1-8-1 | 1.71
C-1-1-7-2 | 2.912 | C-3-1-8-2 | 2.264
C-1-1-7-3 |  | C-3-1-8-3 | 2.276
C-1-3-7-1 | 2.468 | C-1-1-8-1 | 3.963
C-1-3-7-2 | 1.403 | C-1-1-8-2 | 4.399
C-1-3-7-3 | 1.398 | C-1-1-8-3 | 3.046
