adrianix360/Proyecto_mecanica_del_solido_2/04_despiece_corte_cameo/CONTROL_TAPETES_v02.pdf

# CONTROL DE TAPETES - PUENTE WARREN IC-0610 - DESPIECE v02 PARA CAMEO 5 ALPHA

Fecha: 2026-10-22 · hoja de tapete 235 × 300 mm (300 en el sentido de avance) · zona útil 225 × 290 · separación 2 mm

Imprimir en A3 vertical a TAMAÑO REAL (100 %, sin ajustar) y verificar las barras de control de 100 mm antes de usarlo.
Cada página siguiente es un tapete a 1:1 (respaldo para cortar a mano) con su lista de casillas.
Al despegar cada pieza marque «Desp.»; al guardarla en su sobre marque «Guard.». El sobre lleva el nombre del miembro o nudo (y la armadura A o B en cartelas y tiras). Cartelas y tiras B6 con k > tot/2 son de la armadura B y se cortaron en espejo.
T00 es el corte de prueba (no es del puente). El último tapete (VP2-VP5) está RETENIDO por H-01: no cortarlo todavía.
| Rojo: corte de contorno (AutoBlade) | | | Magenta: ranura (AutoBlade, antes que el contorno)
| Azul: rótulos y escuadra (bolígrafo) | | | Verde: pliegues (bolígrafo)
Cian: ejes, contornos de miembros y centro del nudo (bolígrafo) | Gris: referencia, sin acción

## TAPETES

Tapete | Archivo | Tipo | Hojas Contenido (miembro o nudo × hojas)
T00 | T00_PRUEBA.dxf | prueba | 4 | PRUEBA ×4
T01 | T01_v02.dxf | corte | 18 | CS3 ×6, CS2 ×4, DW8 ×4, A1 ×4
T02 | T02_v02.dxf | corte | 18 | CS4 ×6, CS5 ×4, DW5 ×4, A6 ×4
T03 | T03_v02.dxf | corte | 16 | CS1 ×2, CS6 ×2, PE2 ×4, CI c3-t1 ×4, A0 ×4
T04 | T04_v02.dxf | corte | 14 | PE1 ×4, DW7 ×2, CI c1-t1 ×4, A7 ×4
T05 | T05_v02.dxf | corte | 22 | DW2 ×4, DW4 ×2, U1 ×4, TS ×12
T06 | T06_v02.dxf | corte | 20 | DW11 ×4, DW10 ×8, A2 ×8
T07 | T07_v02.dxf | corte | 24 | DW9 ×2, DW6 ×2, DW12 ×8, A5 ×8, U7 ×4
T08 | T08_v02.dxf | corte | 32 | DW1 ×8, DW3 ×8, CI c3-t2 ×4, CI c2-t1 ×4, A3 ×8
T09 | T09_v02.dxf | corte | 28 | CI c1-t2 ×4, CI c2-t2 ×4, CI c1-t3 ×4, A4 ×8, U2 ×8
T10 | T10_v02.dxf | corte | 34 | U3 ×8, U5 ×8, U6 ×8, U4 ×8, VP1 ×1, VP6 ×1
T11 | T11_v02.dxf | corte | 27 | VP0 ×1, VP7 ×1, PS ×7, TP ×4, GT ×14
T12 | T12_RETENIDO_H01_v02.dxf | retenido | 16 | VP2 ×4, VP3 ×4, VP4 ×4, VP5 ×4

## SOBRES (uno por miembro o nudo; cartelas y tiras separadas por armadura)

CS1 (2) - T03
CS2 (4) - T01
CS3 (6) - T01
CS4 (6) - T02
CS5 (4) - T02
CS6 (2) - T03
PE1 (4) - T04
PE2 (4) - T03
DW2 (4) - T05
DW4 (2) - T05
DW6 (2) - T07
DW7 (2) - T04
DW9 (2) - T07
DW11 (4) - T06
DW1 A (4) - T08
DW1 B (4) - T08
DW3 A (4) - T08
DW3 B (4) - T08
DW5 A (2) - T02
DW5 B (2) - T02
DW8 A (2) - T01

DW8 B (2) - T01
DW10 A (4) - T06
DW10 B (4) - T06
DW12 A (4) - T07
DW12 B (4) - T07
CI c1-t1 A (2) - T04
CI c1-t1 B (2) - T04
CI c1-t2 A (2) - T09
CI c1-t2 B (2) - T09
CI c1-t3 A (2) - T09
CI c1-t3 B (2) - T09
CI c2-t1 A (2) - T08
CI c2-t1 B (2) - T08
CI c2-t2 A (2) - T09
CI c2-t2 B (2) - T09
CI c3-t1 A (2) - T03
CI c3-t1 B (2) - T03
CI c3-t2 A (2) - T08
CI c3-t2 B (2) - T08
A0 A (2) - T03
A0 B (2) - T03

A1 A (2) - T01
A1 B (2) - T01
A2 A (4) - T06
A2 B (4) - T06
A3 A (4) - T08
A3 B (4) - T08
A4 A (4) - T09
A4 B (4) - T09
A5 A (4) - T07
A5 B (4) - T07
A6 A (2) - T02
A6 B (2) - T02
A7 A (2) - T04
A7 B (2) - T04
U1 A (2) - T05
U1 B (2) - T05
U2 A (4) - T09
U2 B (4) - T09
U3 A (4) - T10
U3 B (4) - T10
U4 A (4) - T10

U4 B (4) - T10
U5 A (4) - T10
U5 B (4) - T10
U6 A (4) - T10
U6 B (4) - T10
U7 A (2) - T07
U7 B (2) - T07
VP0 (1) - T11
VP1 (1) - T10
VP2 (4) - T12
VP3 (4) - T12
VP4 (4) - T12
VP5 (4) - T12
VP6 (1) - T10
VP7 (1) - T11
PS (7) - T11
TS (12) - T05
TP (4) - T11
GT (14) - T11

CONTROL 100 mm

CONTROL 100 mm

# T00 · T00_PRUEBA.dxf · 4 hojas · CORTE DE PRUEBA

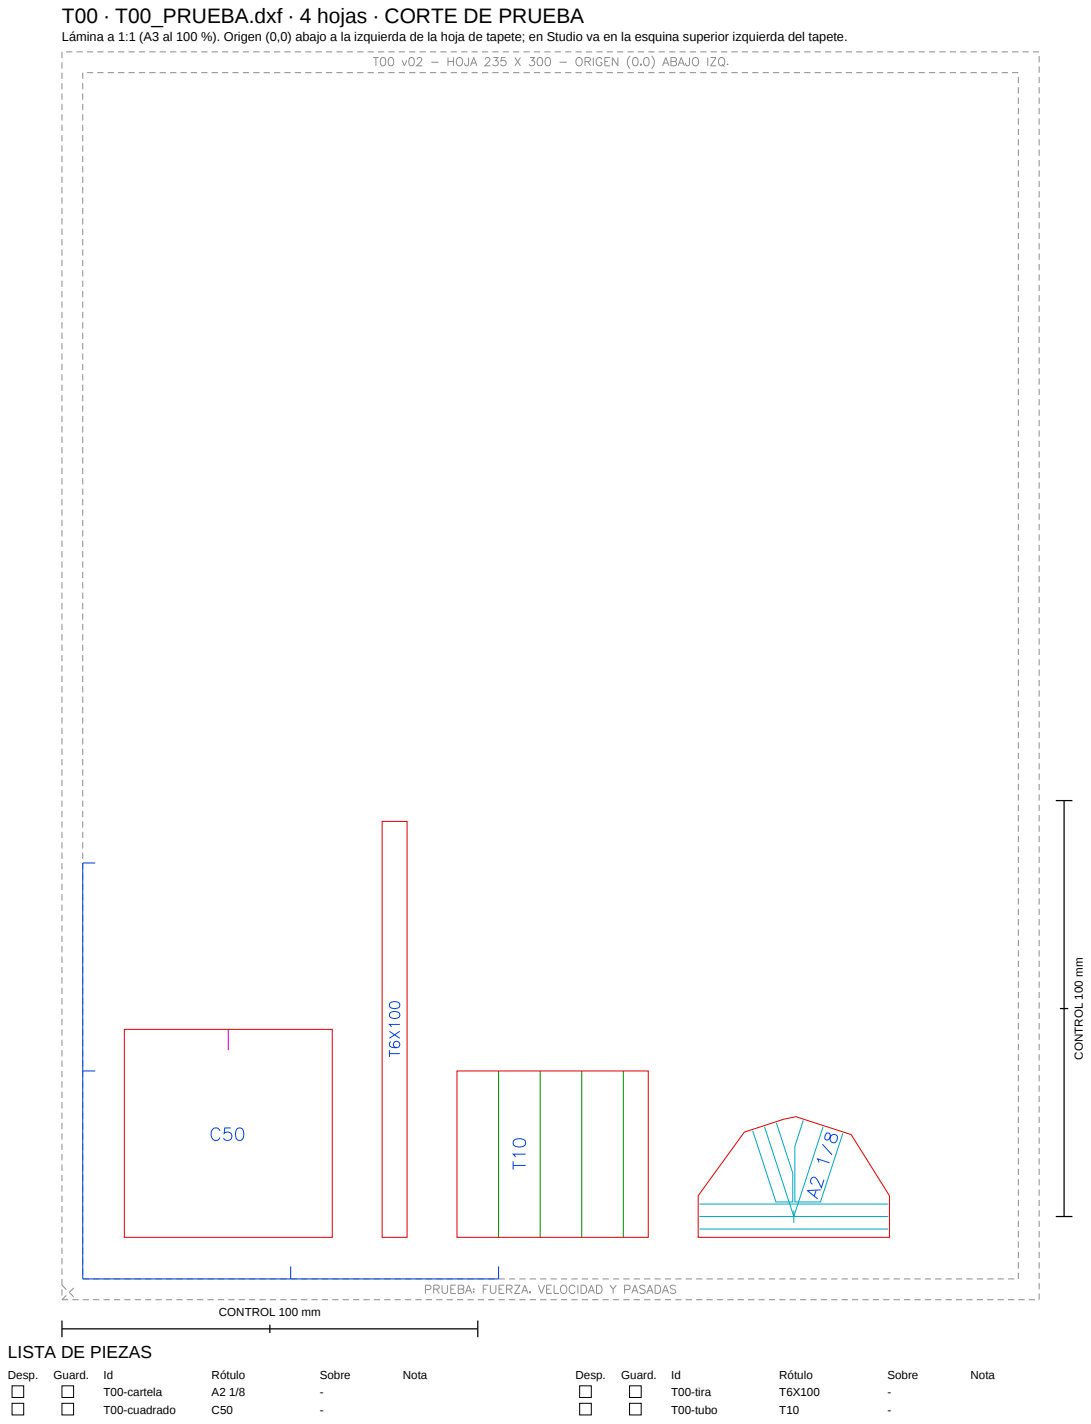
[picture p64: page 2]
CONTROL 100 mm; Desp.; Guard.; Rótulo; Sobre; Nota; T00-cartela; T00-cuadrado; T00-tira; T00-tubo

Lámina a 1:1 (A3 al 100 %). Origen (0,0) abajo a la izquierda de la hoja de tapete; en Studio va en la esquina superior izquierda del tapete.

LISTA DE PIEZAS

# T01 · T01_v02.dxf · 18 hojas · CORTAR

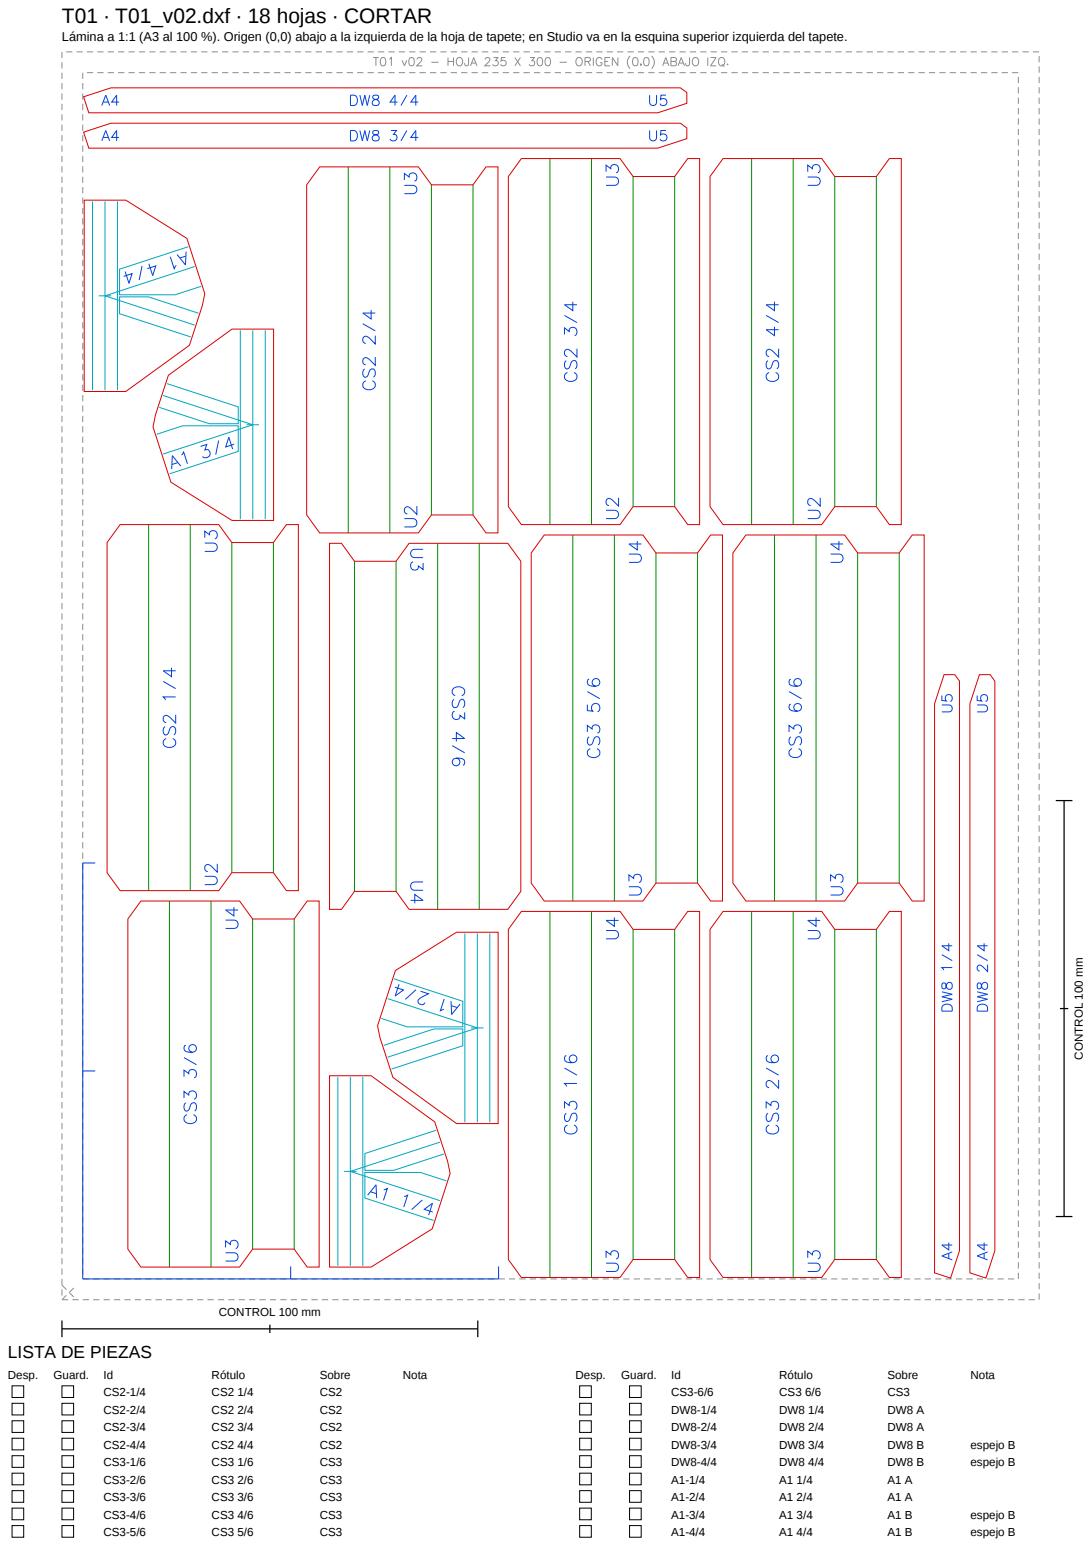
[picture p65: page 3]
CONTROL 100 mm; Desp.; Guard.; Rótulo; Sobre; Nota; espejo B

LISTA DE PIEZAS

# T02 · T02_v02.dxf · 18 hojas · CORTAR

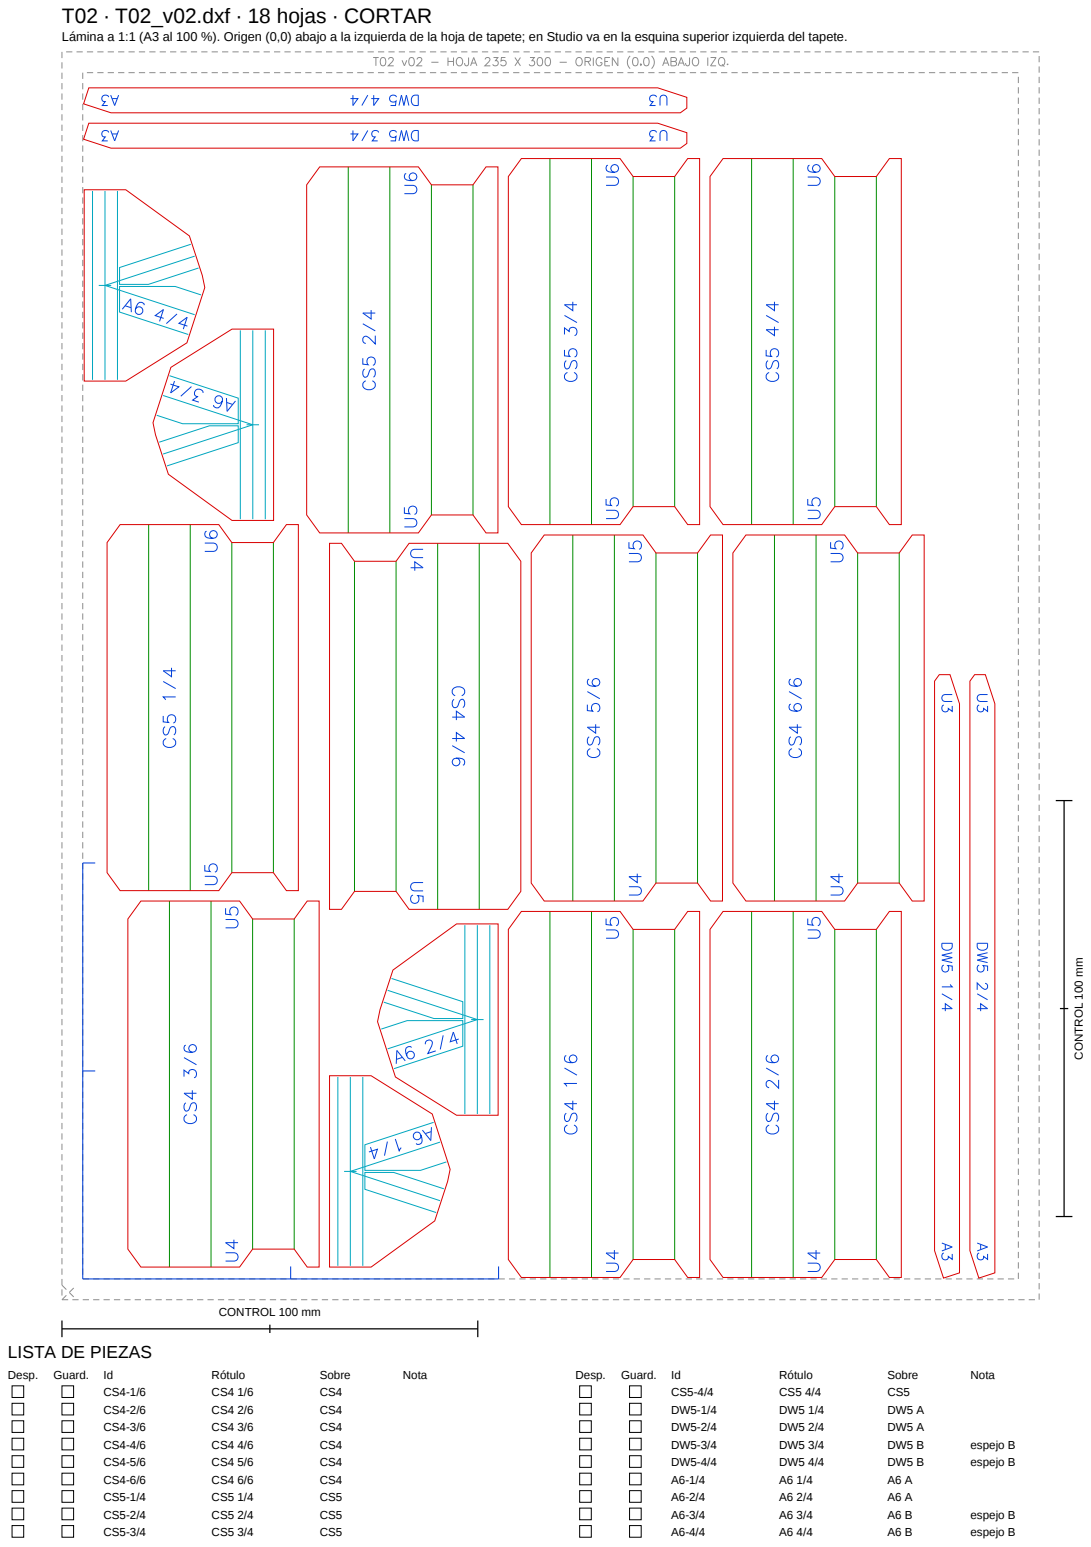
[picture p66: page 4]
CONTROL 100 mm; Desp.; Guard.; Rótulo; Sobre; Nota; espejo B

LISTA DE PIEZAS

# T03 · T03_v02.dxf · 16 hojas · CORTAR

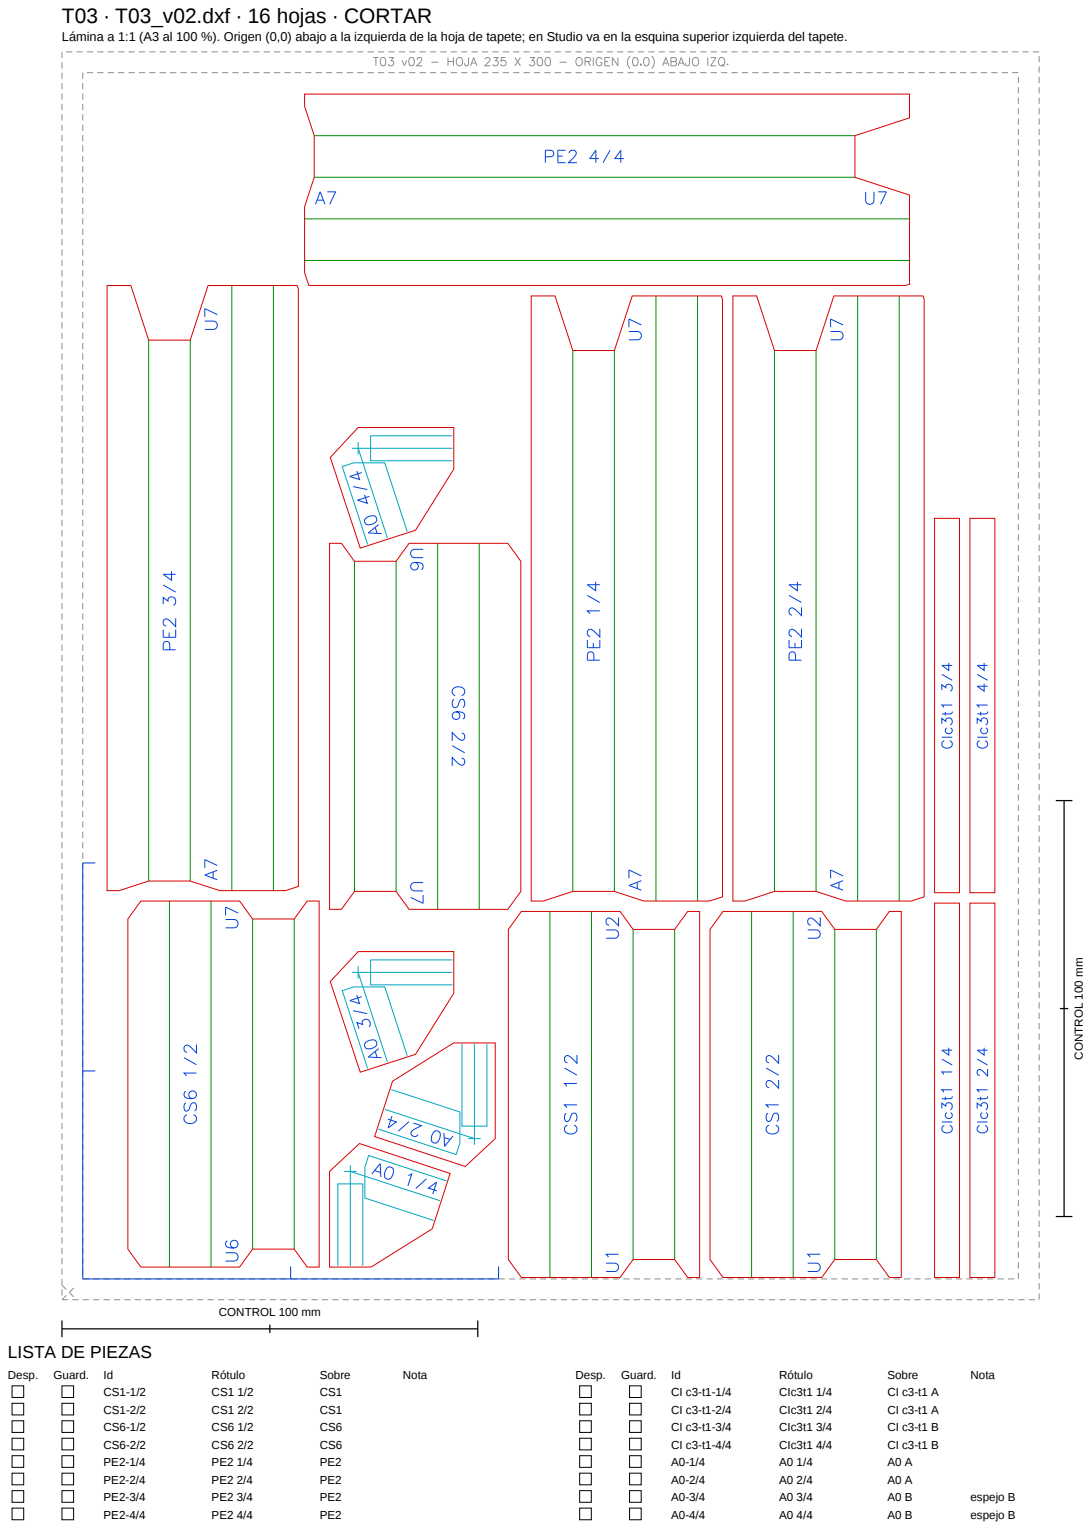
[picture p67: page 5]
CONTROL 100 mm; Desp.; Guard.; Rótulo; Sobre; Nota; CIc3t1 1/4; CIc3t1 2/4; CIc3t1 3/4; CIc3t1 4/4; espejo B

LISTA DE PIEZAS

# T04 · T04_v02.dxf · 14 hojas · CORTAR

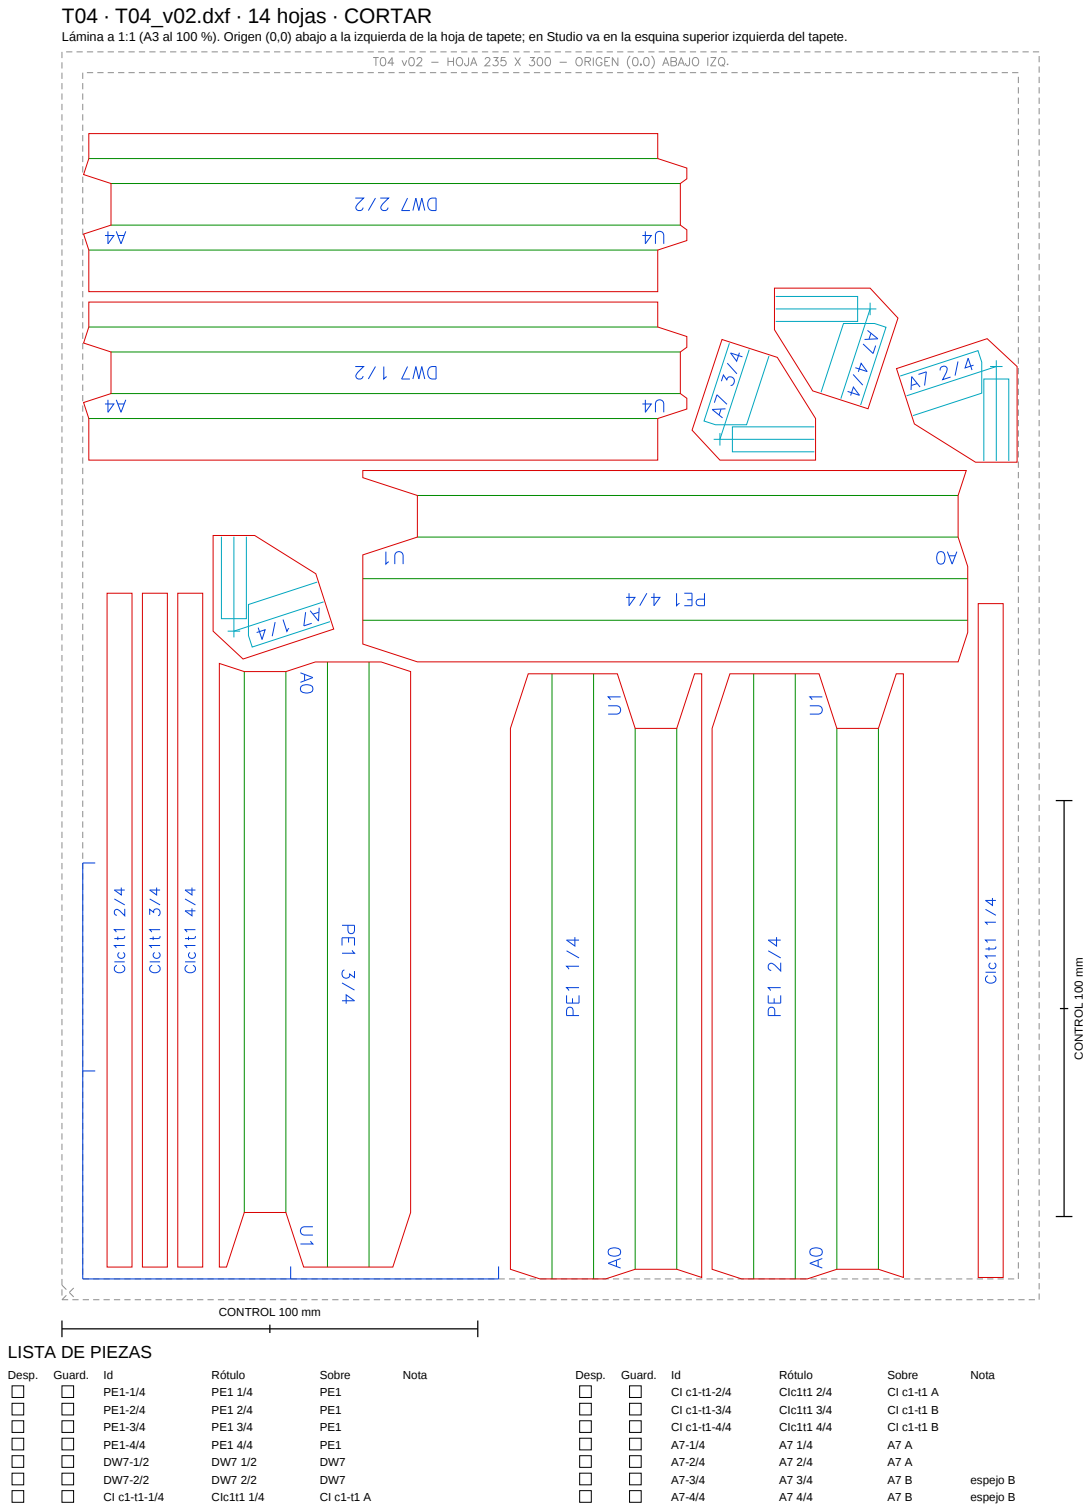
[picture p68: page 6]
CONTROL 100 mm; Desp.; Guard.; Rótulo; Sobre; Nota; CIc1t1 1/4; CIc1t1 2/4; CIc1t1 3/4; CIc1t1 4/4; espejo B

LISTA DE PIEZAS

# T05 · T05_v02.dxf · 22 hojas · CORTAR

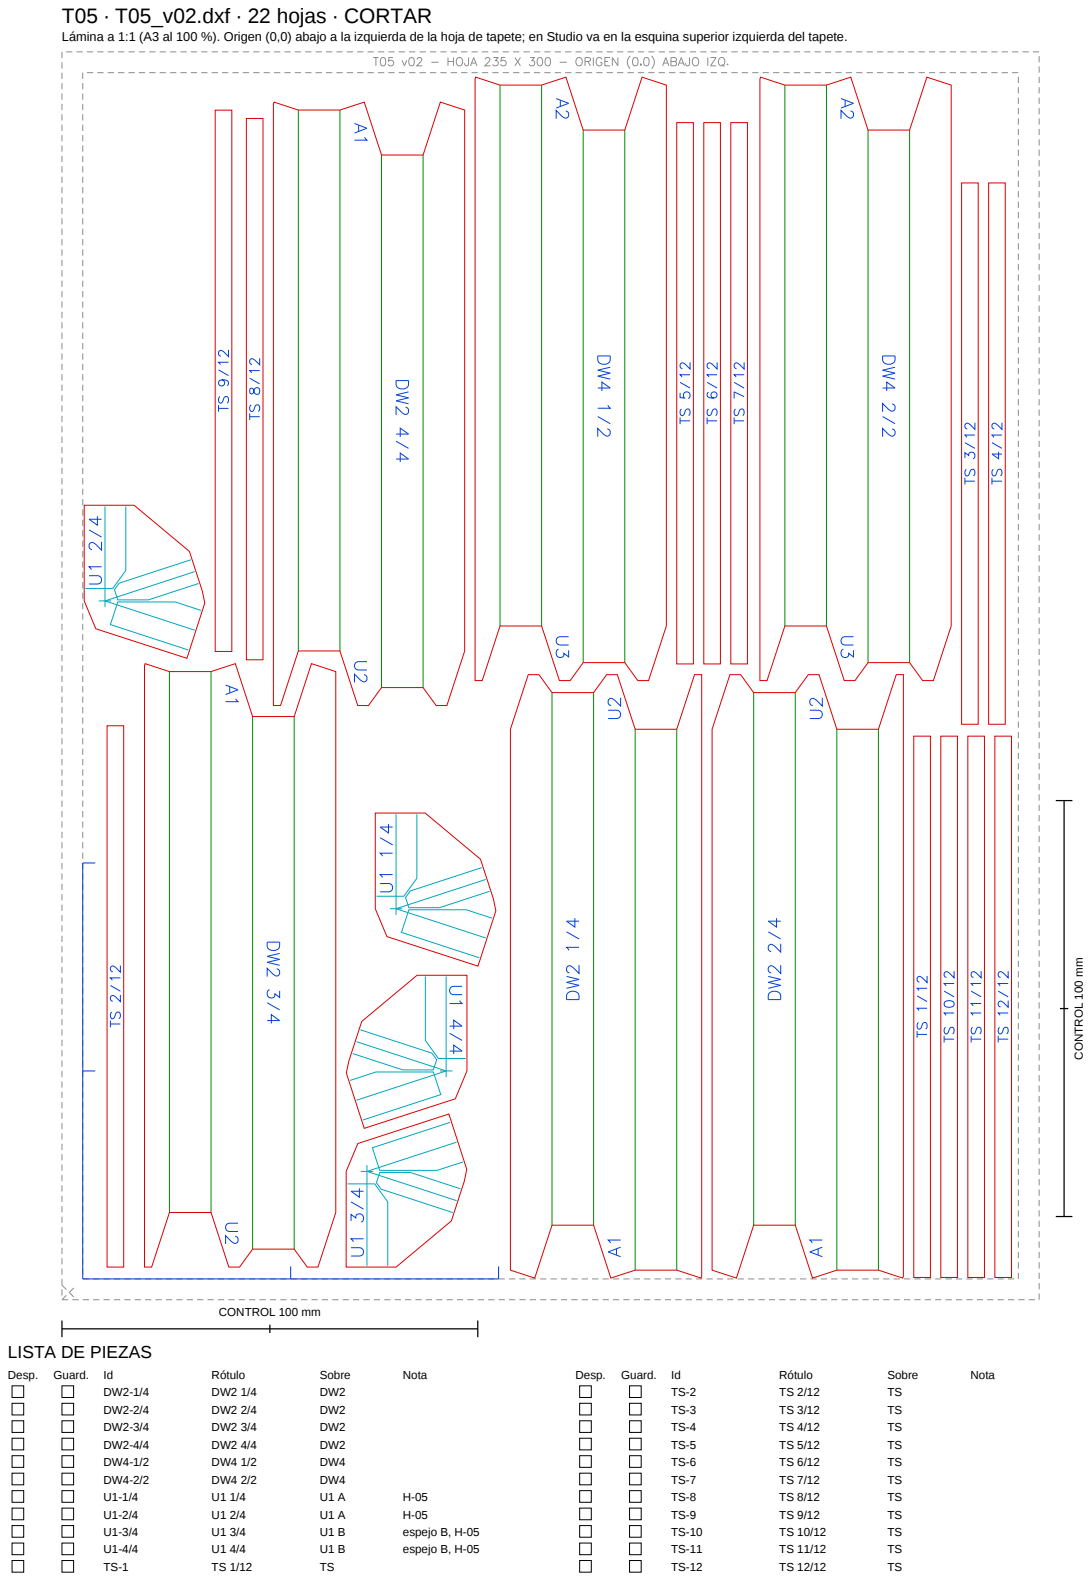
[picture p69: page 7]
CONTROL 100 mm; Desp.; Guard.; Rótulo; Sobre; Nota; espejo B, H-05

LISTA DE PIEZAS

# T06 · T06_v02.dxf · 20 hojas · CORTAR

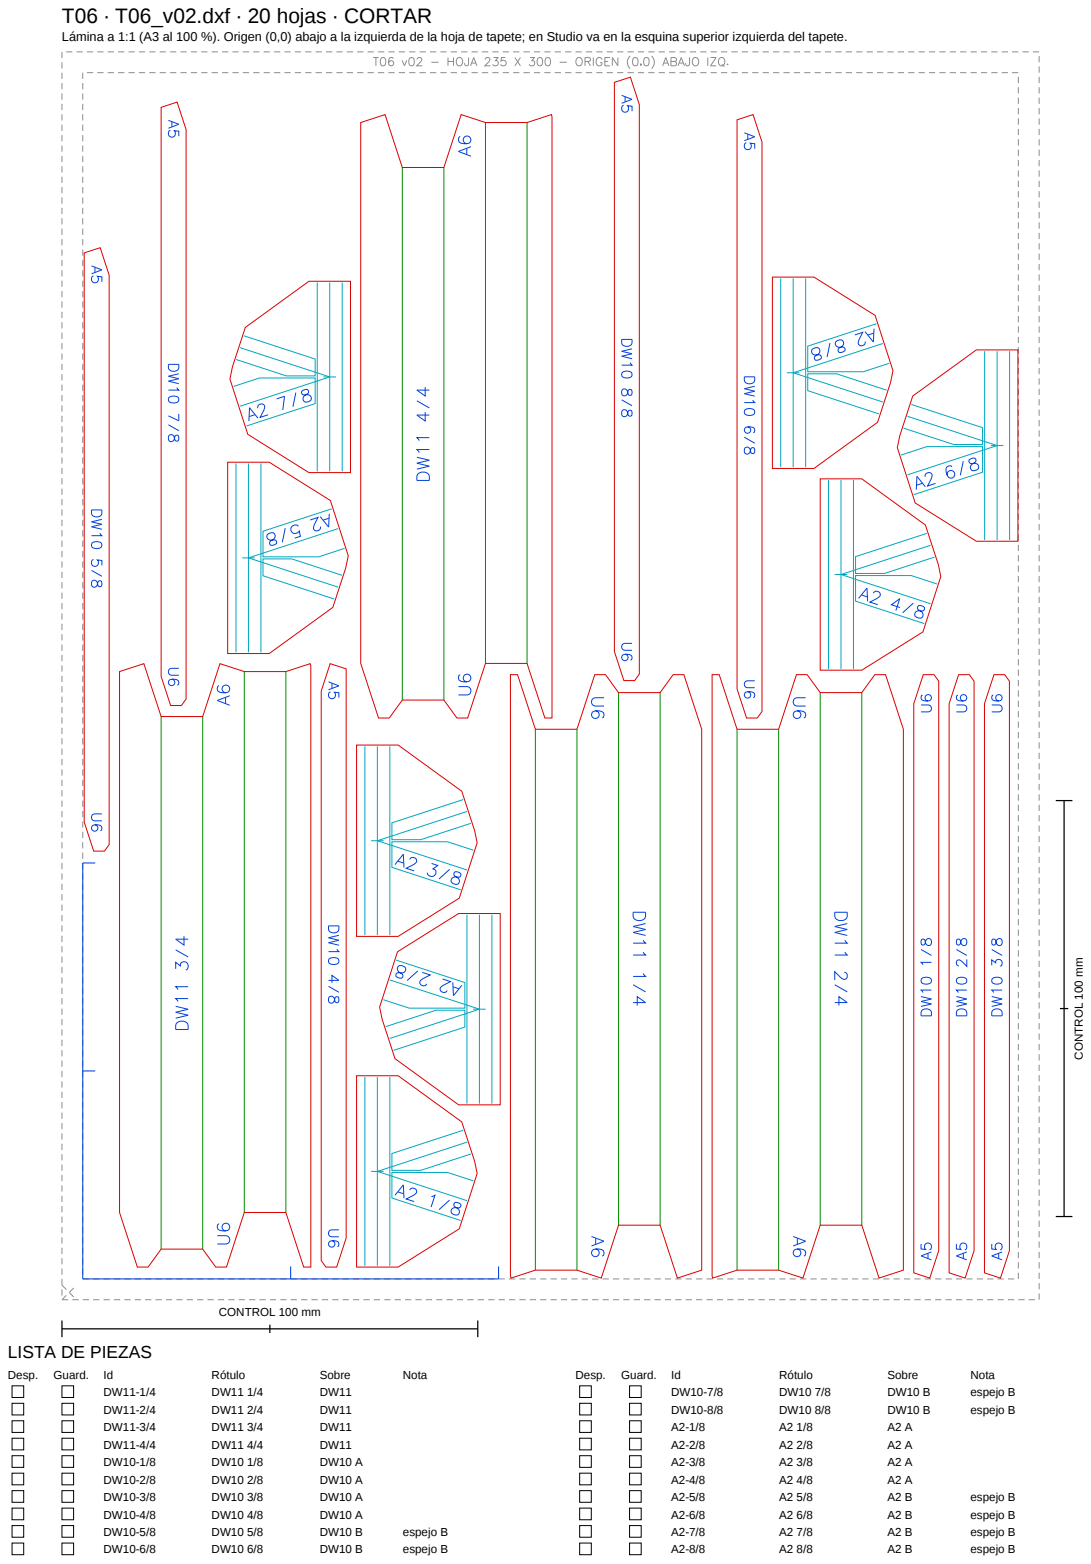
[picture p70: page 8]
CONTROL 100 mm; Desp.; Guard.; Rótulo; Sobre; Nota; espejo B

LISTA DE PIEZAS

# T07 · T07_v02.dxf · 24 hojas · CORTAR

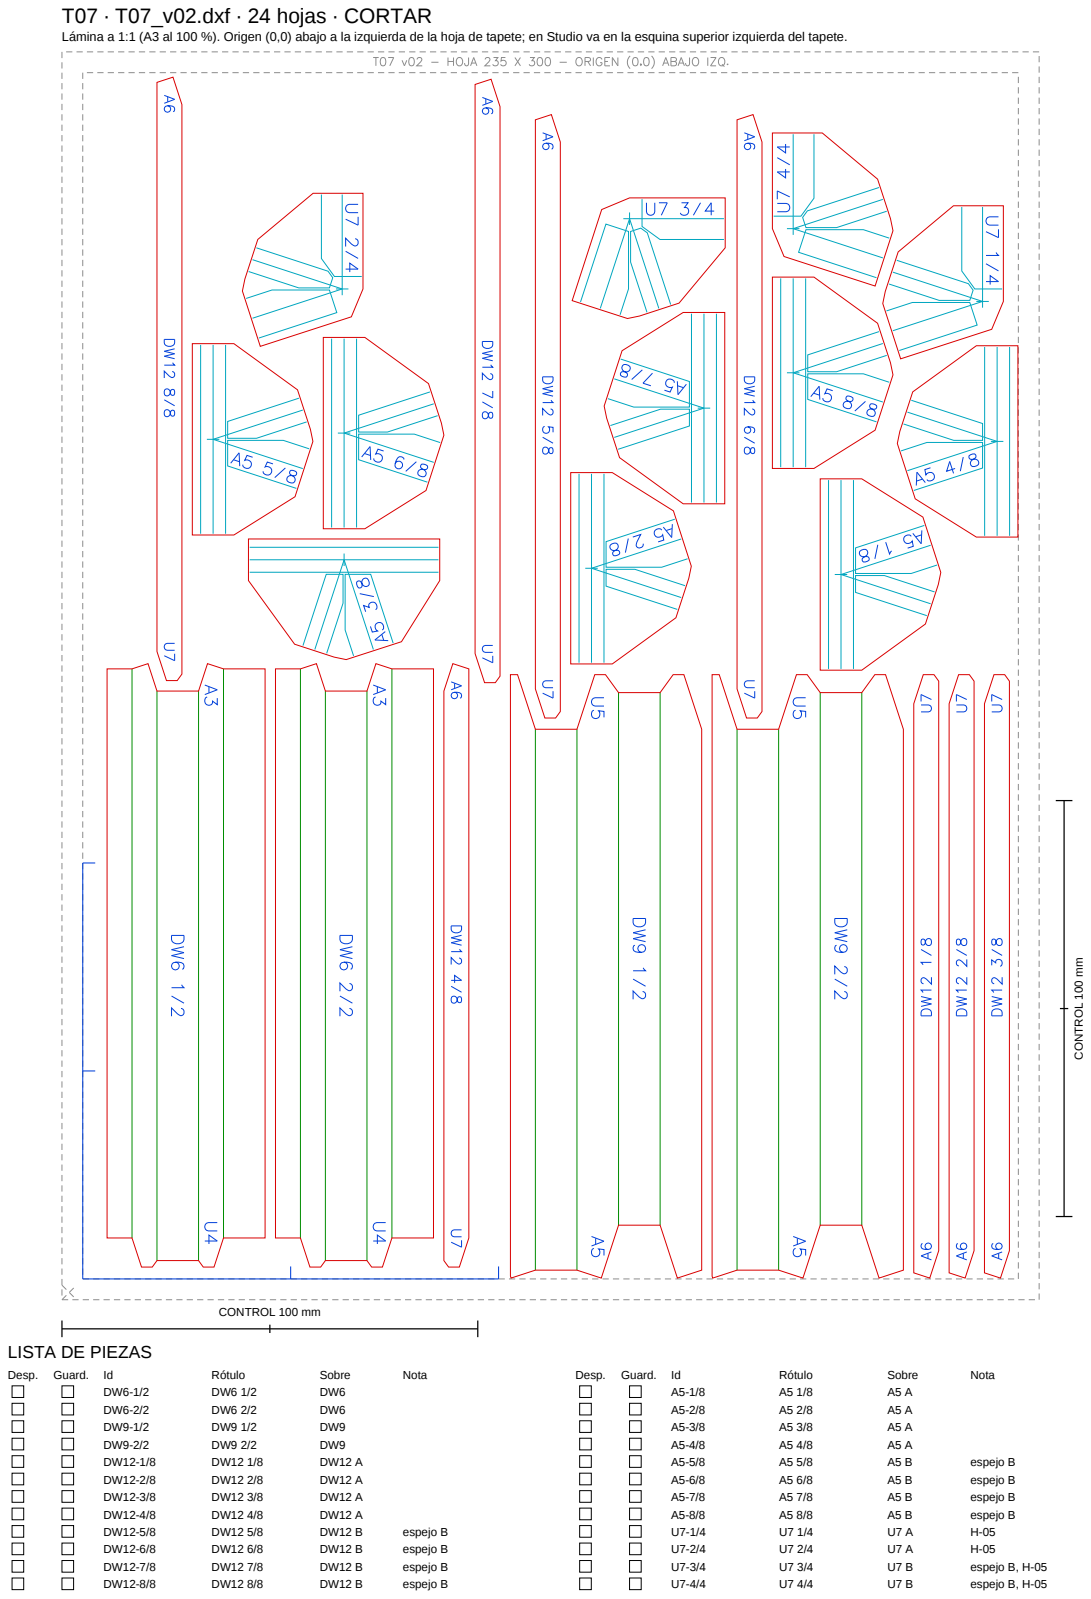
[picture p71: page 9]
CONTROL 100 mm; Desp.; Guard.; Rótulo; Sobre; Nota; espejo B; espejo B, H-05

LISTA DE PIEZAS

# T08 · T08_v02.dxf · 32 hojas · CORTAR

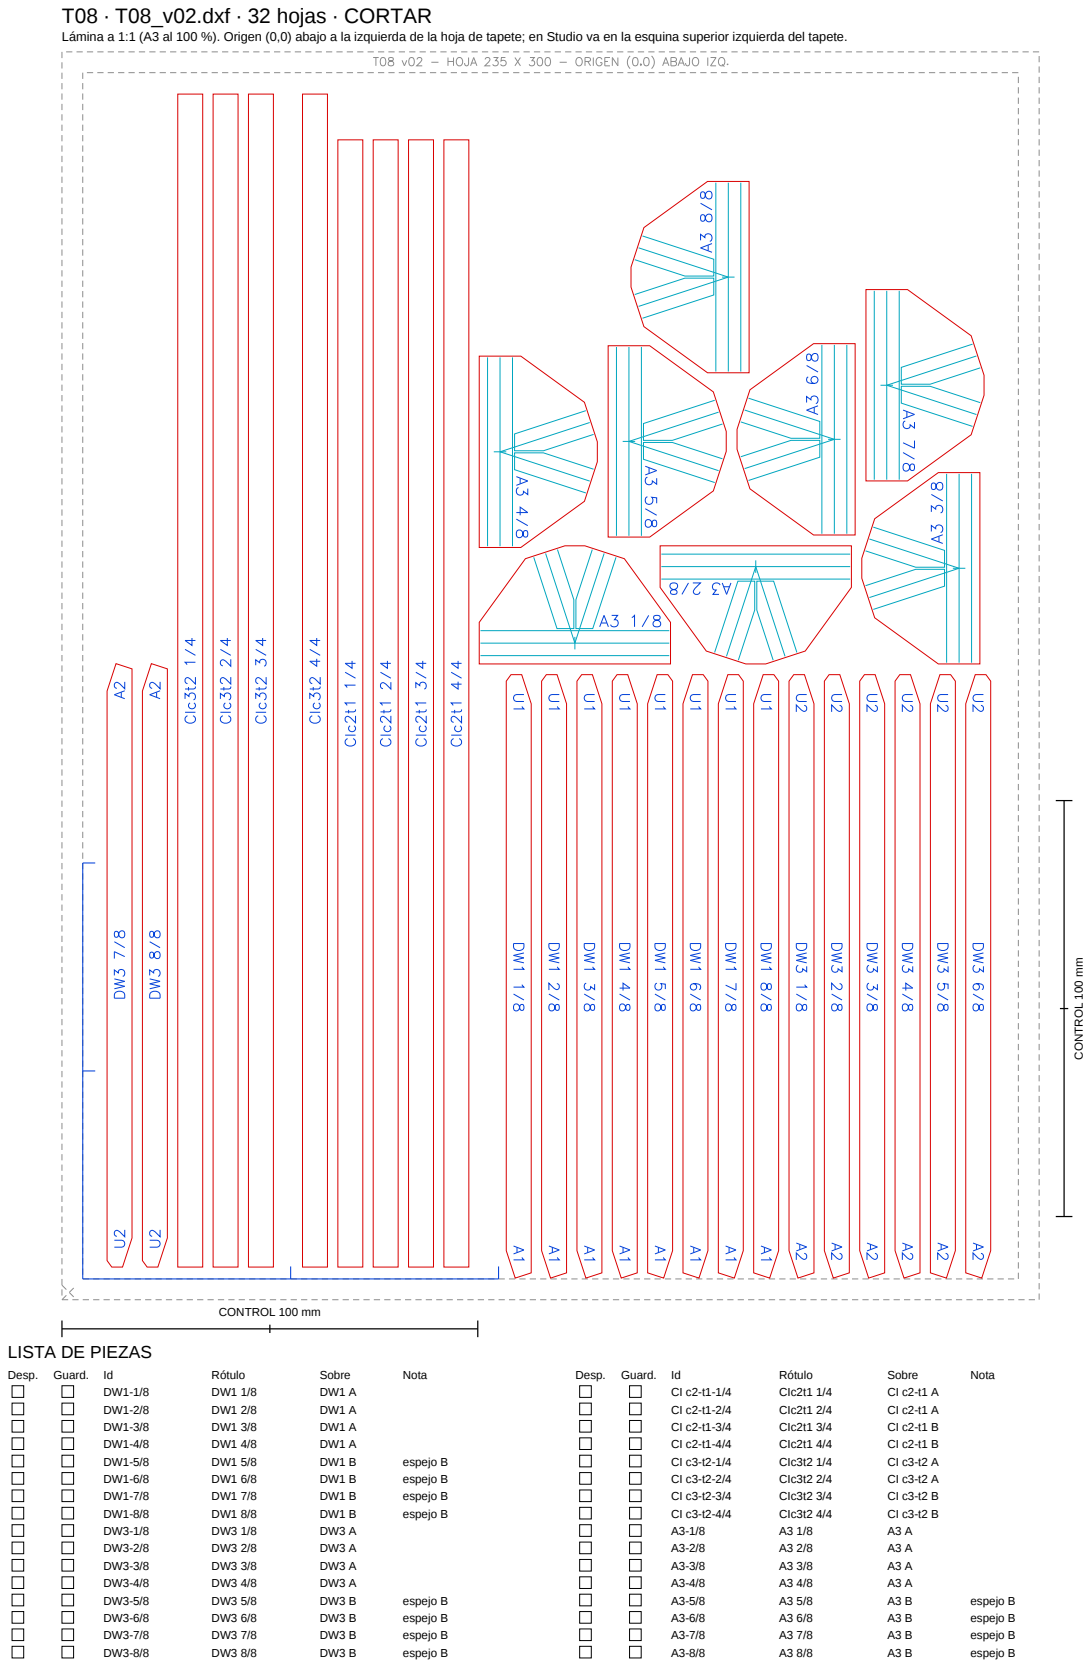
[picture p72: page 10]
CONTROL 100 mm; Desp.; Guard.; Rótulo; Sobre; Nota; espejo B; CIc2t1 1/4; CIc2t1 2/4; CIc2t1 3/4; CIc2t1 4/4; CIc3t2 1/4; CIc3t2 2/4; CIc3t2 3/4; CIc3t2 4/4

LISTA DE PIEZAS

# T09 · T09_v02.dxf · 28 hojas · CORTAR

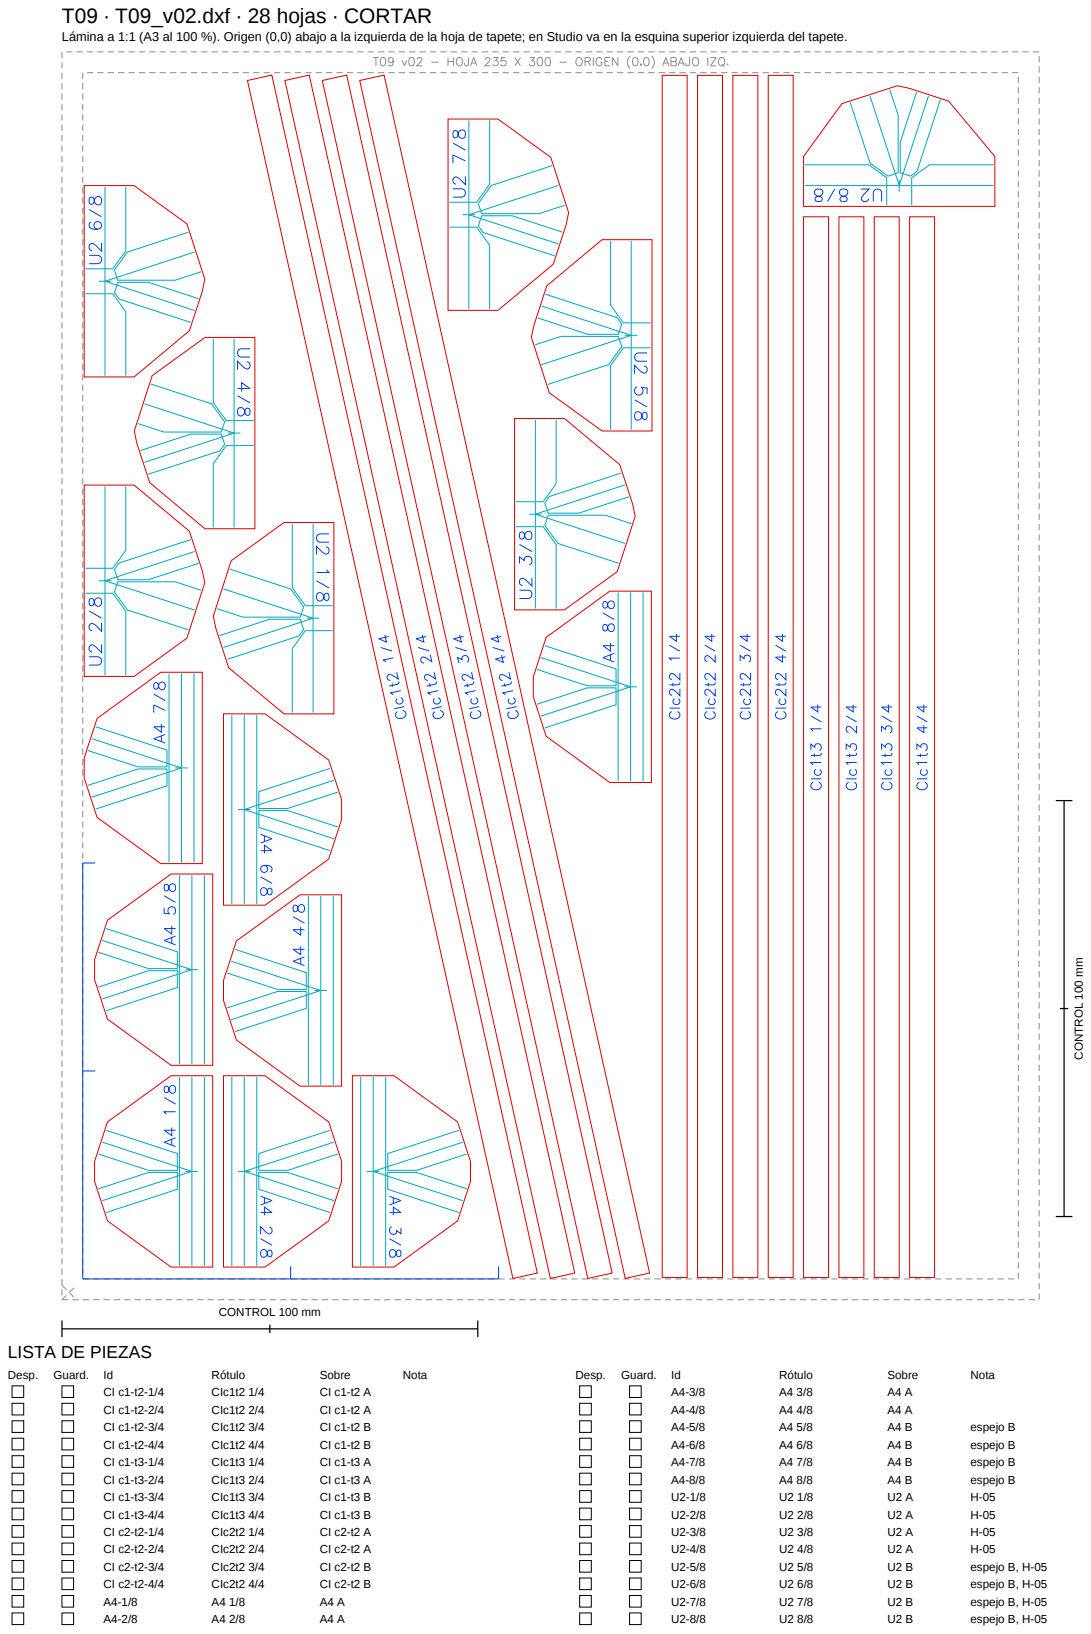
[picture p73: page 11]
CONTROL 100 mm; Desp.; Guard.; Rótulo; Sobre; Nota; CIc1t2 1/4; CIc1t2 2/4; CIc1t2 3/4; CIc1t2 4/4; CIc1t3 1/4; CIc1t3 2/4; CIc1t3 3/4; CIc1t3 4/4; CIc2t2 1/4; CIc2t2 2/4; CIc2t2 3/4; CIc2t2 4/4; espejo B; espejo B, H-05

LISTA DE PIEZAS

# T10 · T10_v02.dxf · 34 hojas · CORTAR

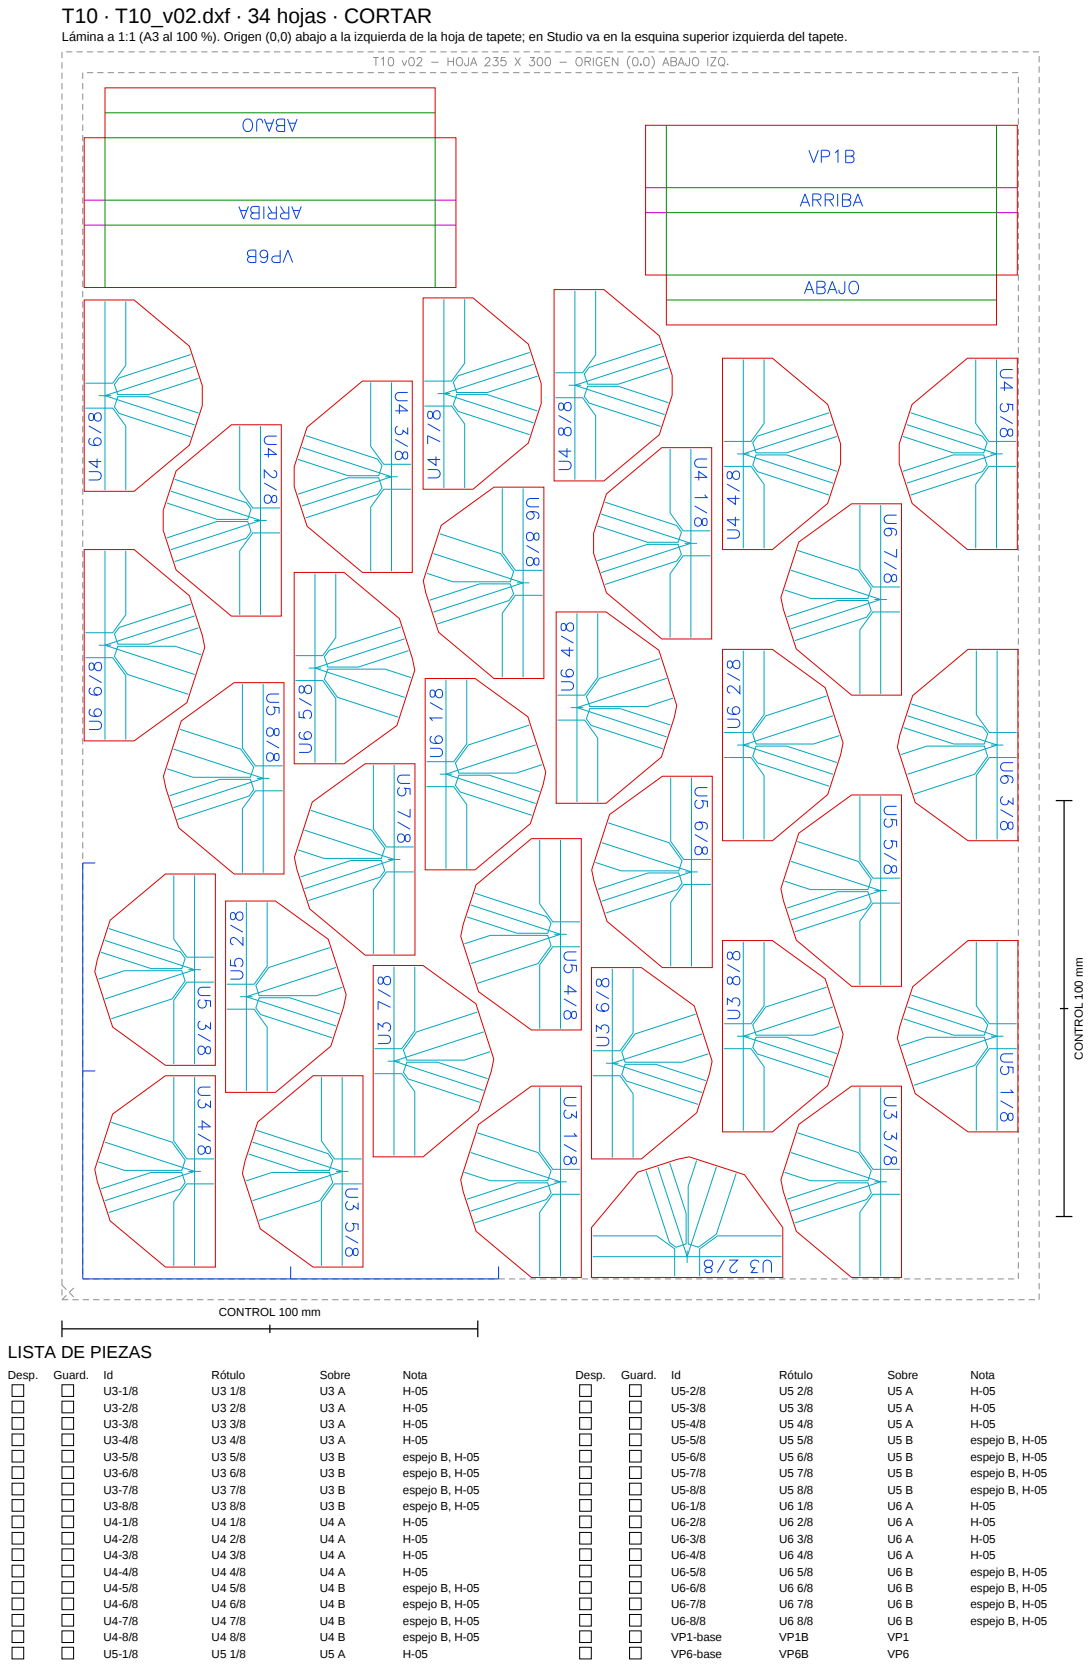
[picture p74: page 12]
CONTROL 100 mm; Desp.; Guard.; Rótulo; Sobre; Nota; espejo B, H-05; VP1-base; VP6-base

LISTA DE PIEZAS

# T11 · T11_v02.dxf · 27 hojas · CORTAR

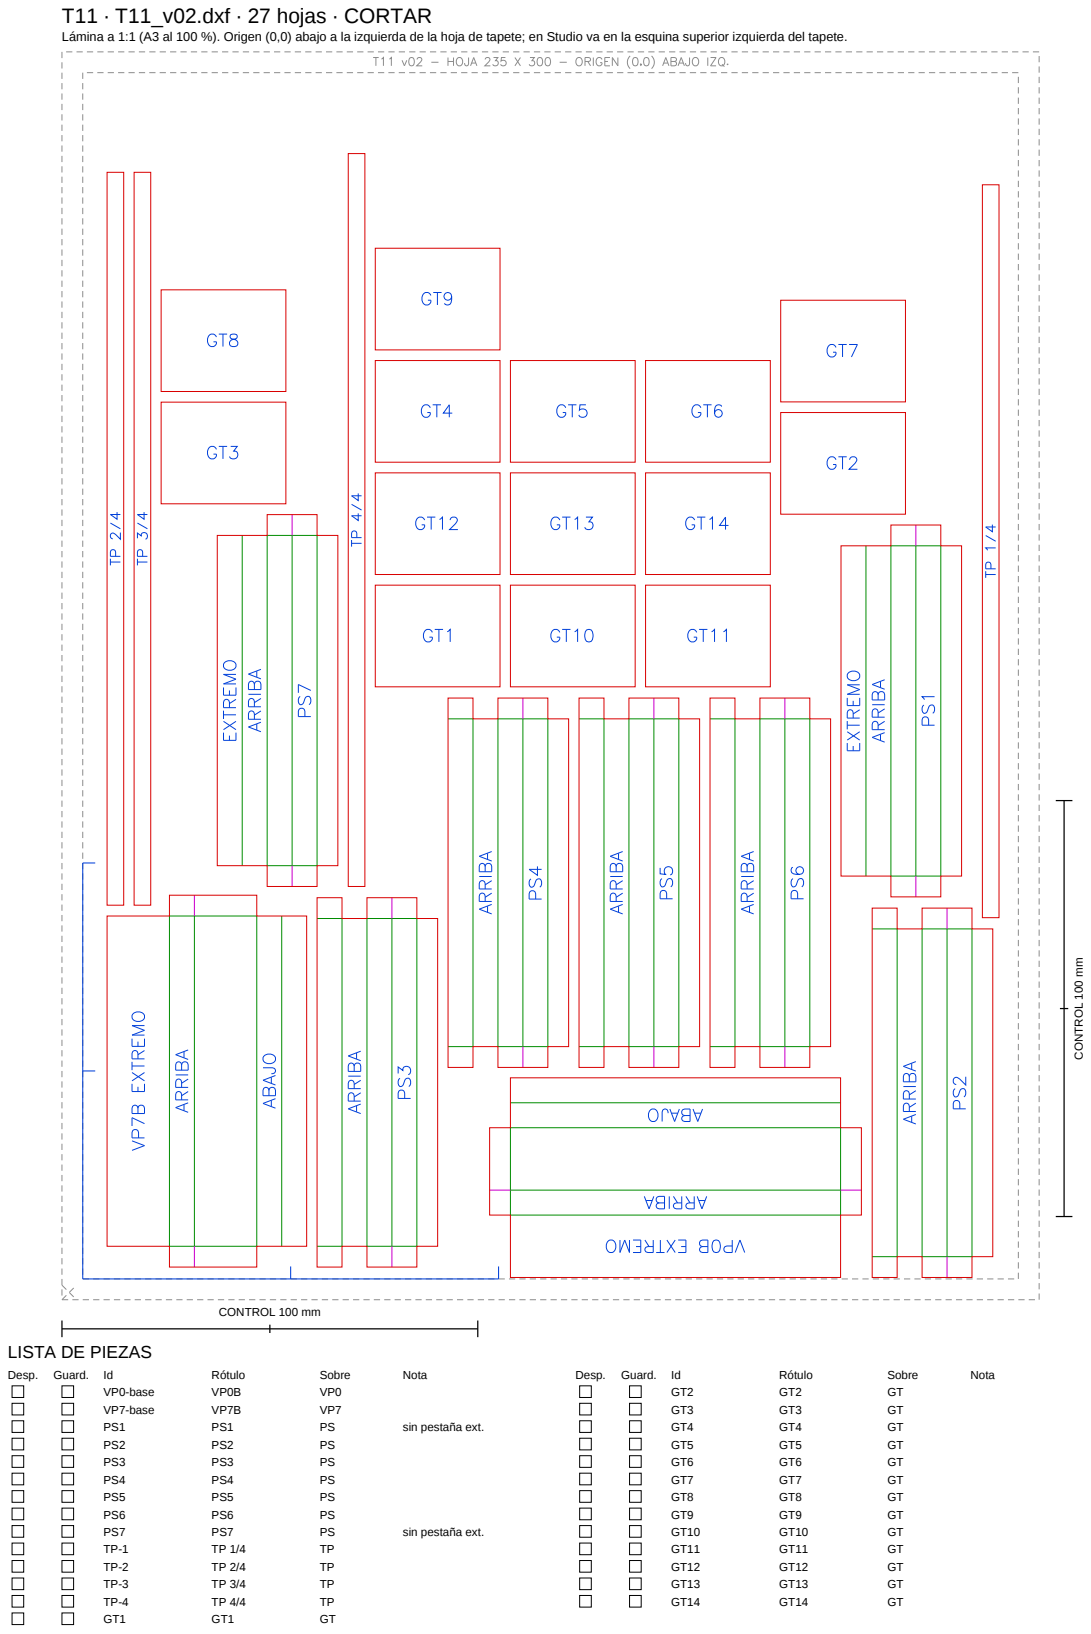
[picture p75: page 13]
CONTROL 100 mm; Desp.; Guard.; Rótulo; Sobre; Nota; VP0-base; VP7-base; sin pestaña ext.

LISTA DE PIEZAS

# T12 · T12_RETENIDO_H01_v02.dxf · 16 hojas · RETENIDO H-01 - NO CORTAR

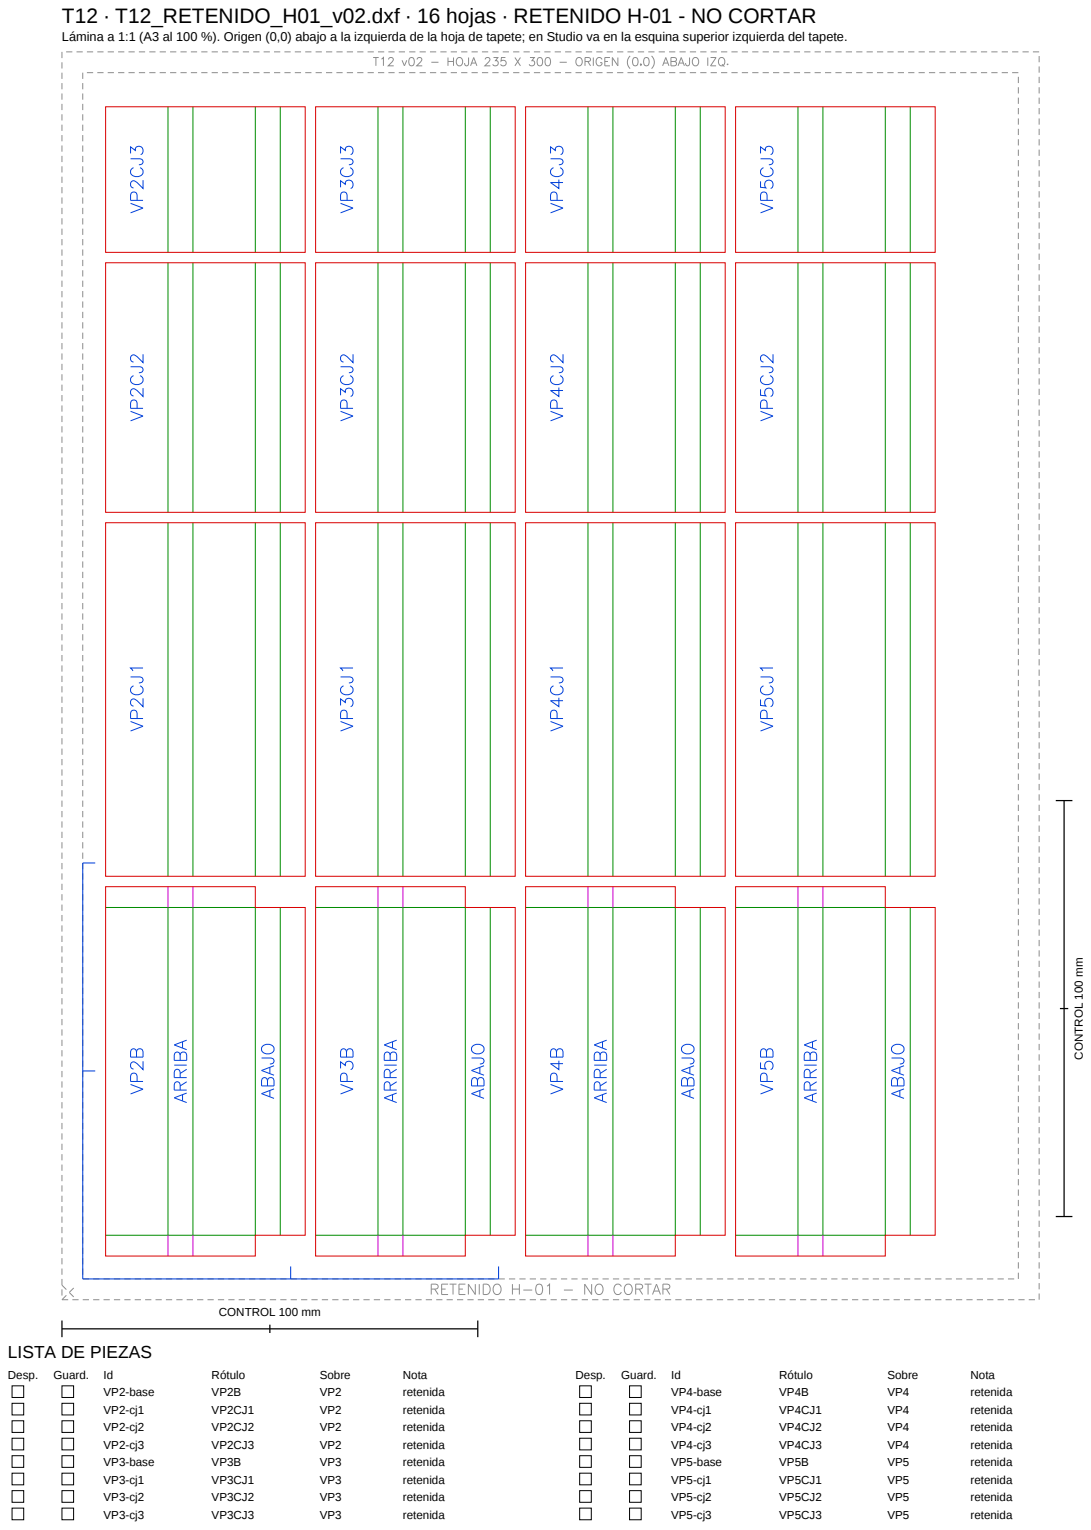
[picture p76: page 14]
CONTROL 100 mm; Desp.; Guard.; Rótulo; Sobre; Nota; VP2-base; retenida; VP3-base; VP4-base; VP5-base

LISTA DE PIEZAS
