adrianix360/Proyecto_mecanica_del_solido_2/00_enunciado_y_referencias/plano_base_semestre_anterior/Planos_Warren_A0_semestre_anterior.pdf

# WARREN - PLANTILLAS GENERALES DE MONTAJE

## IC-0610 | PUENTE DE CARPETAS DE MANILA

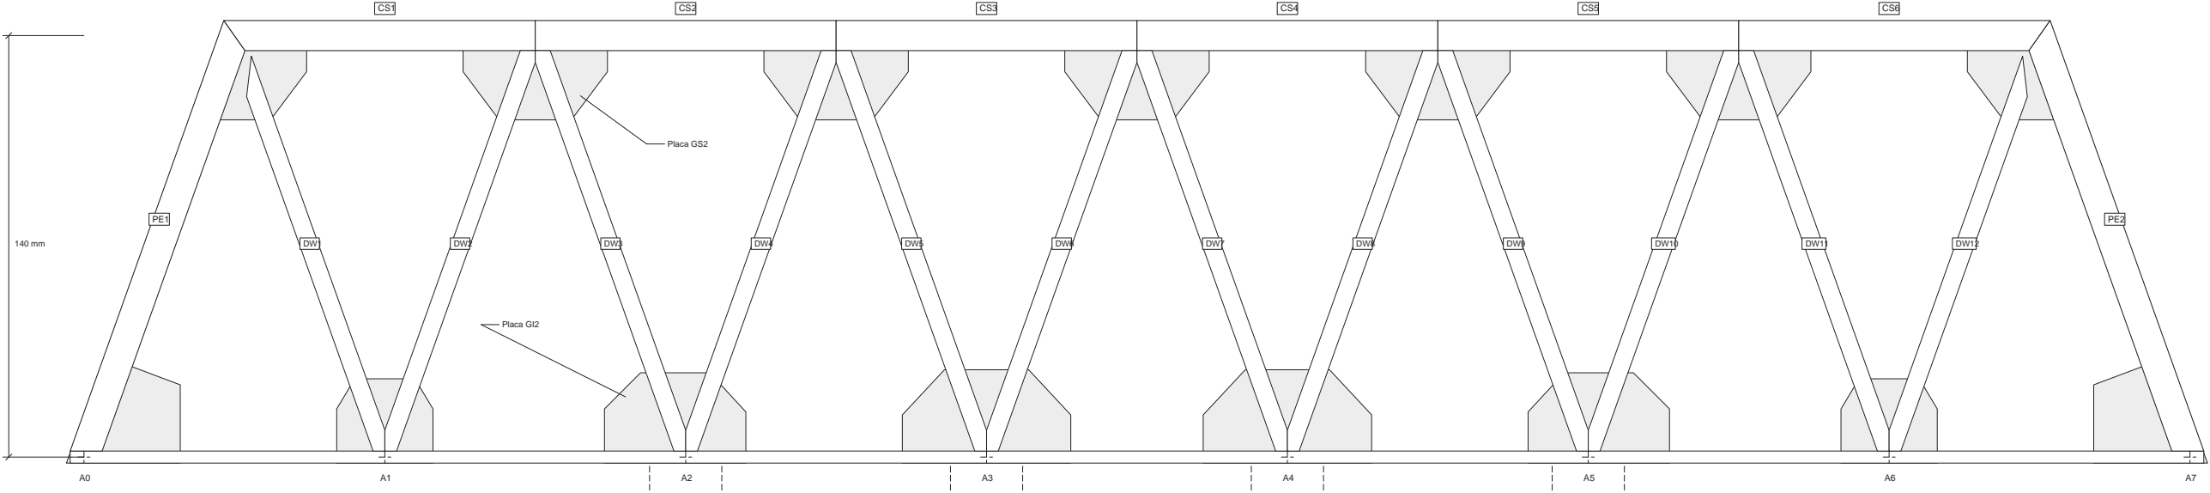
[picture p77: figure]
Placa GI2; Placa GS2
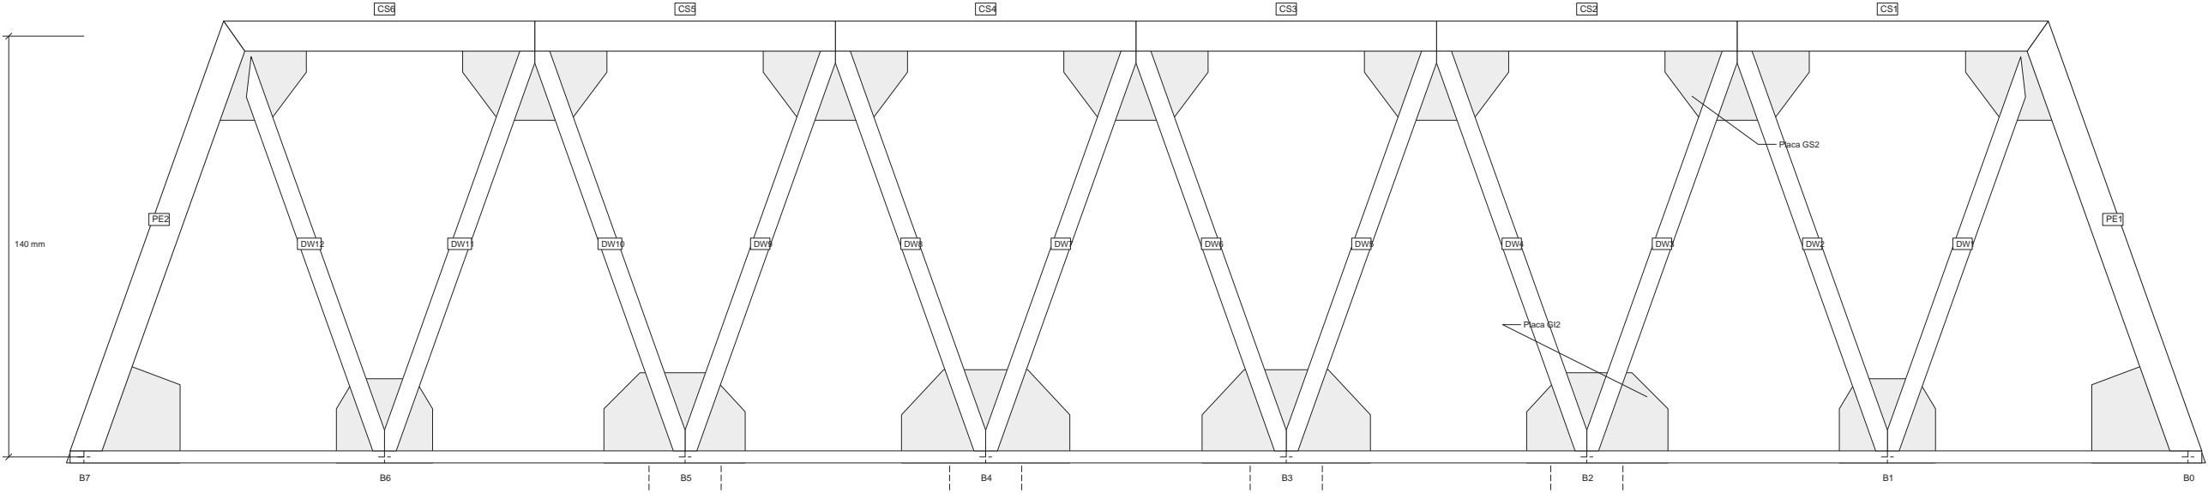
[picture p78: figure]
Placa GI2; Placa GS2
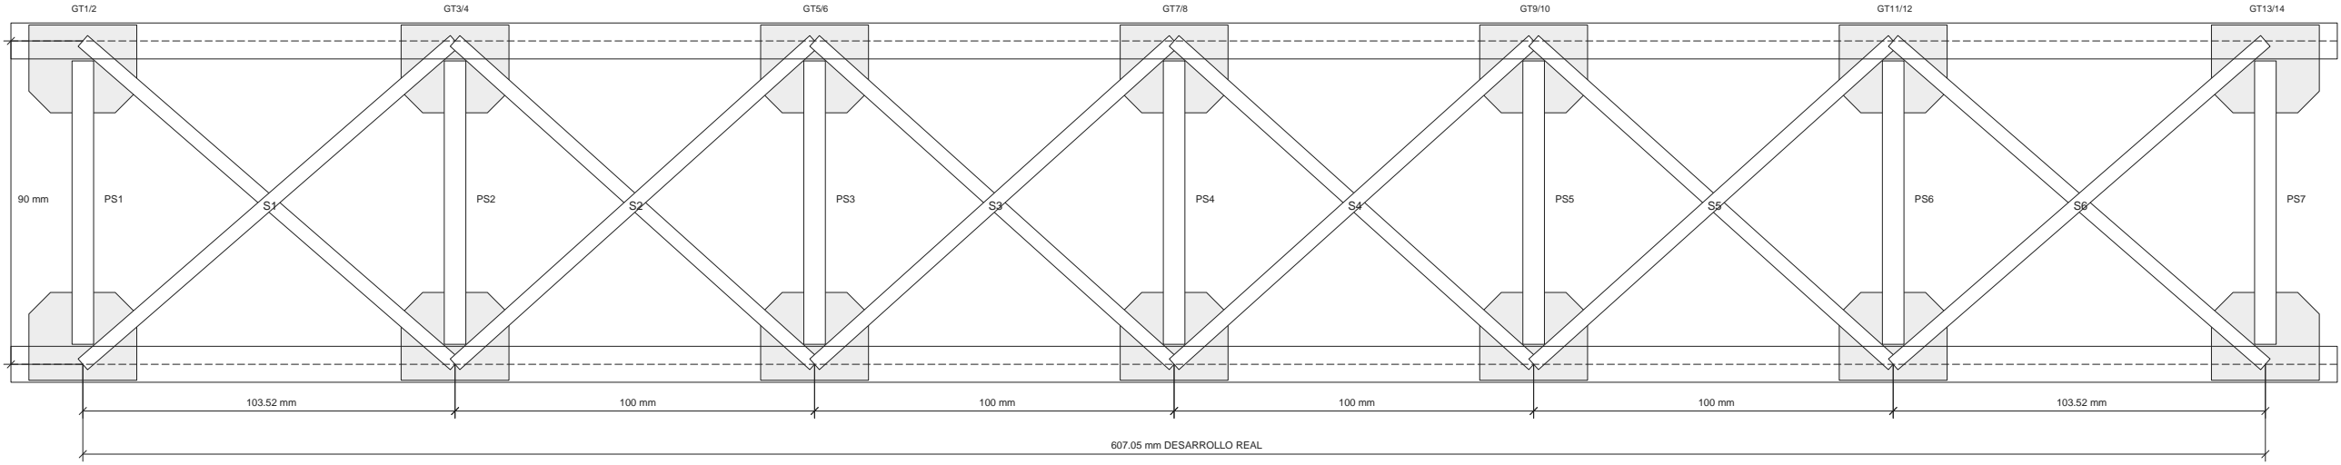
[picture p79: figure]
607.05 mm DESARROLLO REAL

## A0 HORIZONTAL - 1189 × 841 mm - TAMAÑO REAL / 100 % - SIN AJUSTAR

# 01 ELEVACIÓN LATERAL A - CARA EXTERIOR

DW1 | DW2 | DW3 | DW4 | DW5 | DW6 | DW7 | DW8 | DW9 | DW10 | DW11 | DW12
U1 | U2 | U3 | U4 | U5 | U6 | U7
CI1 (doble) | CI2 (doble) | CI3 (doble) | CI4 (doble) | CI5 (doble)
100 mm | 100 mm | 100 mm | 100 mm | 100 mm | 100 mm | 100 mm

### 700 mm ENTRE EJES DE APOYO

# 02 ELEVACIÓN LATERAL B - CARA EXTERIOR

DW12 | DW11 | DW10 | DW9 | DW8 | DW7 | DW6 | DW5 | DW4 | DW3 | DW2 | DW1
V7 | V6 | V5 | V4 | V3 | V2 | V1
CI5 (doble) | CI4 (doble) | CI3 (doble) | CI2 (doble) | CI1 (doble)
100 mm | 100 mm | 100 mm | 100 mm | 100 mm | 100 mm | 100 mm

### 700 mm ENTRE EJES DE APOYO

# 03 PLANTA - VISTA SUPERIOR

VP0 | VP1 | VP2 | VP3 | VP4 | VP5 | VP6 | VP7
PS1 | PS2 | PS3 | PS4 | PS5 | PS6 | PS7

700 mm

### 90 mm ENTRE PLANOS MEDIOS

# 04 TECHO DESPLEGADO - VERDADERA MAGNITUD

R1

R2

R3

R4

R5

R6

R7

Bordes del tubo representados; las placas quedan dentro de su ancho.

Cubierta representada en verdadera magnitud. Paños centrales sobre cuerdas horizontales.

## Las placas de los extremos se pliegan

en el encuentro con los postes inclinados.
Las diagonales cruzadas son independientes. Puntales de 6 × 6 mm; diagonales de 4 mm. Pestañas superiores replegadas al interior; las restantes se abren hacia las cartelas.

# 05 DETALLES DE ENCUENTRO

Referencia de cuerda inferior y cartela - 1:1 | Apoyo extremo (parcial) - 1:1 10.62 mm

VIGA DE PISO: cuerpo a 10,5 mm; pestaña inferior al ras.

## PUNTALES SUPERIORES - EXTREMOS CON PESTAÑAS

5 mm | 5 mm
Pestañas laterales e inferior: apertura exterior.

Pestaña superior: repliegue interior de 5 mm.

La cara superior queda libre para la placa del techo.

# 06 PÓRTICO - VERDADERA MAGNITUD

90 mm

151.85 mm | TP: 176.51 mm

## Arriostramiento en el plano inclinado

de cada par de postes extremos. Tiras TP de 4 mm, cruzadas.
Unión sobre placas de apoyo y techo. Vista en verdadera magnitud.

# 07 SECCIONES Y PEGADO

10 mm

10 mm

## Cuerda y poste: tubo de 10 × 10 mm

## Diagonal del alma: tubo de 6 × 10 mm

## Viga de piso: tubo de 15 × 6 mm

## Puntal de techo: tubo de 6 × 6 mm

Cuerda inferior: tiras de 4 mm en ambas caras. Arriostramientos: tiras simples de 4 mm. Pestañas extremas de vigas y puntales: 5 mm.

# 08 EMPALMES Y CLAVES

24 mm

Cuerda inferior en cinco tramos simétricos. Solapes de 24 mm sobre cartelas. Uniones en 200, 300, 400 y 500 mm. Disposición repetida en ambas caras.

GI / GS: placas inferiores y superiores.
GT: placas de techo. PE: postes extremos. CI / CS: cuerdas inferior y superior.
DW: diagonales tubulares. VP: vigas de piso. PS: puntales. TS / TP: arriostramientos.

### CONTROL HORIZONTAL: 100 mm

### CONTROL VERTICAL

100 mm

# PROYECTO DEL PUENTE

# MODELO WARREN

## LÁMINA: WA-01 | Montaje y detalles

FECHA: ____________________ | ESCALA: 1:1
Firma 1 | Firma 2
Firma 3 | Firma 4
Firma 5 | Firma 6

# WARREN - DESPIECE DE CORTE Y PLEGADO

## IC-0610 | PUENTE DE CARPETAS DE MANILA

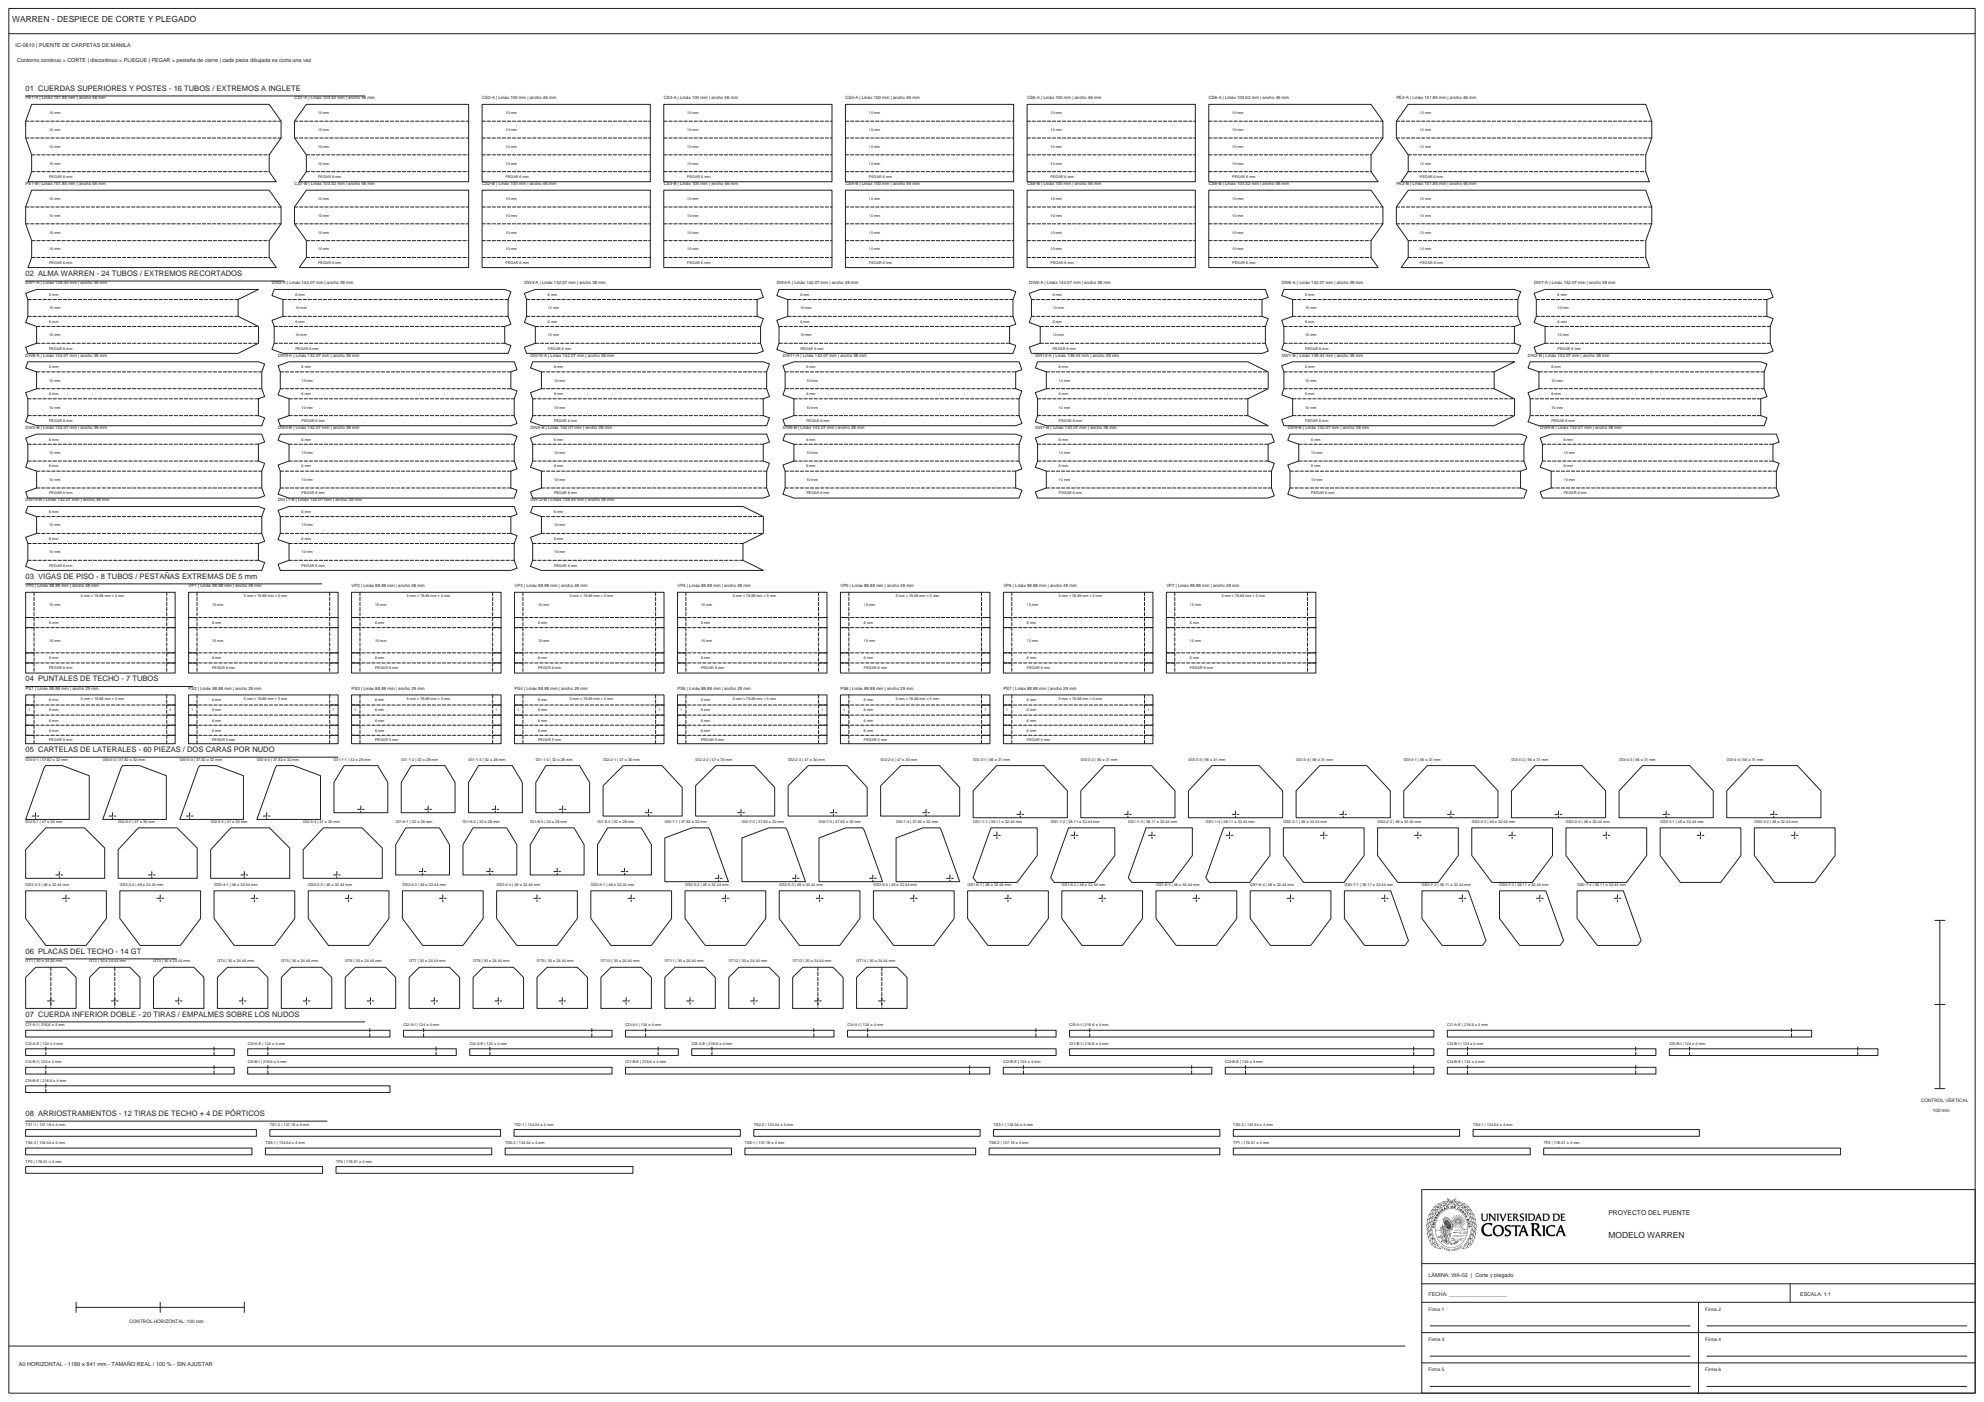
[picture p80: page 2]
PEGAR 6 mm; PEGAR 5 mm; CONTROL VERTICAL; MODELO WARREN; FECHA: ____________________; ESCALA: 1:1; Firma 1; Firma 2; Firma 3; Firma 4; Firma 5; Firma 6

Contorno continuo = CORTE | discontinuo = PLIEGUE | PEGAR = pestaña de cierre | cada pieza dibujada se corta una vez

01 CUERDAS SUPERIORES Y POSTES - 16 TUBOS / EXTREMOS A INGLETE

PE1-A | Lmáx 151.85 mm | ancho 46 mm

CS1-A | Lmáx 103.52 mm | ancho 46 mm

CS2-A | Lmáx 100 mm | ancho 46 mm

CS3-A | Lmáx 100 mm | ancho 46 mm

CS4-A | Lmáx 100 mm | ancho 46 mm

CS5-A | Lmáx 100 mm | ancho 46 mm

CS6-A | Lmáx 103.52 mm | ancho 46 mm

PE2-A | Lmáx 151.85 mm | ancho 46 mm

PE1-B | Lmáx 151.85 mm | ancho 46 mm

CS1-B | Lmáx 103.52 mm | ancho 46 mm

CS2-B | Lmáx 100 mm | ancho 46 mm

CS3-B | Lmáx 100 mm | ancho 46 mm

CS4-B | Lmáx 100 mm | ancho 46 mm

CS5-B | Lmáx 100 mm | ancho 46 mm

CS6-B | Lmáx 103.52 mm | ancho 46 mm

PE2-B | Lmáx 151.85 mm | ancho 46 mm

PEGAR 6 mm
02 ALMA WARREN - 24 TUBOS / EXTREMOS RECORTADOS

DW1-A | Lmáx 138.44 mm | ancho 38 mm

DW2-A | Lmáx 142.07 mm | ancho 38 mm

DW3-A | Lmáx 142.07 mm | ancho 38 mm

DW4-A | Lmáx 142.07 mm | ancho 38 mm

DW5-A | Lmáx 142.07 mm | ancho 38 mm

DW6-A | Lmáx 142.07 mm | ancho 38 mm

DW7-A | Lmáx 142.07 mm | ancho 38 mm

DW8-A | Lmáx 142.07 mm | ancho 38 mm

DW9-A | Lmáx 142.07 mm | ancho 38 mm

DW10-A | Lmáx 142.07 mm | ancho 38 mm

DW11-A | Lmáx 142.07 mm | ancho 38 mm

DW12-A | Lmáx 138.44 mm | ancho 38 mm

DW1-B | Lmáx 138.44 mm | ancho 38 mm

DW2-B | Lmáx 142.07 mm | ancho 38 mm

DW9-B | Lmáx 142.07 mm | ancho 38 mm

DW3-B | Lmáx 142.07 mm | ancho 38 mm

DW4-B | Lmáx 142.07 mm | ancho 38 mm

DW5-B | Lmáx 142.07 mm | ancho 38 mm

DW6-B | Lmáx 142.07 mm | ancho 38 mm

DW7-B | Lmáx 142.07 mm | ancho 38 mm

DW8-B | Lmáx 142.07 mm | ancho 38 mm

DW10-B | Lmáx 142.07 mm | ancho 38 mm

DW11-B | Lmáx 142.07 mm | ancho 38 mm

DW12-B | Lmáx 138.44 mm | ancho 38 mm

03 VIGAS DE PISO - 8 TUBOS / PESTAÑAS EXTREMAS DE 5 mm

VP0 | Lmáx 88.88 mm | ancho 48 mm

VP1 | Lmáx 88.88 mm | ancho 48 mm

VP2 | Lmáx 88.88 mm | ancho 48 mm

VP3 | Lmáx 88.88 mm | ancho 48 mm

VP4 | Lmáx 88.88 mm | ancho 48 mm

VP5 | Lmáx 88.88 mm | ancho 48 mm

VP6 | Lmáx 88.88 mm | ancho 48 mm

VP7 | Lmáx 88.88 mm | ancho 48 mm

04 PUNTALES DE TECHO - 7 TUBOS

PS1 | Lmáx 88.88 mm | ancho 29 mm

PS2 | Lmáx 88.88 mm | ancho 29 mm

PS3 | Lmáx 88.88 mm | ancho 29 mm

PS4 | Lmáx 88.88 mm | ancho 29 mm

PS5 | Lmáx 88.88 mm | ancho 29 mm

PS6 | Lmáx 88.88 mm | ancho 29 mm

PS7 | Lmáx 88.88 mm | ancho 29 mm

05 CARTELAS DE LATERALES - 60 PIEZAS / DOS CARAS POR NUDO

06 PLACAS DEL TECHO - 14 GT

07 CUERDA INFERIOR DOBLE - 20 TIRAS / EMPALMES SOBRE LOS NUDOS

08 ARRIOSTRAMIENTOS - 12 TIRAS DE TECHO + 4 DE PÓRTICOS

PROYECTO DEL PUENTE

LÁMINA: WA-02 | Corte y plegado

CONTROL HORIZONTAL: 100 mm

A0 HORIZONTAL - 1189 × 841 mm - TAMAÑO REAL / 100 % - SIN AJUSTAR
