adrianix360/Proyecto_mecanica_del_solido_2/02_analisis_estructural/Analisis_de_nodos_a_mano.pdf

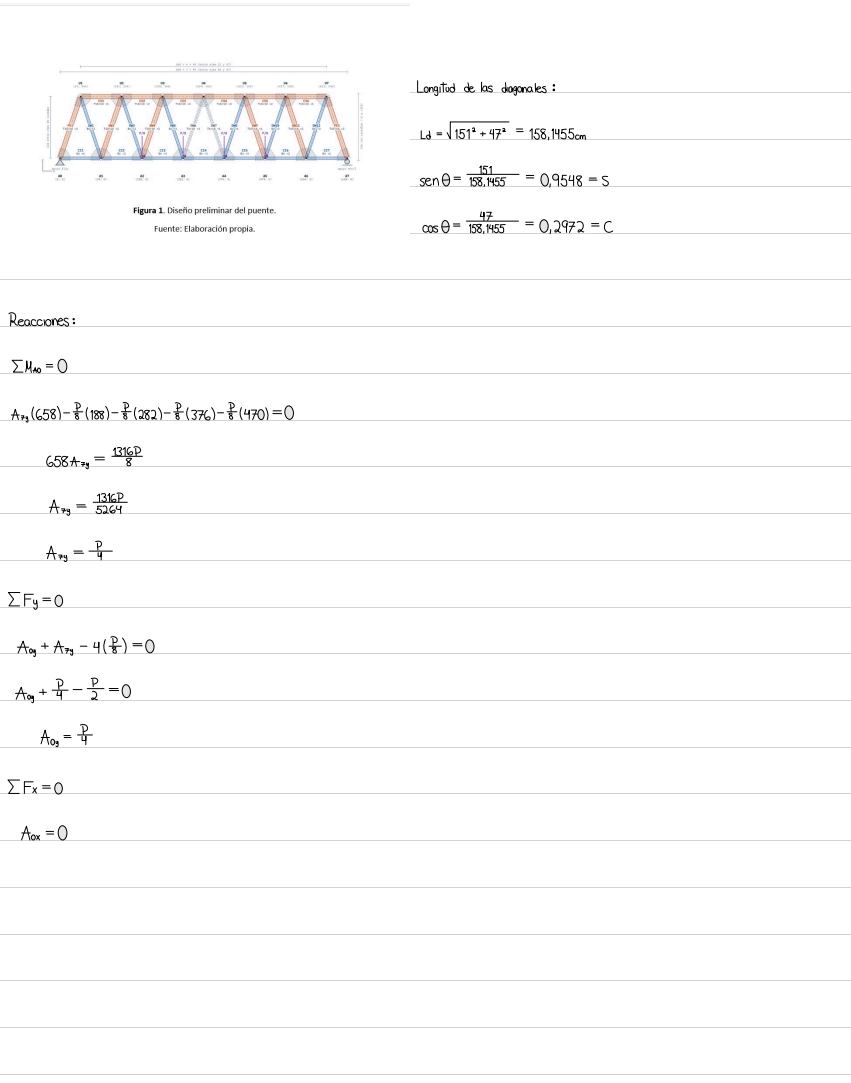
[picture p81: page 1]
ngitud de; diag nales :; sen; Reacciones :

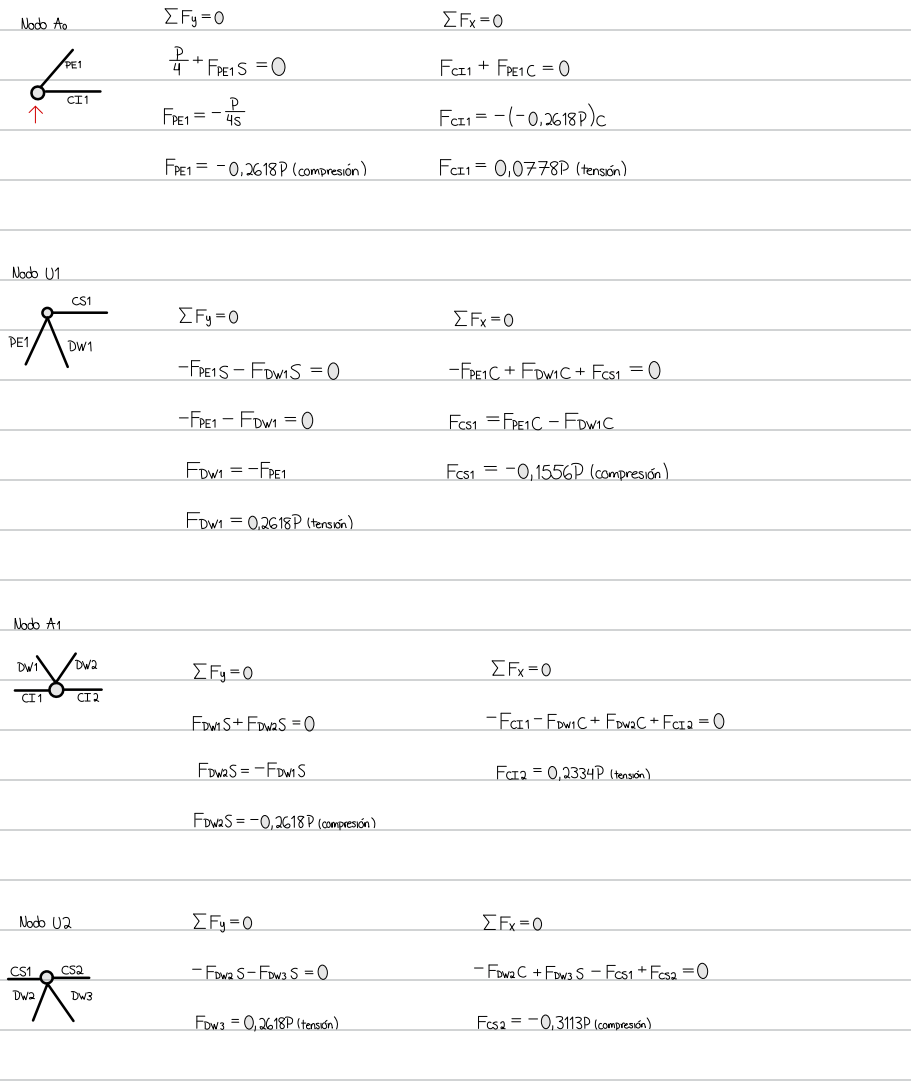
[picture p82: page 2]
Nodo; , 26 84 compresin; 18P Hension; Nodo j; PCDC; 556D /compression; , 26 &P Hension; DaS; 233 Pitension; , 26 84 (compression; Nodo U2; DaC; , 26 SPItension; , 3 34 compression

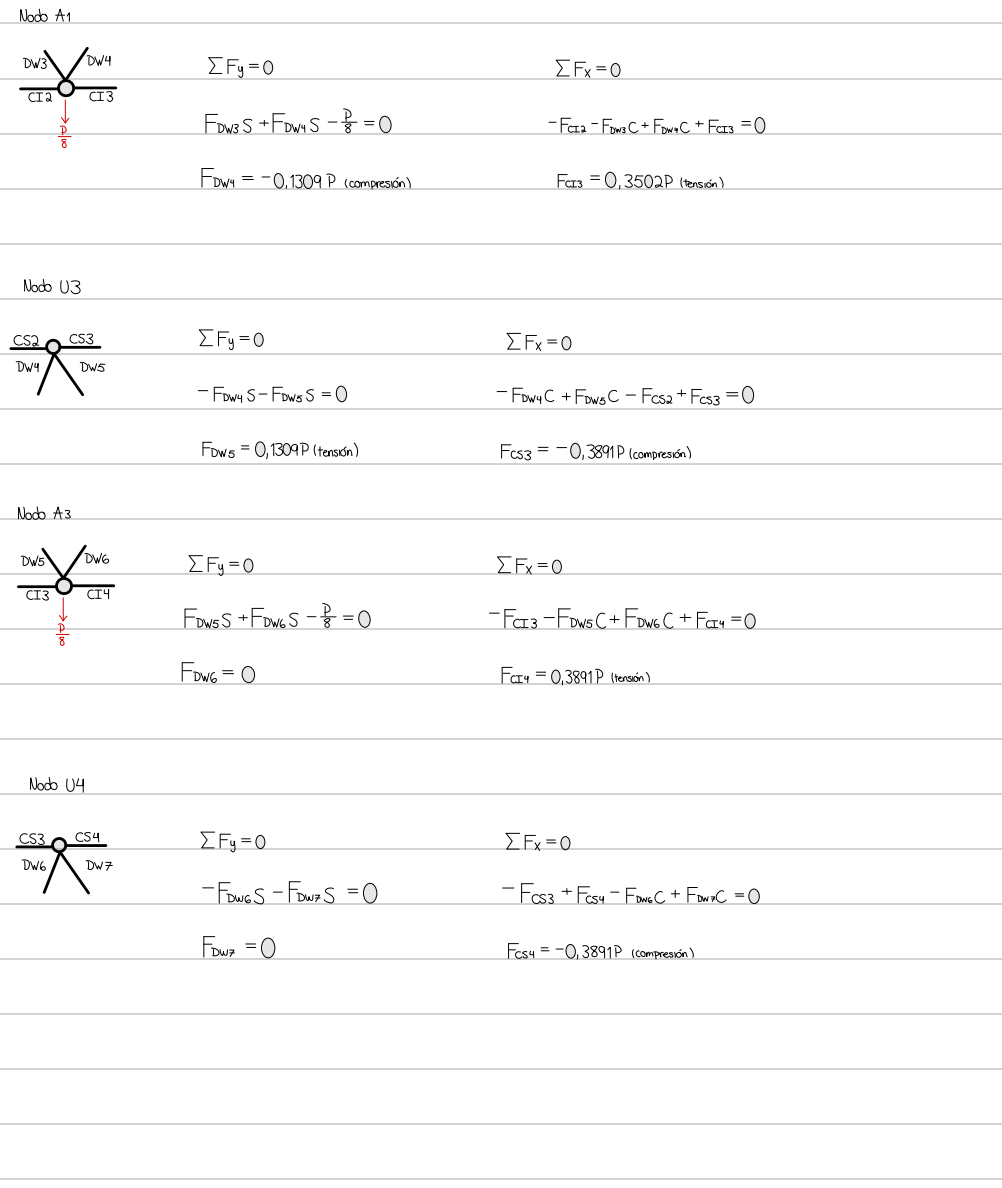
[picture p83: page 3]
Nodo; DaS; DuC; 3 9P (compression; 35 2P Itension); Nodo U3; Dy2D5CCS2; 39PHtension; , 389P (compression; D55DSB; DSC; CTY 3I; , 3894 Hension); Nodo j; DWGS; csy; DoCC; , 389 Pcompression)

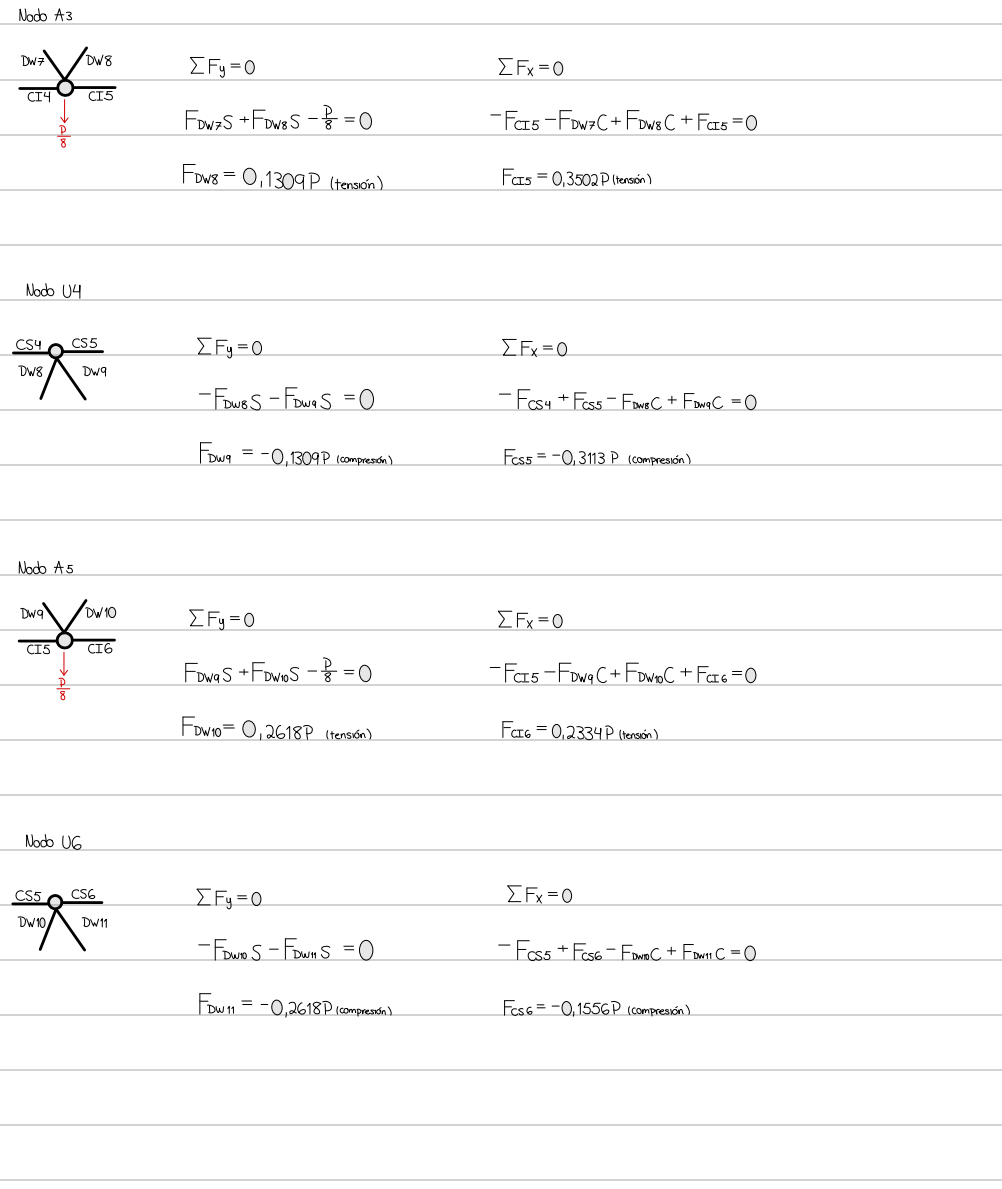
[picture p84: page 4]
Nodo; DSCCT5 I; 394 Hension); , 352PHtension); Nodo j; DWSS; Dwa S; DsCdqC; Dwa; 3 94 (compression; , 3 3P (compression; DaS; DaCDCCT; , 26 &P Itension); , 2334PHtension); Nodo UG; CSG; DiC; 26 &Pi compression); 556P(compression)

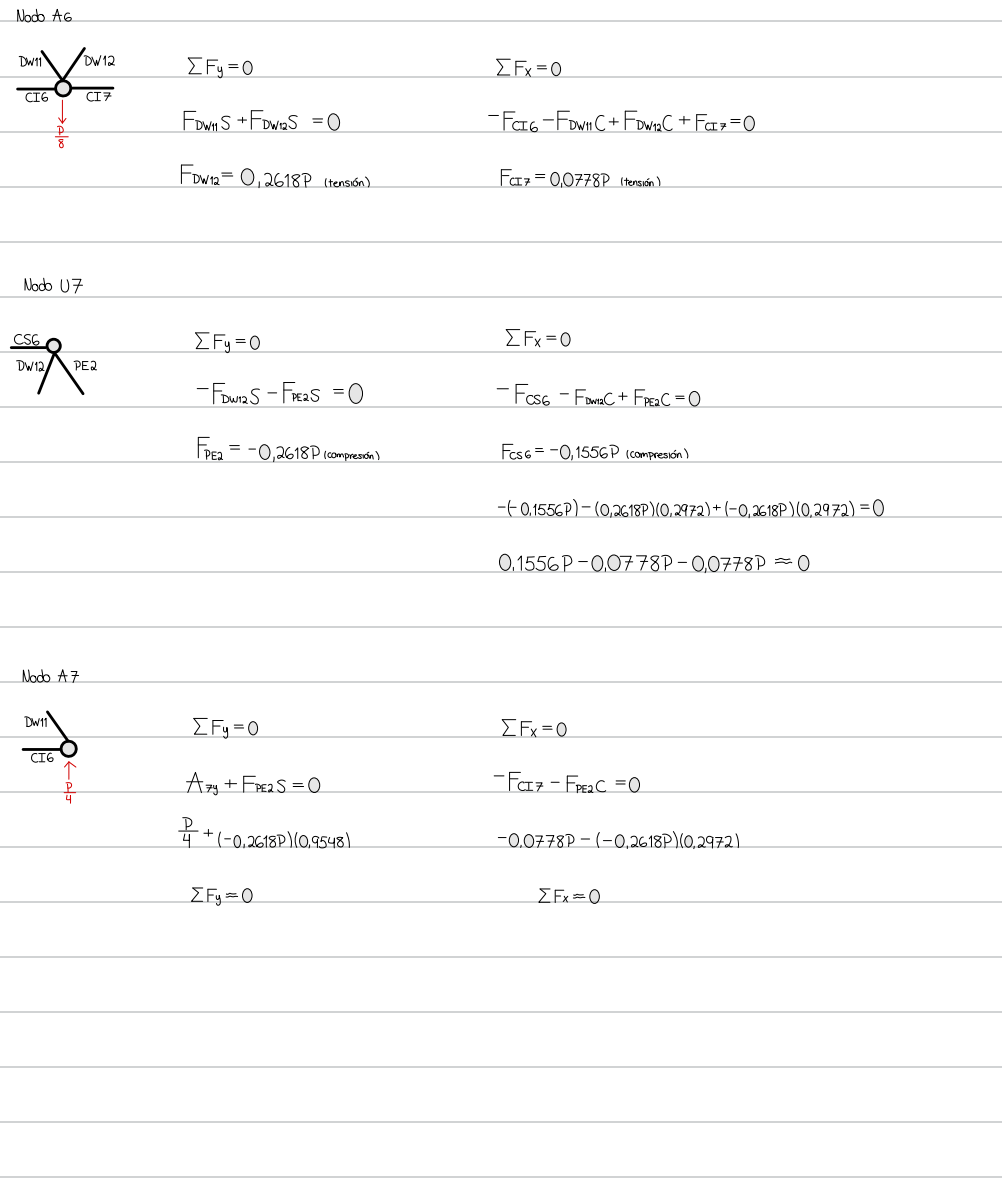
[picture p85: page 5]
Nodo; DaS; DaC; , 26 8P Hension); 8P Itension; Nodo j; CSG; DwaS; PERC; 556P(compression) ,; 26 &Pi compression); PERS
