adrianix360/Proyecto_mecanica_del_solido_2/(commit log)

2026-11-03 Estructura base, README de legado academico y licencia
2026-11-03 Guia interactiva de montaje 3D v02 (GitHub Pages)
2026-11-03 Informe de avance y analisis estructural (nodos y CSiBridge)
    [Especificacion_Puente_Warren.xlsx, Fuerzas_internas_CSiBridge.xlsx]
2026-11-03 Planos de montaje v02 y despiece de corte Cameo v02
    [INVENTARIO_CORTE_v02.csv, INVENTARIO_CORTE_v02.xlsx, T00_PRUEBA.dxf, T01_v02.dxf, T02_v02.dxf, T03_v02.dxf, T04_v02.dxf, T05_v02.dxf]
2026-11-03 QA de la guia, revision de diseno, graficos y carpetas pendientes
    [Verificacion_v01.xlsx]
2026-11-03 Datos historicos: Excel 2018-2019 y 2022 I
    [2018-2019_Resultados_probetas.xlsx, 2022-I_Resultados_probetas.xlsx]
2026-11-03 Datos historicos: probetas 2022 II
2026-11-03 Datos historicos: probetas 2023 I
